AiBoBoMaker/MicroDuck-BoBoRedesign/02-PCB/01-IMU/README.md

# MicroDuck BoBo IMU Module

> 六轴 IMU 模块 — 模拟为 Dynamixel 2.0 设备

## 概述

本目录包含 MicroDuck BoBoRedesign 项目的 **IMU（惯性测量单元）模块** PCB 设计文件。该模块将六轴 IMU 传感器模拟为一个 **Dynamixel 2.0 协议设备**，可直接接入 MicroDuck 的舵机总线，无需额外的通信接口。

> **版本说明：** 当前最新版本（imu_to_dxl）参考自 [kissqy/Microduck-kissqy](https://github.com/kissqy/Microduck-kissqy) 项目，感谢 kissqy 的硬件及固件设计支持。

## 设计文件

| 文件/目录 | 说明 |
|---|---|
| `MicroDuck-BoBo-IMU-2026-09-22.epro2` | IMU 模块初始版本，嘉立创 EDA 专业版工程文件 |
| `MicroDuck-BoBo-imu_to_dxl-2026-10-15.epro2` | IMU 转 Dynamixel 接口版本（最新），嘉立创 EDA 专业版工程文件 |
| `firmware/` | IMU 模块固件目录，含可直接烧录的 `.bin` 文件及完整固件包 |

### 固件文件

| 文件 | 说明 |
|---|---|
| `imu_to_feetech_ReVA_FT6_SYNC15_UART_IRQ_v1.bin` | IMU 转飞特协议固件（Rev.A，FT6 舵机，UART IRQ 模式，v1） |
| `Microduck-Robotd-FT6-R17.tar.gz` | 完整固件包（含飞特 FT6 舵机适配，R17 版本） |

## 打开方式

本项目使用 **嘉立创 EDA 专业版（LCEDA Pro）** 进行设计。

1. 下载安装 [嘉立创 EDA 专业版](https://lceda.cn/page/download)
2. 打开软件，选择 **文件 → 打开工程**
3. 选择 `MicroDuck-BoBo-IMU-2026-09-22.epro2` 文件即可打开

> **注意：** 该文件为 `.epro2` 格式，需要使用嘉立创 EDA **专业版**（Pro）打开，标准版（Std）无法兼容。

## 功能说明

- **六轴 IMU 传感器** — 集成加速度计 + 陀螺仪，提供姿态感知能力
- **Dynamixel 2.0 协议兼容** — 模块在总线上表现为一个标准的 Dynamixel 2.0 设备，可直接使用现有的 Dynamixel 通信库进行读写
- **即插即用** — 无需修改主控固件的通信层，IMU 数据通过 Dynamixel 协议帧传输

## 版本记录

| 版本 | 日期 | 说明 |
|---|---|---|
| v20261015 | 2026-10-15 | 新增 IMU 转 Dynamixel 接口版本（imu_to_dxl），优化通信协议 |
| v20260922 | 2026-09-22 | 初始版本，实现六轴 IMU 模拟为 Dynamixel 2.0 设备 |
