AiBoBoMaker/MicroDuck-BoBoRedesign/03-DuckCode/microduck-hd1910/firmware/policies/README.md

**简体中文** | [English](README.en.md)

R17 v1.0.146 / 官方 0.15.1：唯一 Walk 为 9600 轮行走＋倒地联合模型，全程基础缩放 0.9、头部滤波 0.5、腿部滤波 0.7。旧 14000 轮行走模型从固件删除，仅在 test-data/walk-teacher14000 留作源码数值回归样本。LB 手动起身保留 11000 轮老师（基础 1.0、头腿直通），自动 Stand 槽保持未绑定；起坐、捡取、前滚翻保留。原始训练记录与独立运行配置的执行机制见 ../docs/design/robotd-design.md；导入、唯一槽绑定、旧模型清理和升级保存规则见 ../docs/design/r17-settings-design.md。
