AiBoBoMaker/MicroDuck-BoBoRedesign/03-Code/microduck-hd1910/firmware/BOBO-LICENSE.en.md

# BoBoMaker MicroDuck HD1910 Firmware License

[简体中文](BOBO-LICENSE.md) | **English**

## Project Origin

The firmware code in this directory is developed based on the following projects:

- **[Pollen Robotics Microduck](https://github.com/pollen-robotics/microduck)** — Official Microduck 0.15.1, licensed under [Apache-2.0 License](LICENSE)
- **[kissqy/Microduck-kissqy](https://github.com/kissqy/Microduck-kissqy)** — kissqy's Feetech servo adaptation

Thanks to the official team and kissqy for their open-source contributions. This project has been adapted and modified to support the Feetech HD-1910 servo.

## Purpose

This firmware is used for debugging, calibration, and operation of the MicroDuck robot, accessible via:

- **Android phone / tablet** — Connect to the robot via Web console for debugging and control
- **Desktop browser** — Access the robot's Web interface for calibration, parameter adjustment, and runtime monitoring
- **Gamepad control** — Real-time control via Bluetooth gamepad

## License

- Official Microduck code follows **Apache-2.0 License**
- Third-party components follow their respective original licenses (MIT, Apache-2.0, etc.)
- New adaptation code in this project follows the main project license and is for personal learning, research, and non-commercial use only

## Disclaimer

This project is a personal learning and development project, not an official release. The code may contain unverified parts, and users assume all risks when using it.

---

**Acknowledgments:** Thanks to Pollen Robotics and kissqy for their open-source work that made this project possible.
