AiBoBoMaker/MicroDuck-BoBoRedesign/03-Code/microduck-hd1910/firmware/SELF-TRAINED.zh-CN.md

**简体中文** | [English](SELF-TRAINED.en.md)

R17 v1.0.137 / 官方0.15.1

运行与安装见 console/README.zh-CN.md 和 packaging/README.zh-CN.md。随包模型：粗糙行走老师14000轮、起坐10000轮、低头捡物5000轮、前滚翻10000轮，以及 LB 倒地起身老师11000轮。自动 Stand 为空；LB 使用官方命名技能 stand_test，原地保持使用 Walk。

本次只更换 LB 模型并适配其无滤波合同；原始合同与权重逐字保留。参数来源与逐模型直通机制见 docs/design/r17-settings-design.md。训练标定作为来源记录保留，安装继续使用本机装配标定。
