AiBoBoMaker/MicroDuck-BoBoRedesign/05-BOM/README.md

# MicroDuck BoBoRedesign — 物料清单 (BOM)

> 本项目所需的全部硬件采购清单

## 文件说明

| 文件/目录 | 说明 |
|---|---|
| `MicroDuck购买清单.docx` | 完整购买清单（Word 文档），包含所有物料及可选方案 |
| `01-主板资料整理/` | Radxa ZERO 3W 主板相关资料，含 40pin 引脚说明、原理图及 SMB 设计文件 |

## 购买说明

清单中每个**序号**对应一类物料，部分序号下存在**多个可选项**（如不同型号的舵机、不同规格的轴承、不同方案的驱动板等）。**每个序号只需购买其中一个选项即可**，无需全部购买。

### 示例

以 **序号 2（舵机）** 为例：

| 可选项 | 单价 | 数量 | 总价 |
|---|---|---|---|
| XL330-M288-T（原装） | 258 元 | 15 | 3870 元 |
| HD1910-C001（国产替代） | 99 元 | 15 | 1485 元 |

两种舵机**任选其一**即可。选择国产 HD1910-C001 可大幅降低成本，但需配合本项目的 3D 打印外壳使用。

## 物料总览

| 序号 | 类别 | 说明 |
|---|---|---|
| 1 | 主板 | Radxa ZERO 3W（RK3566） |
| 2 | 舵机 | 原装 XL330 或国产 HD1910-C001（15 个） |
| 3 | TF 卡 | 32G，用于存储系统镜像 |
| 4 | 电源与驱动 | OpenRB-150 / 总线舵机驱动板 / BoBoHat 驱动板（三选一） |
| 5 | IMU | I2C 模块或 BoBo IMU 板 |
| 6 | 3D 打印外壳 | 使用本项目 `01-3DPrint` 中的模型自行打印 |
| 7 | 轴承 | 10×15×3mm 或 16×22×4mm（按需选购） |
| 8 | 螺丝 | 详见文档内明细 |
| 9 | 杜邦线 | 连接各模块用 |

## 工具清单

| 序号 | 工具 | 用途 |
|---|---|---|
| 1 | 螺丝刀 | 组装 |
| 2 | 电烙铁 | PCB 焊接 |

## 主板资料说明

`01-主板资料整理/` 目录包含 Radxa ZERO 3W 主板的相关技术文档：

| 文件 | 说明 |
|---|---|
| `40pin引脚说明.png` | 40pin GPIO 引脚定义图 |
| `radxa_zero_3w_v1.12_schematic.pdf` | Radxa ZERO 3W v1.12 原理图 |
| `radxa_zero_3w_v1110_smb.zip` | Radxa ZERO 3W SMB 设计文件 |

## 更新记录

| 日期 | 内容 |
|---|---|
| 2026-10-12 | 更新购买清单文件名，新增主板资料整理目录 |
| 2026-09-23 | 更新 Radxa 3W 2G+0EMMC 版本，价格降至 299 元 |
