AiBoBoMaker/MicroDuck-BoBoRedesign/05-BOM/MicroDuck购买清单.md

# MicroDuck 购买清单

## 购买清单

**更新记录：**
20260923:更新 Redax 3W 2G+0EMMC 299元版本，比之前下降了50元。

| 序号 | 产品 | 可选项 | 价格 | 链接 | 备注 |
| --- | --- | --- | --- | --- | --- |
| 1 | 主板 | Redax 3W 2G+0EMMC | 299元 | https://item.taobao.com/item.htm?id=763812025816 | 配置：2GB RAM / 无eMMC / 带排针（【Microduck 原版主板】）；同款历史参考价 ¥309.00 |
| 2 | 舵机 | XL330-M288-T | 258*15=3870 | 暂无货 | 与下行 HD1910-C001 二选一 |
|  |  | HD1910-C001 | 119*15=1785 | https://item.taobao.com/item.htm?id=1078248851201 | 款式 HD-1910-C001；深圳飞特舵机工厂店；[团购99元/个]，需要的话可以加下方作者微信 |
| 3 | tf卡 | 32G | 30元 | 狗东到处都是 |  |
| 4 | 双电源供电和舵机驱动 | OpenRB150 | 265元 | https://item.taobao.com/item.htm?id=683303639951 |  |
|  |  | 总线舵机驱动板 | 26.73元 | https://item.taobao.com/item.htm?id=738817173460 |  |
|  |  | Hat驱动板 | 119元 | 已测试 | 据最新版本在官方版本上精简了线路 |
|  |  | 舵机Hub电源优化板 | 69元 | 已测试 | 可以将4路舵机总线合并为一条与HAT连接，并且加入大电容避免鸭子重启断电 |
| 5 | IMU | I2C | 26 | https://item.taobao.com/item.htm?id=1080835106904 | 程序自动切换 |
|  |  | BoBo IMU板 | 89元 | 走飞特的总线协议 | 程序自动切换 |
| 6 | 轴承 | 10*15*3mm | 0.97元*5 | https://item.taobao.com/item.htm?id=745755245799 | 对应 6700 开式【轴承钢·精品级】10\*15\*3MM；参考数量 5 只（¥1.94/只，小计 ¥9.70）；尺寸顺序为内径×外径×宽度 |
|  |  | 16*22*4mm | 2.91元*12 | https://item.taobao.com/item.htm?id=745843714288 | 对应 ET2216【精品级】16\*22\*4MM[轴承钢]；参考数量 12 只（¥2.91/只，小计 ¥34.92）；尺寸顺序为内径×外径×宽度 |
|  |  | 623ZZ（623 内3外10厚4） | 1.50元*8  | https://item.taobao.com/item.htm?id=618009195719 | 滑轮选配 |
| 7 | 螺丝 | M2*7 沉头 |  | 100 |  |
|  |  | M2.5*8 内六角 |  | 12 |  |
| 9 | 摄像头 | IMX219 160度摄像头（SKU：IMX219 160度摄像头） | 64.35元/个 ×1＝64.35元 | https://item.taobao.com/item.htm?id=1083291197130&skuId=6300750750661 | 树莓派零售商；实际价格以下单时为准 |
| 10 | 测距 | 8×8 ToF 模块（VL53L5X V2 配盖片，商品标题 VL53L5CX） | 49.50元/个 ×1＝49.50元 | https://item.taobao.com/item.htm?id=737603917521 | 外接模块，不是 PCB 上的裸芯片；都会明武电子；接线和供电按已验证方案 |
| 11 | 扬声器 | 3525 腔体 / 4Ω 3W | 3.08元/个 ×1＝3.08元 | https://item.taobao.com/item.htm?id=683920556900 | 深圳市优信电子科技有限公司；确认插头与所购 HAT 接口匹配，使用对应成品线或成品转接线 |
| 12 | 手柄 | 盖世小鸡启明星2无线游戏手柄（蓝牙 / Xbox 模式） | 89.91元/个 ×1＝89.91元 | https://item.taobao.com/item.htm?id=825069839018 | 颜色及套装内容以商品页为准 |
| 13 | 电池 | NP-F550 电池与双充套装（沣标 2200mAh，2 电＋标准双充） | 84.59元/套 ×1＝84.59元 | https://item.taobao.com/item.htm?id=585415365001 | 原文款式：【NP-F550补光灯专用▲2200mAh】2电+标准双充套裝；可用 XH2.54 电源线接电池仓 M2.6 螺丝触点，或直接插接电压极性匹配的 XH2.54 电池，或将 XH2.54 电源线焊到香蕉板取电；电池接入配件与运费另计 |
| 14 | 舵机线 | AMP2.0 3P 舵机线 20cm（双头反向） | 1.50元/条 ×30＝45.00元 | https://item.taobao.com/item.htm?id=825340808235 | 200mm / 1007 / 24AWG / 3P / AMP2.0；永茂电子；数量含备料，10cm 与 20cm 按实际走线位置选择 |
| 15 | 舵机线 | AMP2.0 3P 舵机线 10cm（双头反向） | 1.50元/条 ×30＝45.00元 | https://item.taobao.com/item.htm?id=825340808235 | 100mm / 1007 / 24AWG / 3P / AMP2.0；数量按实际线束方案准备，与 20cm 是不同长度选项 |

## 交流入口

选型、渠道和采购数量上有拿不准的地方，欢迎加微信直接问；点击图片可查看原图。

BoBoMaker 微信二维码
