AiBoBoMaker/MicroDuck-BoBoRedesign/05-BOM/MicroDuck购买清单.docx

购买清单：

更新记录：
20260923:更新 Redax 3W 2G+0EMMC 299元版本，比之前下降了50元。

序号 | 产品 | 可选项 | 价格 | 链接
1 | 主板 | Redax 3W 2G+0EMMC | 299元 | 【淘宝】升级版运费险 https://e.tb.cn/h.8FfZDadQV5C0b2X?tk=LW8CTlPJnJu CZ009 「瑞莎 Radxa 迷你主板 ZERO 3W RK3566 四核CPU WiFi6 Microduck」 点击链接直接打开 或者 淘宝搜索直接打开
2 | 舵机 | XL330-M288-T | 258*15=3870 | 暂无货
| | HD1910-C001 | 99*15=1485 | 【淘宝】7天无理由退货 https://e.tb.cn/h.8vlnLBm3vsoUvdQ?tk=07A0TllYnvq CZ001 「【预售15天】飞特金属齿机器鸭具身智能开源AI专用串口总线舵机」 点击链接直接打开 或者 淘宝搜索直接打开
3 | tf卡 | 32G | 30元
4 | 双电源供电和舵机驱动 | OpenRB150 | 265元 | 【淘宝】7天无理由退货 https://e.tb.cn/h.8FfW52mcYxoCk1K?tk=wsicTlPE6Pt HU926 「OPENRB-150 开源Arduino嵌入式控制器open RB-150 XL330用 RB 150」 点击链接直接打开 或者 淘宝搜索直接打开
| | 总线舵机驱动板 | 26.73元 | 【淘宝】假一赔四 https://e.tb.cn/h.8wbdGcaYUUTWSvW?tk=4T19TlPs9R9 HU287 「微雪 总线舵机驱动板适用ST/SC系列Servo UART通信支持树莓派4」 点击链接直接打开 或者 淘宝搜索直接打开
| | BoBoHat驱动板 | 40元 | 待测试
5 | IMU | I2C | 26 | 【淘宝】7天无理由退货 https://e.tb.cn/h.jb5fw9IyarVb7lf?tk=2L9MTr3N0dO CZ028 「LSM6DSV16XTR加速度6DOF六轴IMU陀螺仪传感器模块兼容ROS WDS601M」 点击链接直接打开 或者 淘宝搜索直接打开
| | BoBo IMU板 | 25元 | 程序通，经测试存在一定问题，需要修正数据
6 | 3D打印外壳 | 见项目文件 | 约50元
7 | 轴承 | 10*15*3mm | 0.97元* | 【淘宝】7天无理由退货 https://e.tb.cn/h.8vl9a2x4N8zy9sn?tk=q1uGTlPxIwN tG-#22>lD 「高速不锈钢薄壁轴承61700ZZ S6700-2RS 尺寸10*15*4*3mm 6700开式」 点击链接直接打开 或者 淘宝搜索直接打开
| | 16*22*4mm | 2.91元* | 【淘宝】7天无理由退货 https://e.tb.cn/h.8u4OdDKUHmoniC8?tk=qjSqTlPygf9 HU071 「不锈钢英制超薄壁轴承SET2216 DDA2216 MR1622 16224尺寸16*22*4」 点击链接直接打开 或者 淘宝搜索直接打开
8 | 螺丝 | M2*
9 | 杜邦线 | 3米
10 | 电池 | 2s 7.4v电池 | 56元 | 【淘宝】假一赔四 https://e.tb.cn/h.jZrMAQfANkdKbLP?tk=s0bFTr3pWLN HU006 「7.4V锂电池组2S 18650智能车机器人舵机多足8.4V带保护板电源塔克」 点击链接直接打开 或者 淘宝搜索直接打开

工具类

1 | 螺丝刀
2 | 电烙铁
3 | 热缩管
