AiBoBoMaker/MicroDuck-BoBoRedesign/05-BOM/01-主板资料整理/40pin引脚说明.png

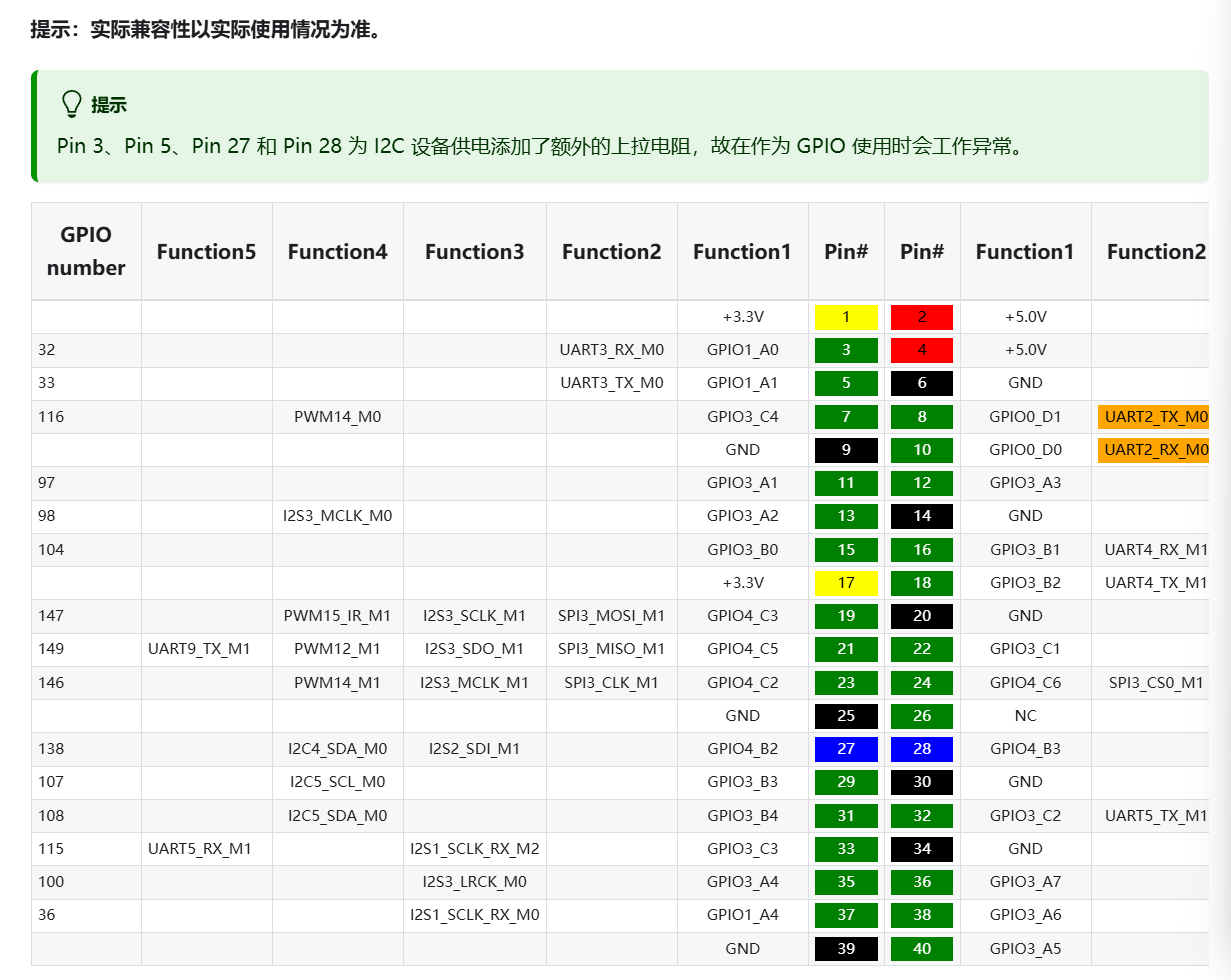
05-BOM/01-主板资料整理/40pin引脚说明.png
