AiBoBoMaker/MicroDuck-BoBoRedesign/01-3DPrint/01-XL330-M288-T/左大腿_白色x2.stl

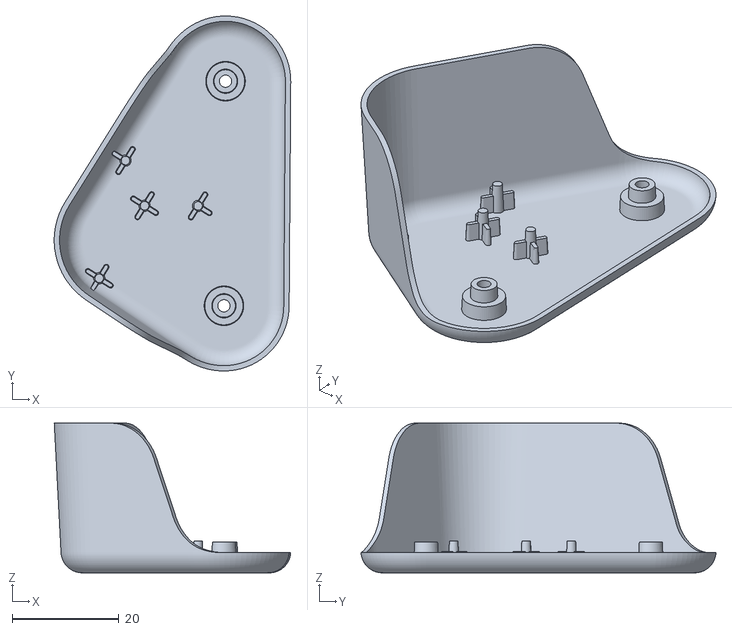
[picture p4: CAD file, 2026-09-24]
01-3DPrint/01-XL330-M288-T/左大腿_白色x2.stl
44.2 x 66.4 x 28.0
