AiBoBoMaker/MicroDuck-BoBoRedesign/01-3DPrint/02-HD-1910-C001/stl模型/TPU部分/滑轮.stl

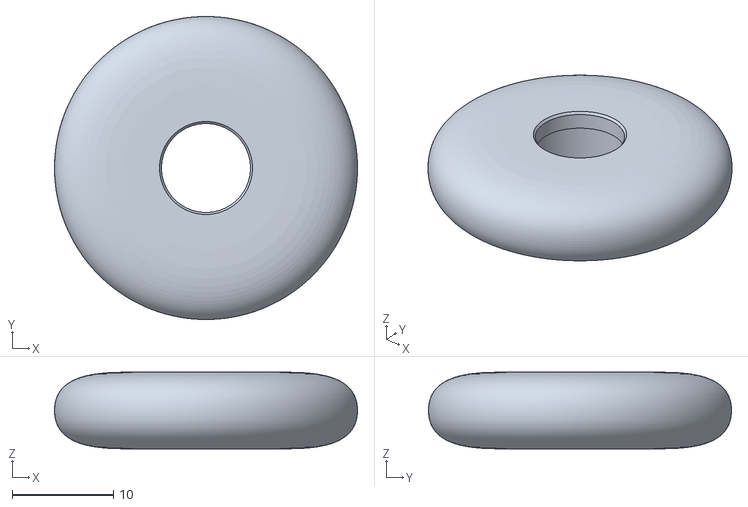
[picture p5: CAD file, 2026-10-23]
01-3DPrint/02-HD-1910-C001/stl模型/TPU部分/滑轮.stl
30.0 x 30.0 x 7.60
