AiBoBoMaker/MicroDuck-BoBoRedesign/01-3DPrint/02-HD-1910-C001/stl模型/支撑部分/右膝支撑.stl

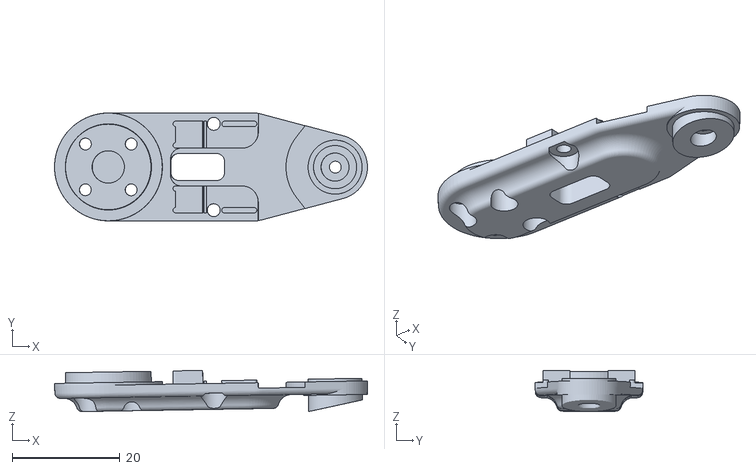
[picture p6: CAD file, 2026-10-23]
01-3DPrint/02-HD-1910-C001/stl模型/支撑部分/右膝支撑.stl
58.0 x 20.0 x 7.63
