AiBoBoMaker/MicroDuck-BoBoRedesign/01-3DPrint/02-HD-1910-C001/stl模型/橙色部分/头部集成板.stl

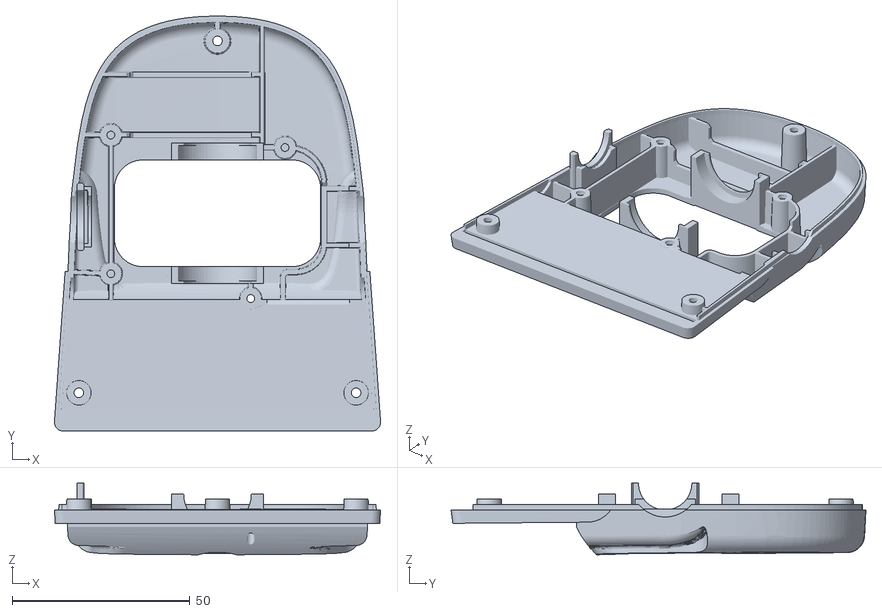
[picture p7: CAD file, 2026-10-23]
01-3DPrint/02-HD-1910-C001/stl模型/橙色部分/头部集成板.stl
91.8 x 116.7 x 20.1
