AiBoBoMaker/MicroDuck-BoBoRedesign/01-3DPrint/02-HD-1910-C001/stl模型/躯体部分/左胯外盖.stl

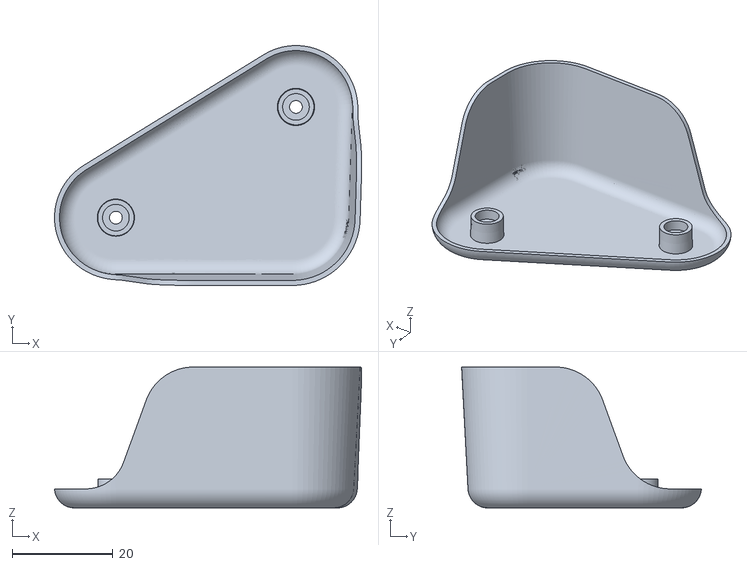
[picture p8: CAD file, 2026-10-23]
01-3DPrint/02-HD-1910-C001/stl模型/躯体部分/左胯外盖.stl
61.0 x 47.7 x 28.0
