AiBoBoMaker/MicroDuck-BoBoRedesign/01-3DPrint/02-HD-1910-C001/老版/小腿固定件x2.stl

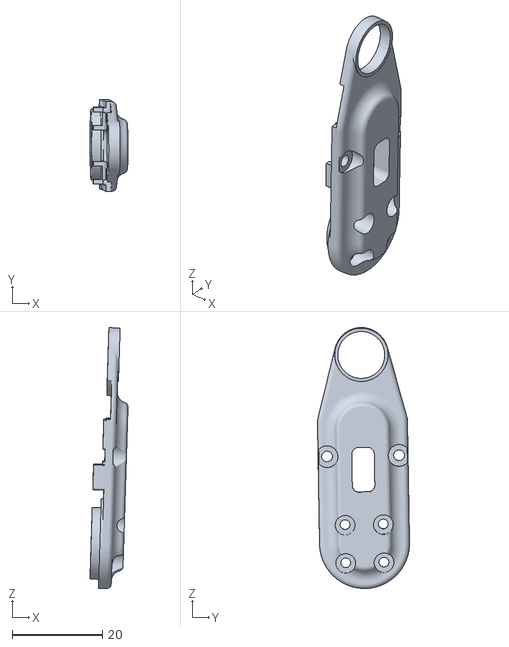
[picture p9: CAD file, 2026-09-19]
01-3DPrint/02-HD-1910-C001/老版/小腿固定件x2.stl
8.45 x 20.5 x 58.0
