AiBoBoMaker/MicroDuck-BoBoRedesign/01-3DPrint/0位支架.stp

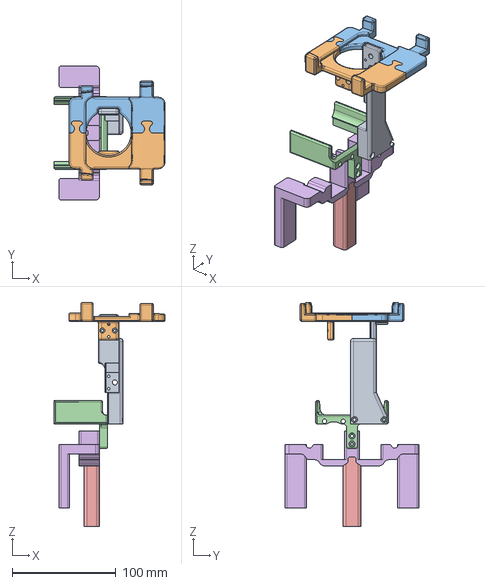
[picture p10: CAD file, 2026-11-11]
01-3DPrint/0位支架.stp
106.7 x 129.0 x 215.8 mm
