AiBoBoMaker/MicroDuck-BoBoRedesign/01-3DPrint/02-HD-1910-C001/stl模型/支撑部分/颈部固定左.stl

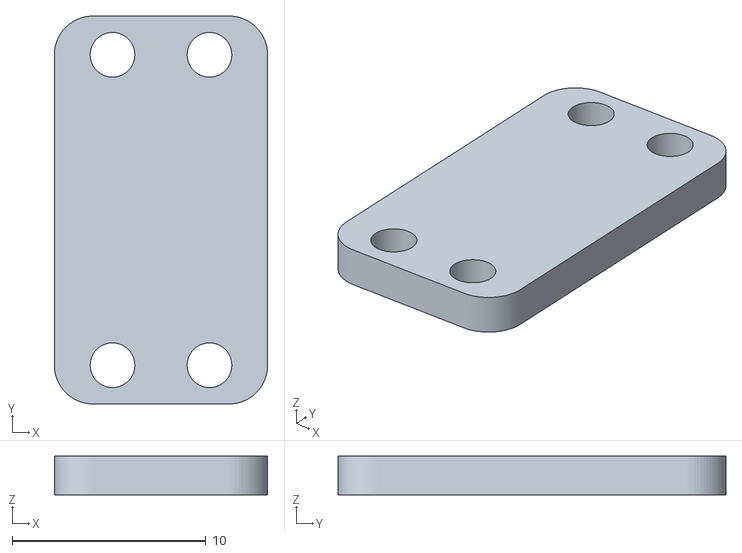
[picture p11: CAD file, 2026-10-23]
01-3DPrint/02-HD-1910-C001/stl模型/支撑部分/颈部固定左.stl
11.0 x 20.0 x 2.00
