AiBoBoMaker/MicroDuck-BoBoRedesign/01-3DPrint/02-HD-1910-C001/stl模型/橙色部分/右脚.stl

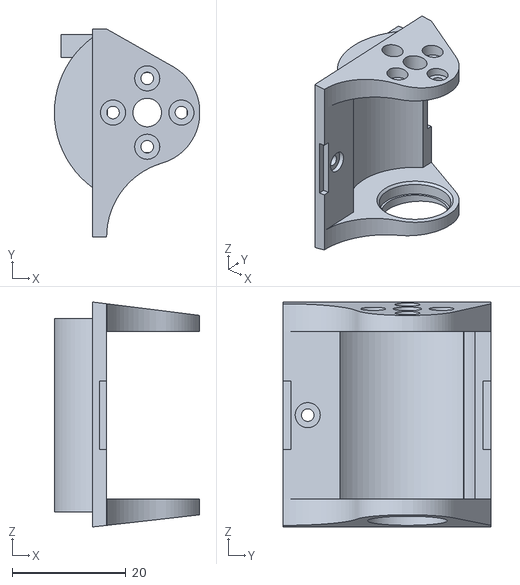
[picture p12: CAD file, 2026-10-23]
01-3DPrint/02-HD-1910-C001/stl模型/橙色部分/右脚.stl
25.5 x 36.5 x 39.5
