AiBoBoMaker/MicroDuck-BoBoRedesign/01-3DPrint/02-HD-1910-C001/stl模型/黑色部分/屁托.dxf

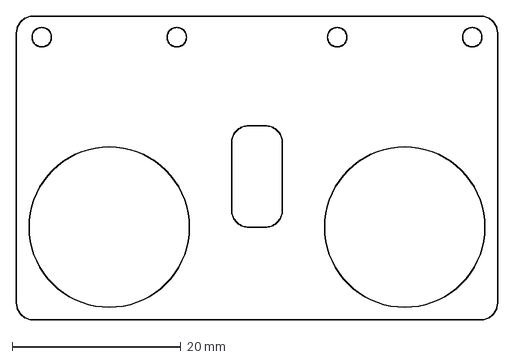
[picture p13: CAD file, 2026-11-11]
01-3DPrint/02-HD-1910-C001/stl模型/黑色部分/屁托.dxf
57.0 x 36.0 mm
