AiBoBoMaker/MicroDuck-BoBoRedesign/01-3DPrint/02-HD-1910-C001/老版/右脚x1.stl

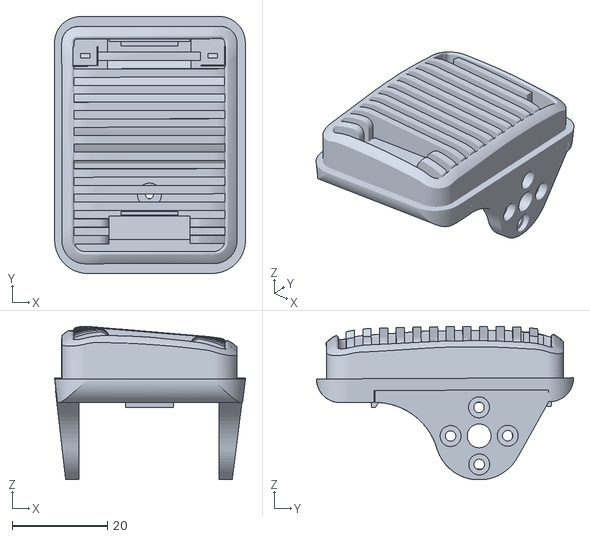
[picture p14: CAD file, 2026-09-19]
01-3DPrint/02-HD-1910-C001/老版/右脚x1.stl
40.1 x 54.0 x 32.2
