AiBoBoMaker/MicroDuck-BoBoRedesign/01-3DPrint/01-XL330-M288-T/右脚x1.stl

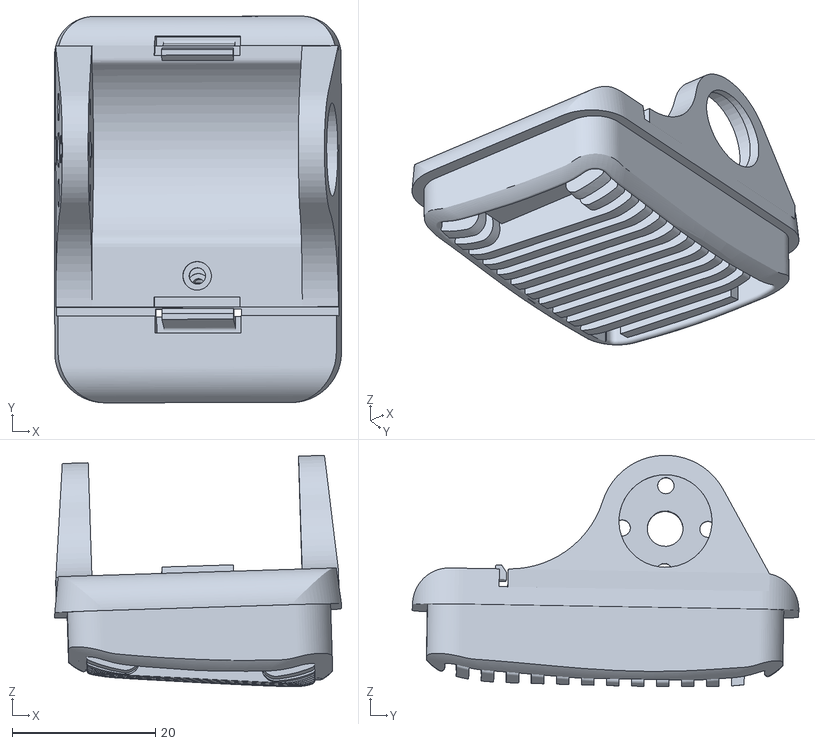
[picture p15: CAD file, 2026-09-24]
01-3DPrint/01-XL330-M288-T/右脚x1.stl
40.1 x 54.0 x 32.3
