AiBoBoMaker/MicroDuck-BoBoRedesign/01-3DPrint/02-HD-1910-C001/stl模型/支撑部分/头部旋转.stl

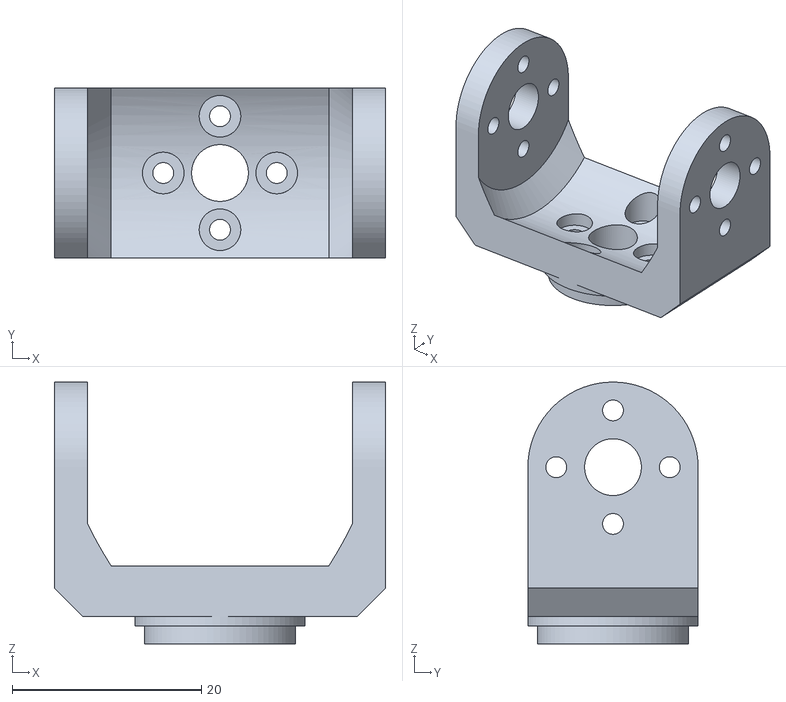
[picture p16: CAD file, 2026-10-23]
01-3DPrint/02-HD-1910-C001/stl模型/支撑部分/头部旋转.stl
35.0 x 18.0 x 27.7
