AiBoBoMaker/MicroDuck-BoBoRedesign/01-3DPrint/02-HD-1910-C001/stl模型/躯体部分/电池仓_M2.5螺丝_HUB组合.stl

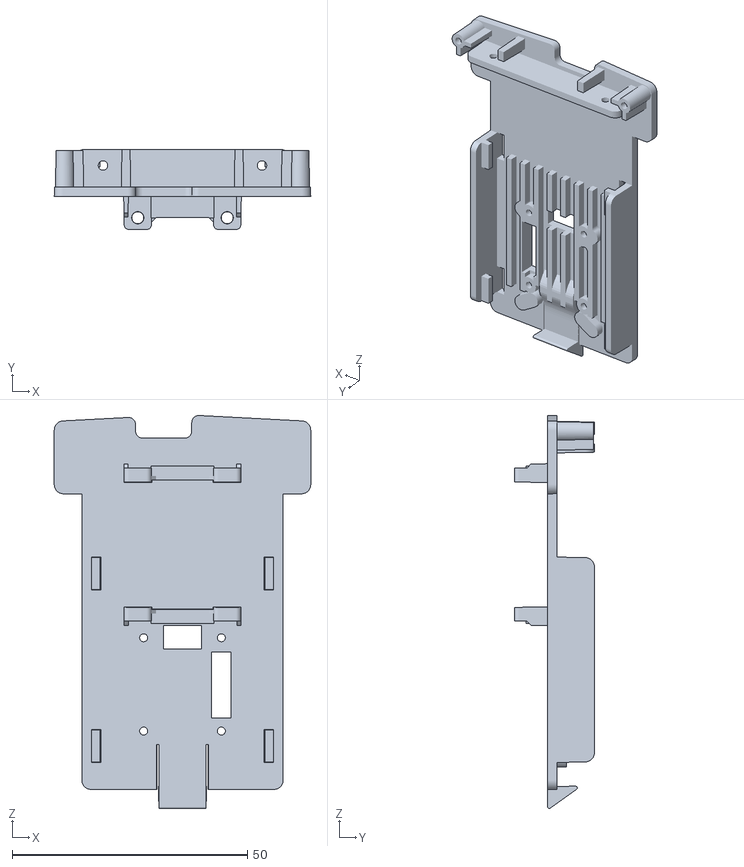
[picture p17: CAD file, 2026-10-23]
01-3DPrint/02-HD-1910-C001/stl模型/躯体部分/电池仓_M2.5螺丝_HUB组合.stl
54.5 x 17.0 x 83.5
