AiBoBoMaker/MicroDuck-BoBoRedesign/01-3DPrint/02-HD-1910-C001/stl模型/黑色部分/腿 .dxf

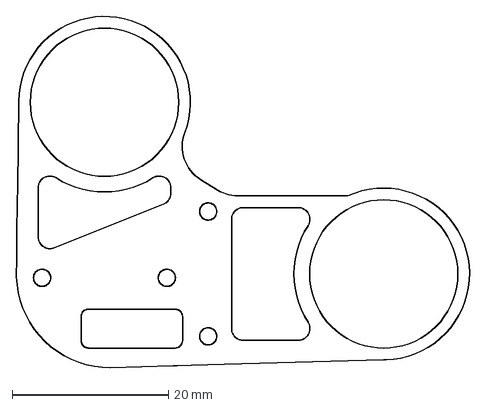
[picture p18: CAD file, 2026-11-11]
01-3DPrint/02-HD-1910-C001/stl模型/黑色部分/腿 .dxf
58.1 x 45.0 mm
