AiBoBoMaker/MicroDuck-BoBoRedesign/01-3DPrint/02-HD-1910-C001/老版/躯干舵机底座x1.stl

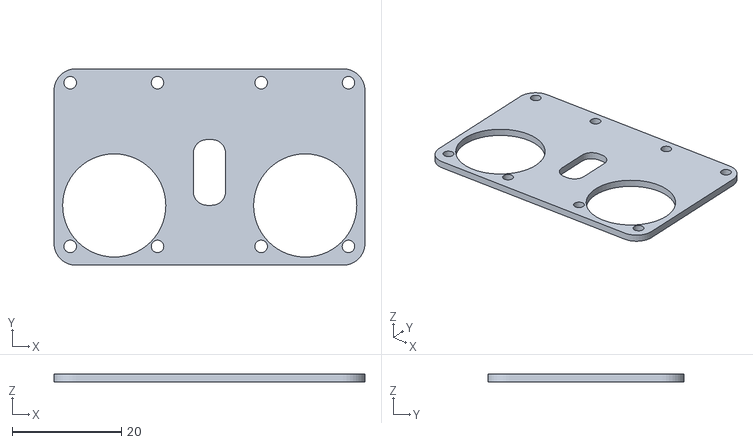
[picture p19: CAD file, 2026-09-19]
01-3DPrint/02-HD-1910-C001/老版/躯干舵机底座x1.stl
57.0 x 36.0 x 1.50
