AiBoBoMaker/MicroDuck-BoBoRedesign/01-3DPrint/01-XL330-M288-T/舵盘x4.stl

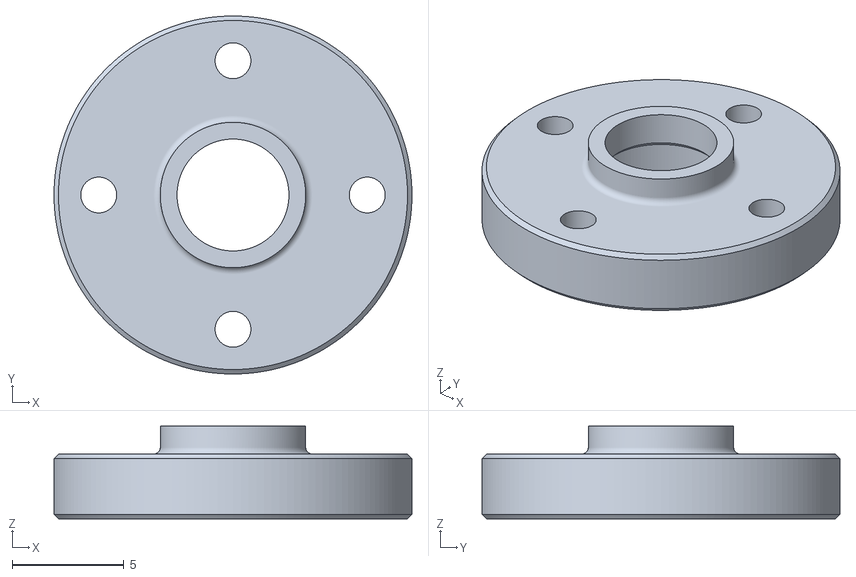
[picture p20: CAD file, 2026-09-24]
01-3DPrint/01-XL330-M288-T/舵盘x4.stl
16.0 x 16.0 x 4.15
