AiBoBoMaker/MicroDuck-BoBoRedesign/01-3DPrint/02-HD-1910-C001/stl模型/橙色部分/滑轮支架左.stl

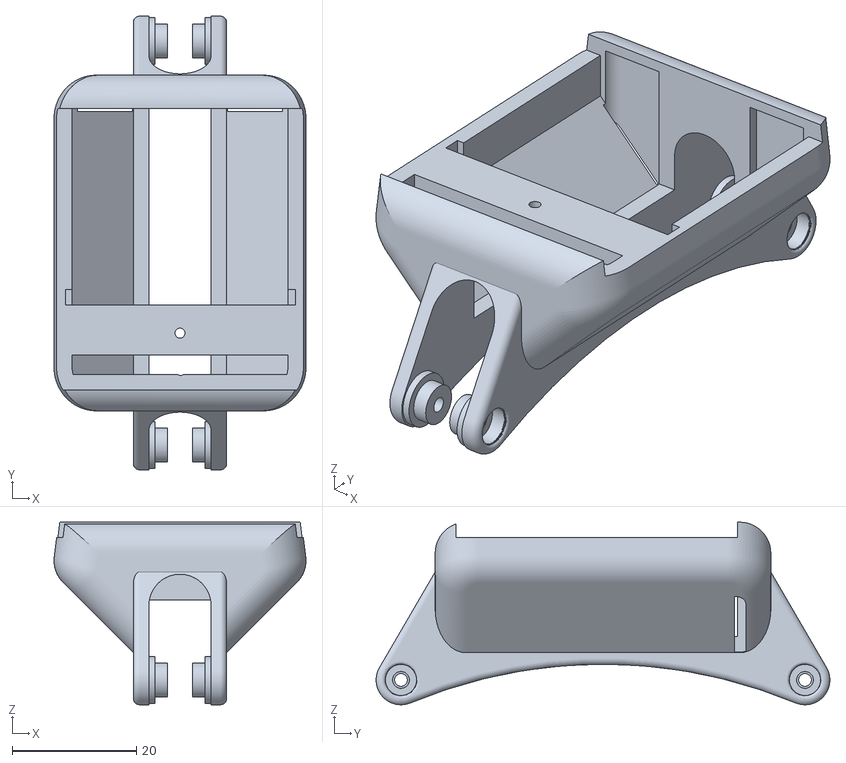
[picture p21: CAD file, 2026-10-23]
01-3DPrint/02-HD-1910-C001/stl模型/橙色部分/滑轮支架左.stl
40.5 x 73.0 x 29.4
