AiBoBoMaker/MicroDuck-BoBoRedesign/01-3DPrint/02-HD-1910-C001/stl模型/躯体部分/右壳.stl

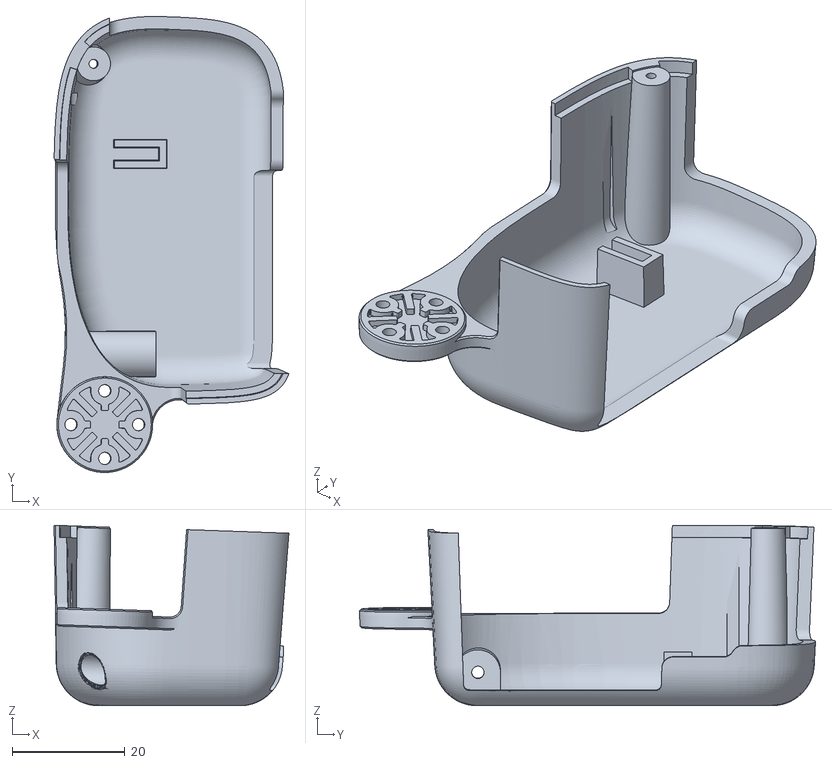
[picture p22: CAD file, 2026-10-23]
01-3DPrint/02-HD-1910-C001/stl模型/躯体部分/右壳.stl
41.7 x 80.9 x 32.0
