AiBoBoMaker/MicroDuck-BoBoRedesign/01-3DPrint/02-HD-1910-C001/stl模型/黑色部分/左腿固定片2.stl

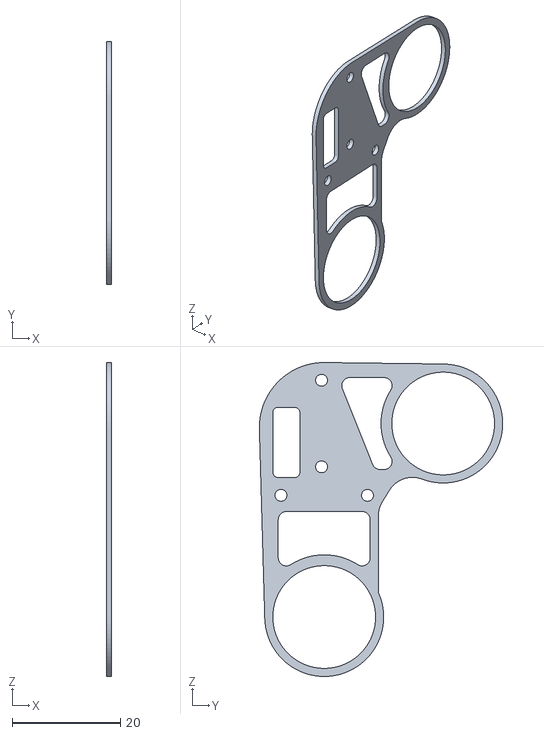
[picture p23: CAD file, 2026-11-11]
01-3DPrint/02-HD-1910-C001/stl模型/黑色部分/左腿固定片2.stl
1.00 x 45.0 x 58.1
