AiBoBoMaker/MicroDuck-BoBoRedesign/01-3DPrint/02-HD-1910-C001/老版/电池支撑架x1.stl

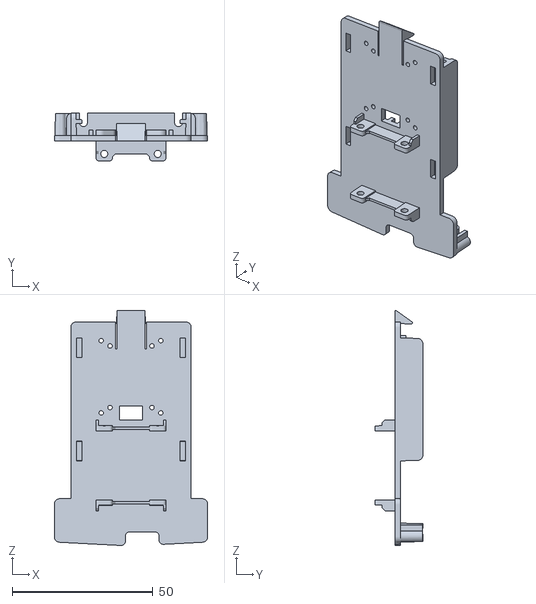
[picture p24: CAD file, 2026-09-19]
01-3DPrint/02-HD-1910-C001/老版/电池支撑架x1.stl
54.5 x 17.0 x 83.5
