AiBoBoMaker/MicroDuck-BoBoRedesign/01-3DPrint/01-XL330-M288-T/大腿根x2.stl

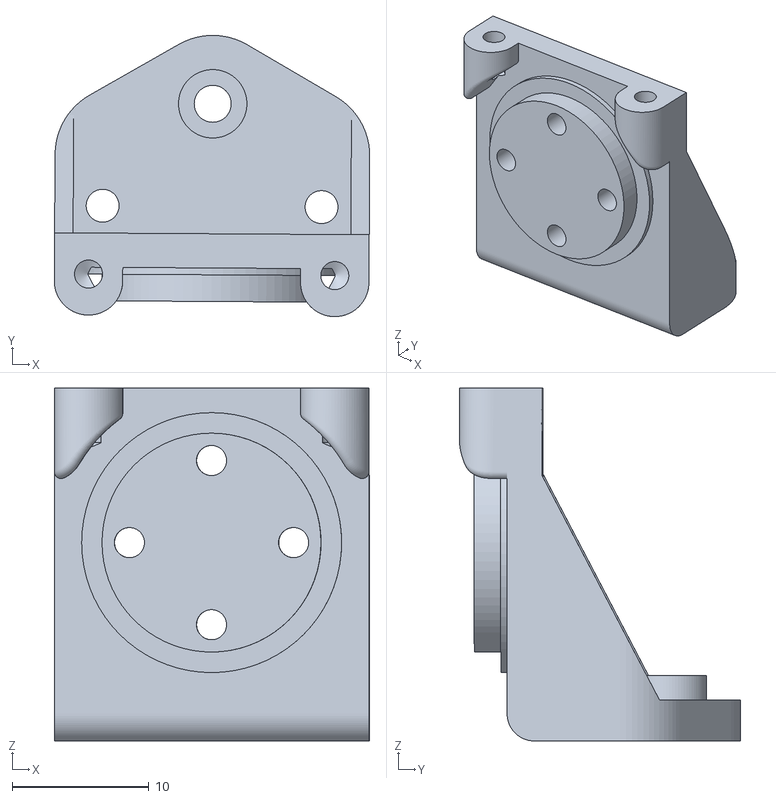
[picture p25: CAD file, 2026-09-24]
01-3DPrint/01-XL330-M288-T/大腿根x2.stl
23.1 x 20.6 x 25.8
