AiBoBoMaker/MicroDuck-BoBoRedesign/01-3DPrint/02-HD-1910-C001/stl模型/支撑部分/脸.stl

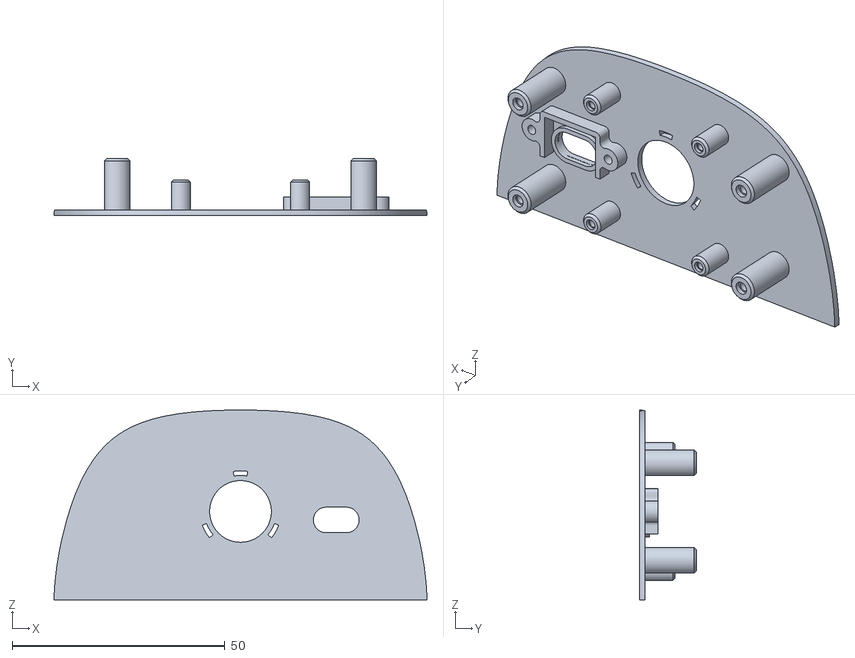
[picture p26: CAD file, 2026-10-23]
01-3DPrint/02-HD-1910-C001/stl模型/支撑部分/脸.stl
87.7 x 13.3 x 44.6
