AiBoBoMaker/MicroDuck-BoBoRedesign/01-3DPrint/02-HD-1910-C001/stl模型/橙色部分/左脚掌.stl

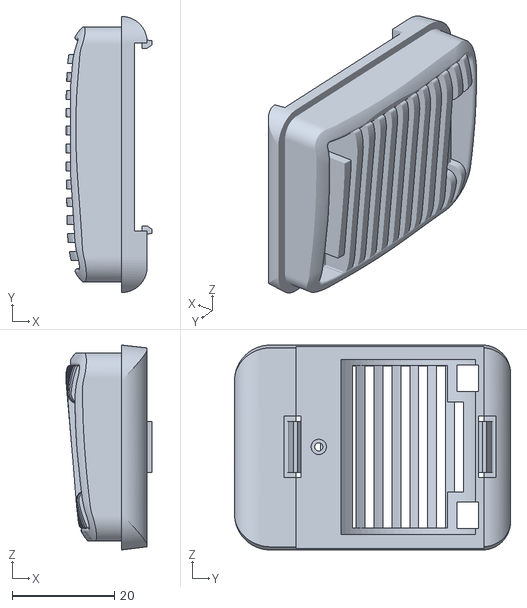
[picture p27: CAD file, 2026-10-23]
01-3DPrint/02-HD-1910-C001/stl模型/橙色部分/左脚掌.stl
16.9 x 54.0 x 40.1
