AiBoBoMaker/MicroDuck-BoBoRedesign/01-3DPrint/02-HD-1910-C001/stl模型/躯体部分/左壳.stl

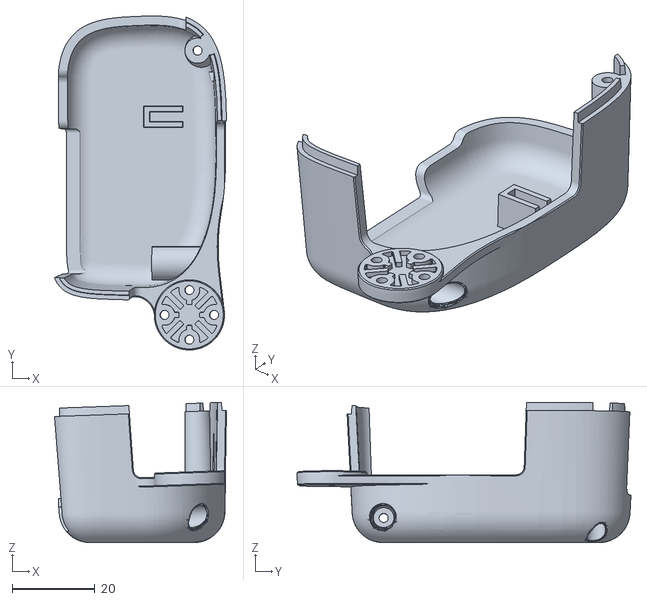
[picture p28: CAD file, 2026-10-23]
01-3DPrint/02-HD-1910-C001/stl模型/躯体部分/左壳.stl
41.7 x 80.9 x 34.0
