AiBoBoMaker/MicroDuck-BoBoRedesign/01-3DPrint/02-HD-1910-C001/stl模型/黑色部分/右胯旋转.stl

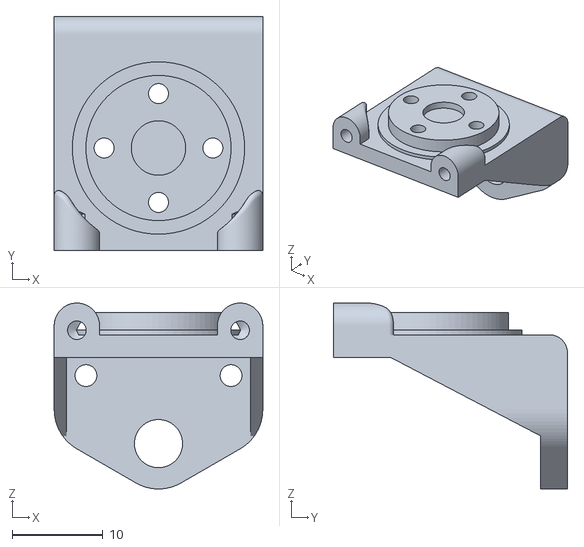
[picture p29: CAD file, 2026-10-23]
01-3DPrint/02-HD-1910-C001/stl模型/黑色部分/右胯旋转.stl
23.0 x 25.8 x 20.5
