AiBoBoMaker/MicroDuck-BoBoRedesign/01-3DPrint/02-HD-1910-C001/老版/大腿根x2.stl

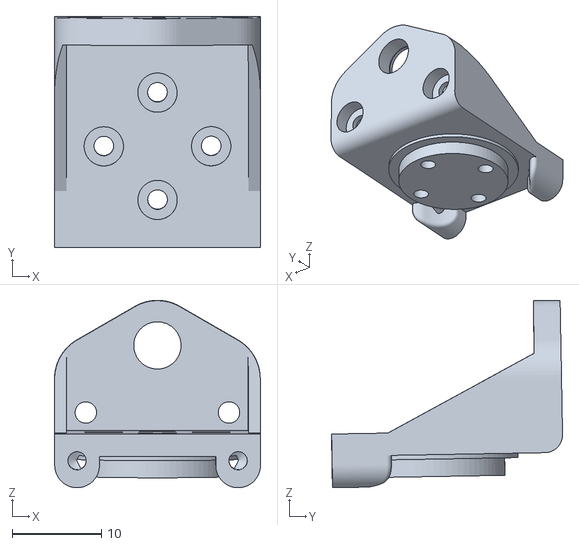
[picture p30: CAD file, 2026-09-19]
01-3DPrint/02-HD-1910-C001/老版/大腿根x2.stl
23.0 x 25.8 x 20.9
