AiBoBoMaker/MicroDuck-BoBoRedesign/01-3DPrint/01-XL330-M288-T/左脚底板x1.stl

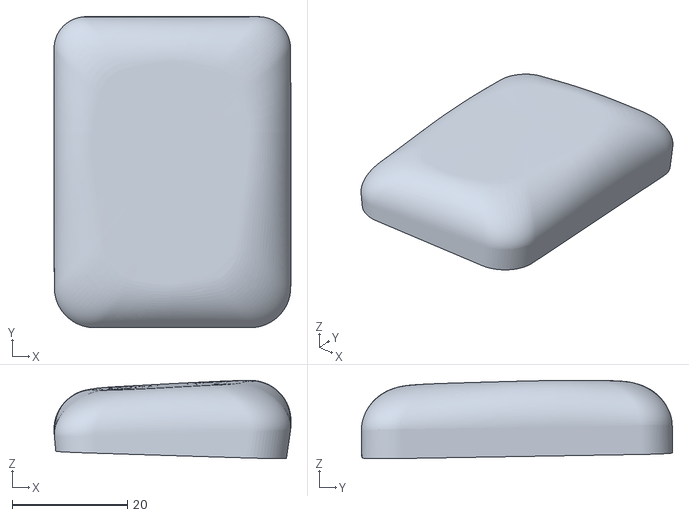
[picture p31: CAD file, 2026-09-19]
01-3DPrint/01-XL330-M288-T/左脚底板x1.stl
41.2 x 54.1 x 13.6
