AiBoBoMaker/MicroDuck-BoBoRedesign/01-3DPrint/02-HD-1910-C001/stl模型/橙色部分/眼睛.stl

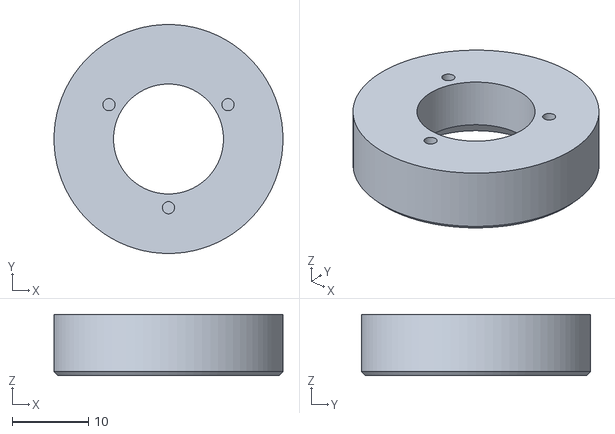
[picture p32: CAD file, 2026-10-23]
01-3DPrint/02-HD-1910-C001/stl模型/橙色部分/眼睛.stl
30.0 x 30.0 x 8.00
