AiBoBoMaker/MicroDuck-BoBoRedesign/01-3DPrint/02-HD-1910-C001/stl模型/躯体部分/头盖.stl

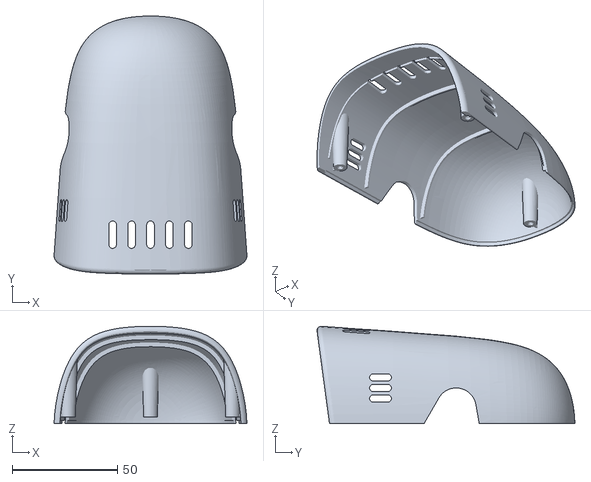
[picture p33: CAD file, 2026-10-23]
01-3DPrint/02-HD-1910-C001/stl模型/躯体部分/头盖.stl
91.8 x 122.7 x 46.3
