AiBoBoMaker/MicroDuck-BoBoRedesign/01-3DPrint/02-HD-1910-C001/stl模型/黑色部分/头部侧倾.stl

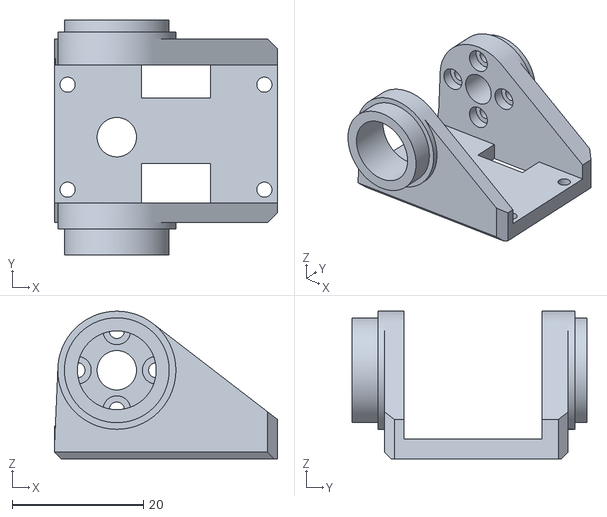
[picture p34: CAD file, 2026-10-23]
01-3DPrint/02-HD-1910-C001/stl模型/黑色部分/头部侧倾.stl
34.0 x 35.9 x 22.5
