AiBoBoMaker/MicroDuck-BoBoRedesign/01-3DPrint/02-HD-1910-C001/老版/右腿内测x1.stl

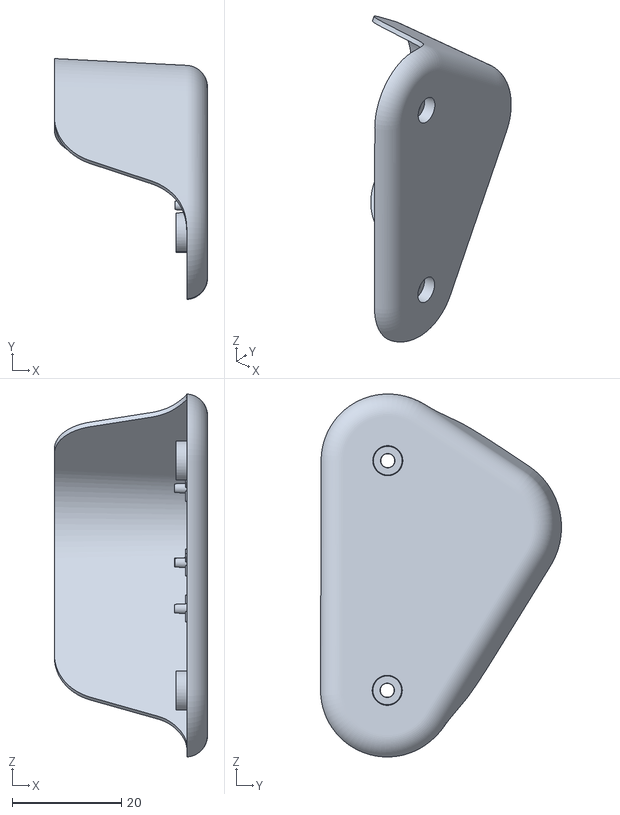
[picture p35: CAD file, 2026-09-19]
01-3DPrint/02-HD-1910-C001/老版/右腿内测x1.stl
28.0 x 44.1 x 66.4
