AiBoBoMaker/MicroDuck-BoBoRedesign/01-3DPrint/01-XL330-M288-T/前脸x1.stl

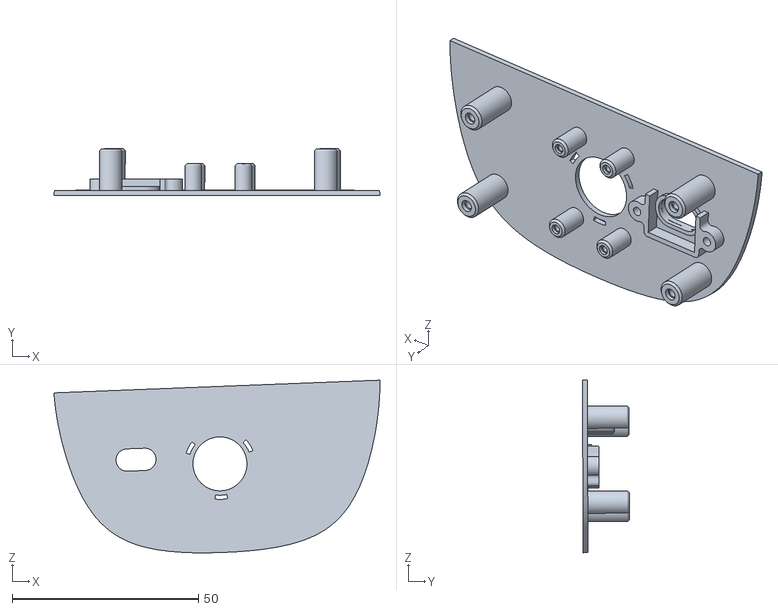
[picture p36: CAD file, 2026-09-19]
01-3DPrint/01-XL330-M288-T/前脸x1.stl
87.6 x 12.7 x 46.4
