AiBoBoMaker/MicroDuck-BoBoRedesign/01-3DPrint/02-HD-1910-C001/老版/大腿固定件x2.stl

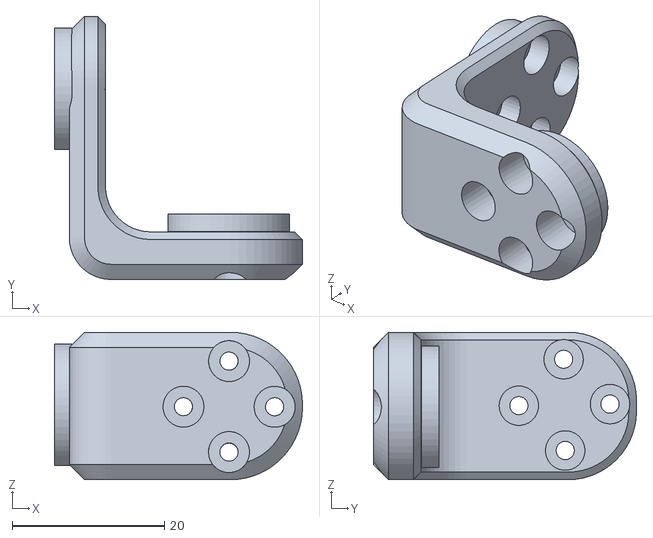
[picture p37: CAD file, 2026-09-19]
01-3DPrint/02-HD-1910-C001/老版/大腿固定件x2.stl
32.6 x 34.6 x 19.4
