AiBoBoMaker/MicroDuck-BoBoRedesign/01-3DPrint/01-XL330-M288-T/头盖骨x1.stl

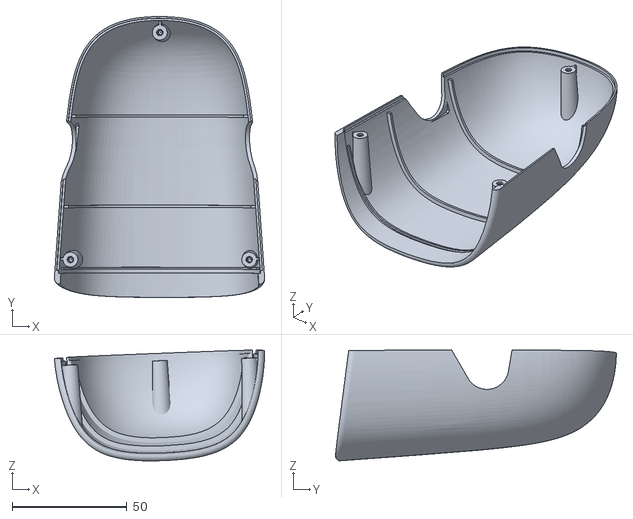
[picture p38: CAD file, 2026-09-19]
01-3DPrint/01-XL330-M288-T/头盖骨x1.stl
91.7 x 122.5 x 48.3
