AiBoBoMaker/MicroDuck-BoBoRedesign/01-3DPrint/02-HD-1910-C001/老版/左右腿内测x2.stl

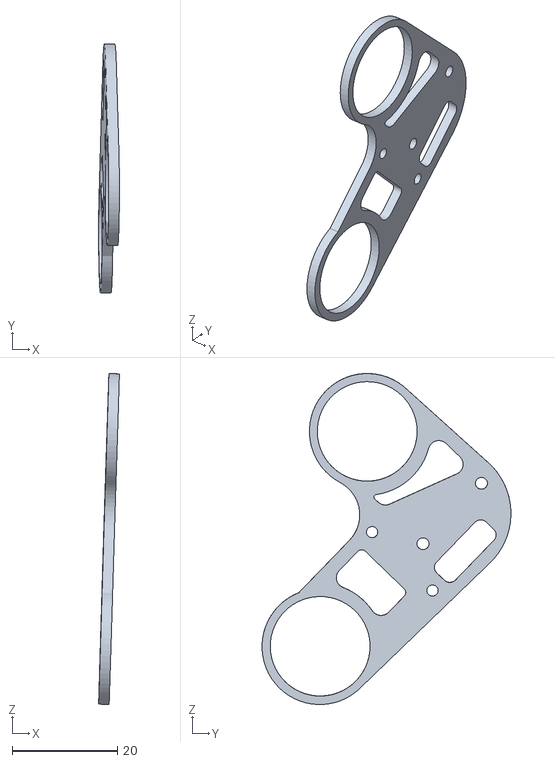
[picture p39: CAD file, 2026-09-19]
01-3DPrint/02-HD-1910-C001/老版/左右腿内测x2.stl
3.96 x 47.4 x 63.0
