AiBoBoMaker/MicroDuck-BoBoRedesign/01-3DPrint/01-XL330-M288-T/踝关节固定件x2.stl

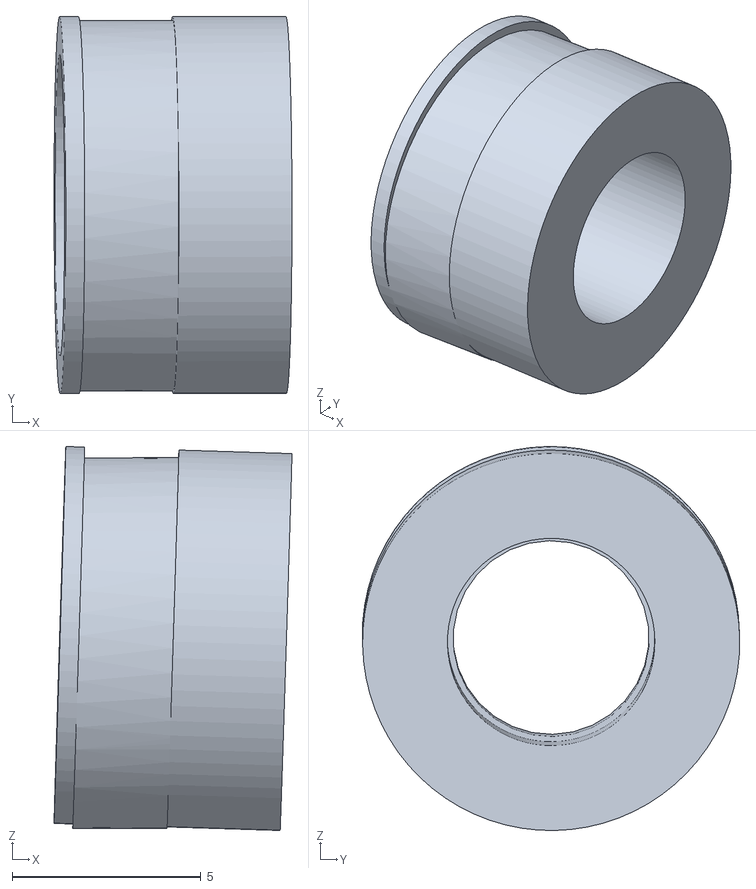
[picture p40: CAD file, 2026-09-19]
01-3DPrint/01-XL330-M288-T/踝关节固定件x2.stl
6.31 x 10.0 x 10.2
