AiBoBoMaker/MicroDuck-BoBoRedesign/01-3DPrint/01-XL330-M288-T/头内部固定件x1.stl

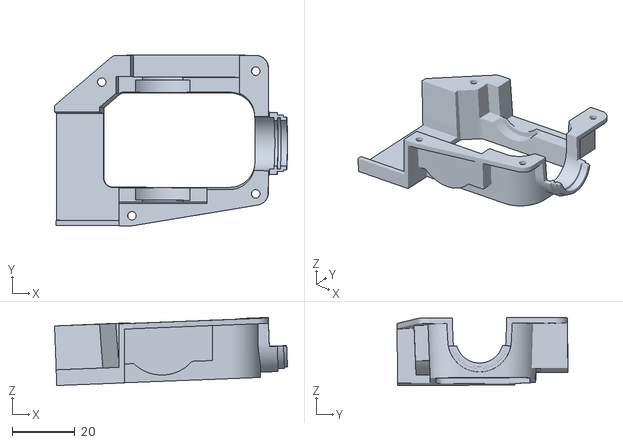
[picture p41: CAD file, 2026-09-19]
01-3DPrint/01-XL330-M288-T/头内部固定件x1.stl
74.1 x 54.3 x 21.6
