AiBoBoMaker/MicroDuck-BoBoRedesign/01-3DPrint/01-XL330-M288-T/大腿轴承固定件x2.stl

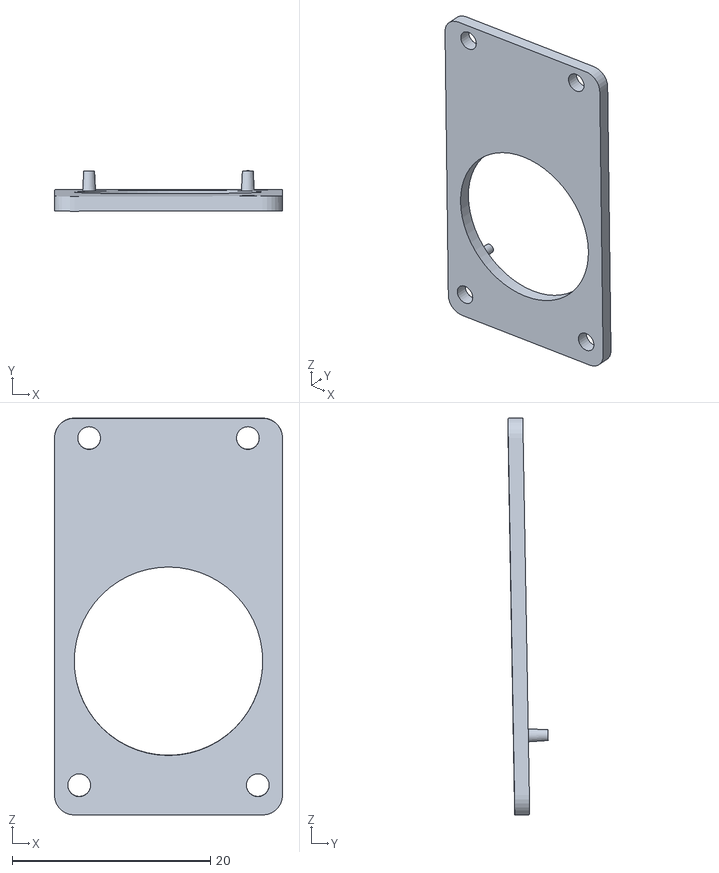
[picture p42: CAD file, 2026-09-19]
01-3DPrint/01-XL330-M288-T/大腿轴承固定件x2.stl
23.0 x 4.08 x 40.0
