AiBoBoMaker/MicroDuck-BoBoRedesign/01-3DPrint/01-XL330-M288-T/舌头x1.stl

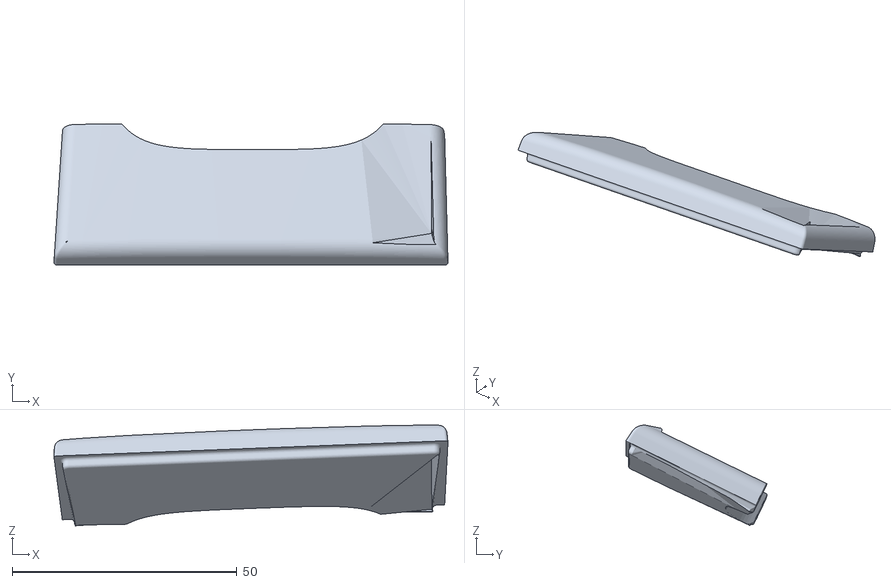
[picture p43: CAD file, 2026-09-19]
01-3DPrint/01-XL330-M288-T/舌头x1.stl
87.6 x 31.4 x 22.4
