AiBoBoMaker/MicroDuck-BoBoRedesign/01-3DPrint/01-XL330-M288-T/颈部连接件x2.stl

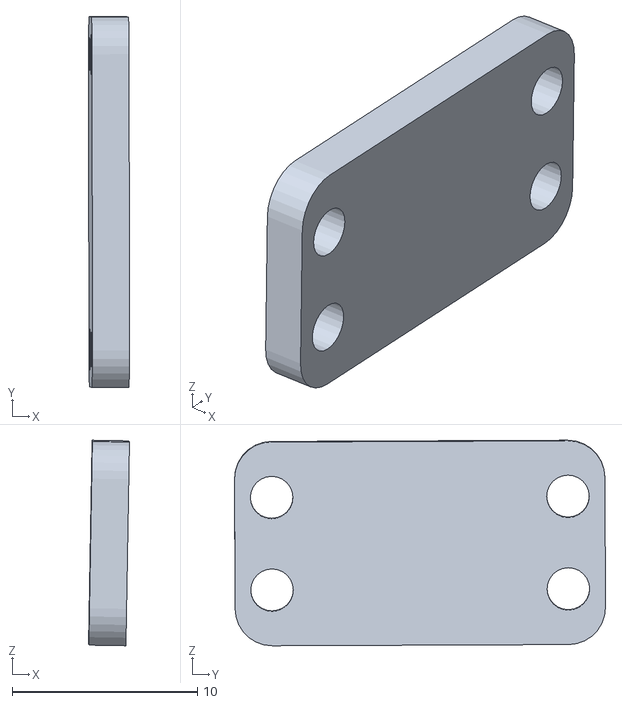
[picture p44: CAD file, 2026-09-19]
01-3DPrint/01-XL330-M288-T/颈部连接件x2.stl
2.21 x 20.0 x 11.1
