AiBoBoMaker/MicroDuck-BoBoRedesign/01-3DPrint/01-XL330-M288-T/下巴x1.stl

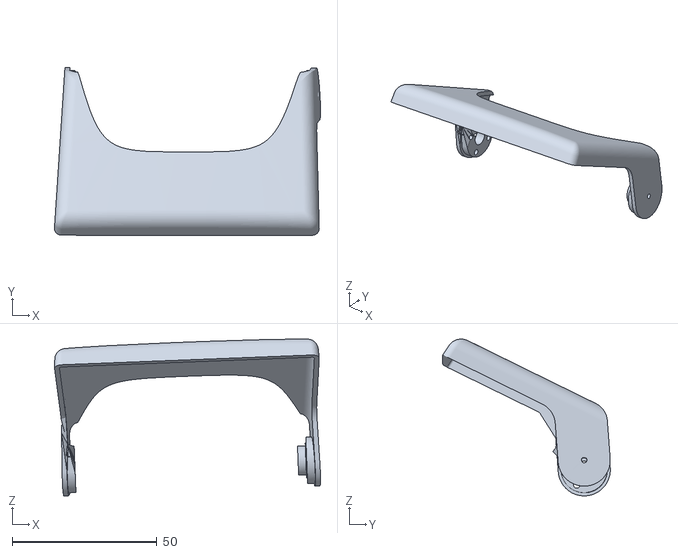
[picture p45: CAD file, 2026-09-19]
01-3DPrint/01-XL330-M288-T/下巴x1.stl
91.8 x 57.9 x 54.1
