AiBoBoMaker/MicroDuck-BoBoRedesign/01-3DPrint/01-XL330-M288-T/眼圈x1.stl

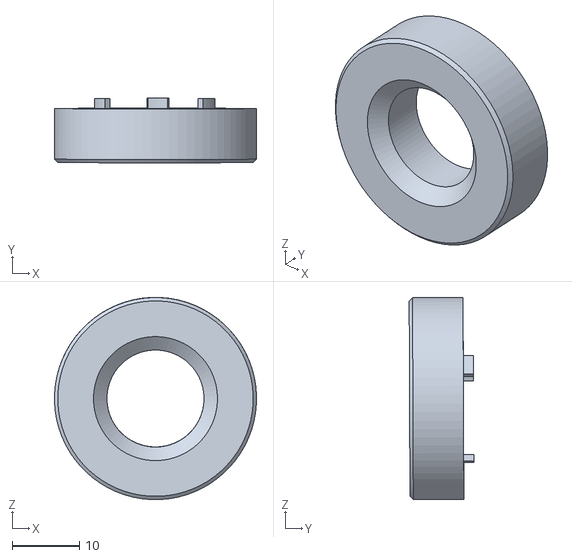
[picture p46: CAD file, 2026-09-19]
01-3DPrint/01-XL330-M288-T/眼圈x1.stl
30.0 x 9.60 x 30.0
