AiBoBoMaker/MicroDuck-BoBoRedesign/01-3DPrint/01-XL330-M288-T/右脚底板x1.stl

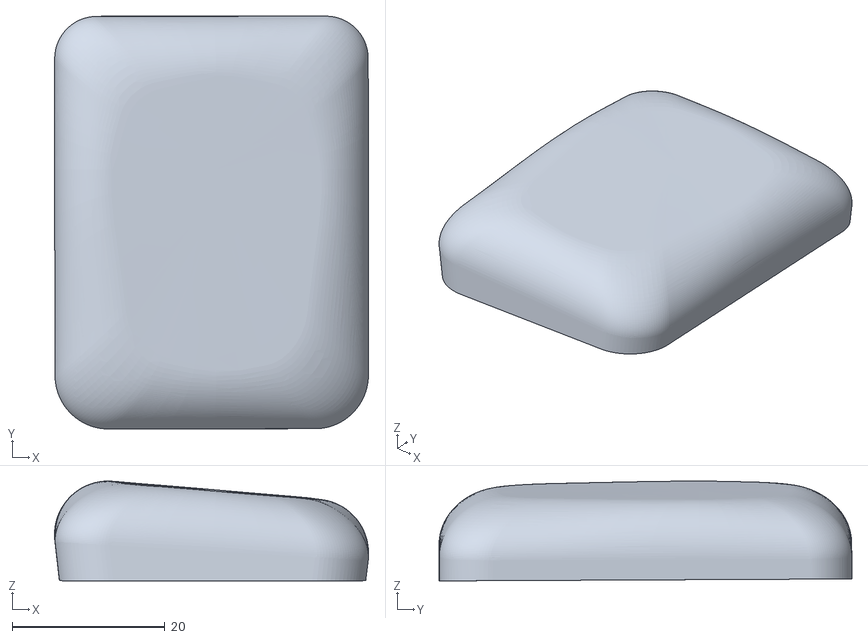
[picture p47: CAD file, 2026-09-19]
01-3DPrint/01-XL330-M288-T/右脚底板x1.stl
41.1 x 54.0 x 13.1
