AiBoBoMaker/MicroDuck-BoBoRedesign/01-3DPrint/01-XL330-M288-T/左腿外侧x1.stl

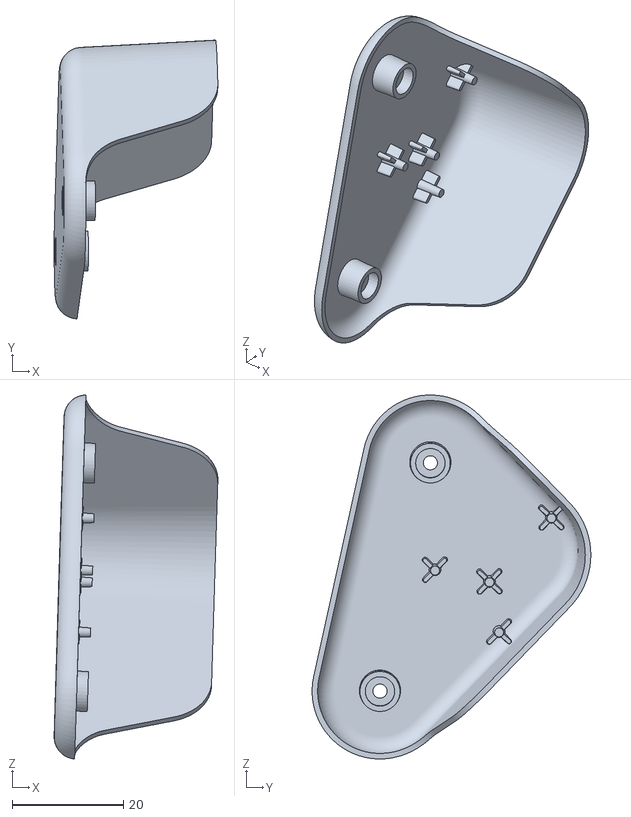
[picture p48: CAD file, 2026-09-19]
01-3DPrint/01-XL330-M288-T/左腿外侧x1.stl
29.4 x 50.1 x 65.4
