AiBoBoMaker/MicroDuck-BoBoRedesign/(list of files, cad)

Other CAD files:
01-3DPrint/02-HD-1910-C001/stl模型/黑色部分/腿-五金件.dxf
01-3DPrint/01-XL330-M288-T/右大腿_白色.stl
01-3DPrint/02-HD-1910-C001/stl模型/躯体部分/右胯外壳.stl
01-3DPrint/02-HD-1910-C001/stl模型/橙色部分/左脚.stl
01-3DPrint/02-HD-1910-C001/stl模型/支撑部分/颈部固定右.stl
01-3DPrint/02-HD-1910-C001/stl模型/橙色部分/右脚掌.stl
01-3DPrint/02-HD-1910-C001/stl模型/躯体部分/电池仓_卡扣加厚.stl
01-3DPrint/01-XL330-M288-T/头骨架.stl
01-3DPrint/02-HD-1910-C001/老版/右躯干.stl
01-3DPrint/02-HD-1910-C001/老版/头颈连接件x1.stl
01-3DPrint/01-XL330-M288-T/左脚x1.stl
01-3DPrint/01-XL330-M288-T/左躯干x1.stl
01-3DPrint/02-HD-1910-C001/stl模型/黑色部分/腿-五金件.dwg
01-3DPrint/02-HD-1910-C001/stl模型/黑色部分/腿.dxf
