AiBoBoMaker/MicroDuck-BoBoRedesign/03-DuckCode/microduck-hd1910/firmware/robotd/src/main.rs

//! `robotd` — the robot control daemon.
//!
//! The 50 Hz control loop, the `robot.*` socket, and the health the updater gates on
//! (`docs/design/robotd-design.md` §1.4, §3.4).
//!
//! **Health is why the daemon has the shape it does.** The updater's auto-rollback is only
//! meaningful if `robot.health` means something, and it used to mean "the loop ticked once" —
//! so every rollback was tested against a placeholder. It now means **the loop is meeting its
//! deadline**: a loop running at 60% of target is alive, answers every request, and is badly
//! broken.
//!
//! Holding the pose with no policy (`policy.enabled = false`) stays the right thing to be doing
//! while someone deliberately breaks releases at a bench: the bus sees the real load at the
//! real rate, and nothing falls over when a bad build lands.
//!
//! Every method must be answerable *while the robot is in a bad state*,
//! since that is exactly when it is asked. So the IPC side reads atomics the control loop
//! publishes and never calls into the loop — a wedged loop reports itself unhealthy rather
//! than hanging the caller.

mod body_imu;
mod chorale;
mod communication_stats;
mod control;
mod feetech_commissioning;
mod feetech_read_only;
mod home_start;
mod intents;
mod params;
mod process_safety;
mod raw_codec;
mod raw_stream;
mod roller;
mod selftrained_profile;
mod service_client;
mod soc;
mod sound;
mod telemetry_geometry;
mod telemetry_system;
mod theremin;

use std::path::{Path, PathBuf};
use std::process::ExitCode;
use std::sync::Arc;
use std::sync::atomic::{AtomicBool, AtomicU8, AtomicU32, AtomicU64, Ordering};
use std::time::{Duration, Instant};

use arc_swap::{ArcSwap, ArcSwapOption};
use clap::{Parser, Subcommand};
#[cfg(test)]
use duck_control::DEFAULT_POSITION;
use duck_control::fall::{FallPredictor, FallPredictorConfig};
use duck_control::io::RobotIo;
use duck_control::obs::{BodyPose, Command as PolicyCommand};
use duck_control::policy::{DEFAULT_STANDING_THRESHOLD, Policy, PolicyError, PolicyPaths};
use duck_control::safety::{Safety, SafetyConfig};
use duck_control::{FakeIo, NUM_JOINTS};
use duck_ipc_proto as proto;
use tokio::io::{AsyncBufReadExt, AsyncWriteExt, BufReader};
use tokio::net::{UnixListener, UnixStream};

use control::{Controller, Driving, SkillTuning, Tuning};
use intents::Intents;
use params::{Mode, Params, Slot};

/// What to do when the shutdown sequence completes. Injected so the tests can observe the
/// call instead of powering off the machine running them.
type PowerOff = Arc<dyn Fn() + Send + Sync>;

/// Model API version this build implements (`updater-design.md` §5.5). Bump when the
/// sensor-input / actuator-output contract a model sees changes.
// API 2 adds explicit recurrent state; API 1 feed-forward models remain supported.
const MODEL_API: u32 = 2;

/// Socket mode. Same reasoning as `updaterd`'s: the group decides who may ask.
const SOCKET_MODE: u32 = 0o660;

const MAX_LINE: usize = 64 * 1024;

/// How often the loop logs a summary at `info`.
///
/// Per-tick logging would be ~4.3M lines a day at 50 Hz. That is not merely noise: under a
/// journal size cap it is what *evicts* the logs support needs.
const LOOP_SUMMARY_INTERVAL: Duration = Duration::from_secs(300);

/// How often an *isolated* dropped bus transaction is worth a line.
///
/// One drop is ordinary on a serial bus and a run of them is a fault, so the loop logs the first
/// of a run and every tenth after it. That rule reads `consecutive_errors`, which resets on the
/// next good read — so it never fired on the case a board actually produces: one drop, one good
/// read, one drop, at about a hertz, forever `consecutive=1`. Every one of them was logged.
///
/// Which is the failure [`LOOP_SUMMARY_INTERVAL`] exists to prevent, arriving by another door: a
/// journal under a size cap, filled with the most ordinary event the robot has, evicting the
/// history somebody will need — and, since `duckctl logs` reads that journal over a radio, forty
/// lines of it saying nothing else.
///
/// So an isolated drop gets one line a minute, carrying how many it stands for. A *run* is not
/// rate-limited: that is the spasm, and it stays as loud as it was.
const BUS_DROP_QUIET: Duration = Duration::from_secs(60);

/// Bus ID of the beak. Servo 14 is the right ankle, so the voice call does not drive it.
const VOICE_MOUTH_SERVO: u8 = 34;

/// One open-and-shut while the server is speaking. Starts shut, fully open halfway
/// through, and shut again at the end of the period.
const TALK_MOUTH_PERIOD: Duration = Duration::from_millis(360);

fn voice_mouth_index() -> usize {
    duck_control::model::JOINT_IDS
        .iter()
        .position(|&id| id == VOICE_MOUTH_SERVO)
        .expect("the beak servo is one of the fifteen joints")
}

/// Opening from 0 (shut) to 1 (open) and back, for [`TALK_MOUTH_PERIOD`].
fn talk_mouth_open(now: Instant, since: Instant) -> f64 {
    let period = TALK_MOUTH_PERIOD.as_secs_f64();
    let phase = (now.saturating_duration_since(since).as_secs_f64() / period).fract();
    if phase < 0.5 { phase * 2.0 } else { (1.0 - phase) * 2.0 }
}

/// How fast the beak follows the vowel being sung, as a time constant.
///
/// A vowel is a step — `ah` opens the mouth to 0.90 and `mm` to 0.02 — and a servo asked to jump
/// between them on a 20 ms tick twitches rather than sings. This is roughly how fast a jaw moves.
const CHORALE_MOUTH_TAU_S: f64 = 0.09;

/// How far a subscriber may fall behind before it starts losing frames.
///
/// Five seconds at 50 Hz. State is advisory: a client that cannot keep up gets a gap, never
/// backpressure onto the control loop. Same rule the updater applies to progress.
const STATE_BUFFER: usize = 256;

/// Window over which the achieved rate is measured, and therefore how quickly a degraded
/// loop becomes visible to the health gate. Doubles as the slow-sensor sampling interval
/// ([`publish_slow_sensors`]).
const RATE_WINDOW: Duration = Duration::from_secs(1);

/// How long the ramp to the home pose takes when the policy is first enabled.
///
/// The same two seconds `robotd init` uses, and for the same reason: fast enough that nobody wonders
/// whether the button did anything, slow enough that a robot going from limp to standing does not
/// snap. Not a parameter yet — one number with no evidence that anyone wants a different one.
const HOME_RAMP: Duration = Duration::from_secs(2);
/// Smoothing on the reported battery voltage. At one sample per [`RATE_WINDOW`] this is a
/// ~10 s time constant, which is what makes the number readable: the raw voltage sags
/// several tenths of a volt on every step and recovers between them, so an unsmoothed
/// reading swings while the pack is doing nothing unusual. Borrowed, with the figure, from
/// `microduck_runtime`.
const BATTERY_EMA_ALPHA: f64 = 0.1;

/// How long the shutdown sit gets before torque is cut and the machine powers off, when no
/// controller is there to say. The sitstand descent is a deliberate ~2 s glide; the prototype
/// gives it four seconds, and a running controller derives the same from the set's `ramp_s`
/// (`Controller::shutdown_sit_secs`).
const SHUTDOWN_SIT: Duration = Duration::from_secs(4);

/// How many consecutive failed bus reads the policy may drive through on the last good
/// sample before it stops.
///
/// **One dropped Dynamixel transaction is ordinary** — `robotd` says so itself when it logs
/// one — and it must therefore be *invisible*. It was not: a failed read used to stop the
/// policy for that tick, which commanded the hold pose and reset the controller, so every
/// ordinary dropped read produced a visible twitch. Measured on a bench robot at ~8 drops a
/// minute with a monitor attached, which is exactly the reported "random tiny spasms".
///
/// Coasting is safe because the observation is *already* a tick old by construction: at
/// 50 Hz the policy is trained on data of exactly this age, and a second tick of it is
/// inside that. Three ticks (60 ms) covers a drop, a retry and a slow tick; past that the
/// robot genuinely cannot see, and holding still is the honest answer.
const COAST_TICKS: u32 = 3;

/// How long driving must have been interrupted before the controller is reset.
///
/// The reset zeroes the action history the policy observes and drops the low-pass anchor,
/// which is right after a real pause and is itself a discontinuity after a 20 ms hiccup —
/// the very jolt it exists to prevent.
const RESET_AFTER_PAUSE: Duration = Duration::from_millis(200);

/// Mean leg-joint deviation from the home pose above which a boot counts as seated —
/// hips and knees folded far from standing. The prototype's threshold.
const SEATED_BOOT_RAD: f64 = 0.30;

/// Where the limp-fall sequence is (`[safety] limp_fall`).
///
/// The daemon's only answer to a fall, and it runs *during* one rather than after it: the
/// trigger is [`duck_control::fall::FallPredictor`], not the `fallen` verdict, because a
/// verdict that waits for the robot to be down cannot make it soft before it lands.
///
/// The verdict is still tracked and published throughout — it just does not gate anything.
#[derive(Debug, Clone, Copy, PartialEq)]
enum LimpFall {
    Idle,
    /// Gains at `gain_limp`, joints commanded to wherever they already are — the softest
    /// thing the servos can do short of cutting torque, which would drop the head on the
    /// floor and lose the pose the next phase ramps from.
    Limp {
        since: Instant,
        landing: Landing,
    },
    /// Ramping from where the robot landed back to the standing pose, so the standing
    /// policy starts from the still, known posture it stands up from cleanly.
    Posing {
        from: [f64; NUM_JOINTS],
        since: Instant,
    },
}

/// Watching a limping robot for the moment it stops moving.
///
/// The end of the limp is read from the gyro rather than timed, because the falls are not
/// all the same length: a stumble is over in a few hundred milliseconds and a topple off a
/// table takes most of a second, and ending the limp early is landing stiff after all.
/// Debounced, because a tumbling robot passes through instants of near-zero rate on its
/// way over — one quiet sample is not a landing.
#[derive(Debug, Clone, Copy, PartialEq, Default)]
struct Landing {
    still_for: Duration,
}

impl Landing {
    /// One tick. `rate` is the gyro magnitude in rad/s, or `None` for a tick with no fresh
    /// sample — which resets rather than accumulates: a robot nobody can read is not a
    /// robot anybody has seen go still.
    fn observe(&mut self, rate: Option<f64>, period: Duration, below: f64, held: Duration) -> bool {
        self.still_for = match rate {
            Some(rate) if rate < below => self.still_for.saturating_add(period),
            _ => Duration::ZERO,
        };
        self.still_for >= held
    }
}

impl LimpFall {
    /// The interpolated pose target for this tick, or `None` once the ramp is done.
    ///
    /// The same linear shape as [`Bringup::homing_target`], and separate from it on
    /// purpose: that ramp is bring-up from limp at the policy gain over a fixed two
    /// seconds, this one is a landed robot being put back into shape, and both its
    /// duration and its gain are tunable because both depend on how the robot lands.
    fn pose_target(&self, now: Instant, over: Duration) -> Option<[f64; NUM_JOINTS]> {
        let LimpFall::Posing { from, since } = self else {
            return None;
        };
        let t = now.duration_since(*since).as_secs_f64() / over.as_secs_f64();
        if t >= 1.0 {
            return None;
        }
        let mut target = [0.0; NUM_JOINTS];
        for (i, slot) in target.iter_mut().enumerate() {
            *slot = from[i] + (duck_control::deployment::home()[i] - from[i]) * t;
        }
        Some(target)
    }
}

#[derive(Parser, Debug)]
#[command(name = "robotd", about = "Robot control daemon", version)]
struct Args {
    /// Socket to serve the `robot.*` API on. `updaterd --robot-socket` must match.
    #[arg(long, default_value = "/run/robotd.sock")]
    socket: PathBuf,

    /// Params file. Defaults to `/etc/robot/robotd.toml`, which may be absent — an
    /// unprovisioned board comes up on defaults. A path given here must exist.
    #[arg(long)]
    params: Option<PathBuf>,

    /// Serial port override, for a board wired differently from the shipped default.
    #[arg(long)]
    port: Option<String>,

    /// Run against a robot made of nothing. For laptop development and tests, and for the cases
    /// `--sim` does not cover: no physics, no falling over, positions that echo back perfectly.
    #[arg(long)]
    fake: bool,

    /// Run against a robot in MuJoCo, at `host:port`.
    ///
    /// **The same daemon, a simulated body.** Everything above `duck_control::io::RobotIo` — the
    /// loop, the policy, safety, fall detection, odometry, kinematics, every IPC call — is the code
    /// that runs on a robot, unchanged and unable to tell. `duck_control::sim` has the protocol and
    /// the reasons for its shape; `docs/design/simulation.md` has what it is and is not a twin of.
    ///
    /// Nothing is connected until the first tick, and a simulator that goes away is retried on
    /// every tick after — restarting MuJoCo must not mean restarting the duck.
    #[arg(long, conflicts_with = "fake")]
    sim: Option<String>,

    /// Do not load a policy: run the loop and hold the startup pose.
    ///
    /// Distinct from a policy that failed to load, which is unhealthy. This is the
    /// configuration to use when the thing under test is the updater rather than the gait —
    /// nothing falls over when a deliberately broken release lands.
    #[arg(long)]
    no_policy: bool,

    /// Read raw Feetech/FT5 telemetry inside robotd. Blocks ALL motor writes and intents.
    #[arg(long, conflicts_with = "fake")]
    read_only: bool,

    /// Commission HD1910 joints through this service's socket and single bus owner.
    #[arg(long, conflicts_with_all = ["fake", "read_only"])]
    commissioning: bool,

    /// Report unhealthy. For exercising the updater's rollback path on a bench robot
    /// without having to break a real build.
    #[arg(long)]
    unhealthy: bool,

    /// Report that it is not safe to restart, as if the robot were moving.
    #[arg(long)]
    busy: bool,

    #[command(subcommand)]
    command: Option<Command>,
}

#[derive(Subcommand, Debug)]
enum Command {
    /// Report the installed R17 adapter identity without opening a bus or socket.
    DeploymentInfo,
    /// Validate a deployment ONNX with the same loader, without opening a bus or socket.
    ValidatePolicy { path: PathBuf },
    /// Print the running daemon's native bus report over its socket. Does not open a UART.
    BusStatus,
    /// Position, centre and calibrate joints through the running commissioning service.
    Bus {
        #[command(subcommand)]
        command: feetech_commissioning::BusCommand,
    },
    /// Enable the configured policy through the running service; no UART is opened here.
    EnablePolicy,
    /// Disable policy motion through the running service (return to home).
    DisablePolicy,
    /// Release all joints through the running motion service.
    Relax,
    /// Enable torque and move to the home pose, then exit.
    ///
    /// Explicit, and separate from running the daemon, because the control loop must never
    /// move the robot on its own: `robotd` restarting during an update would otherwise make
    /// a standing robot lurch, which is both a fall risk and a confounder when the thing
    /// under test is the updater.
    Init {
        #[arg(long, default_value = "2s", value_parser = parse_duration)]
        duration: Duration,
    },
}

fn parse_duration(raw: &str) -> Result<Duration, String> {
    let (value, scale) = match raw.strip_suffix("ms") {
        Some(v) => (v, 1u64),
        None => match raw.strip_suffix('s') {
            Some(v) => (v, 1000),
            None => (raw, 1000),
        },
    };
    value
        .parse::<u64>()
        .map(|n| Duration::from_millis(n * scale))
        .map_err(|_| format!("expected e.g. 500ms or 2s, got {raw:?}"))
}

/// What the control loop publishes about itself.
///
/// Atomics rather than a mutex on purpose: the IPC side must never be able to block on the
/// control loop. A robot whose loop is wedged still has to be able to say "I am not
/// healthy" — if answering required the loop's lock, the one situation where `updaterd`
/// needs an answer is the situation it would hang in.
/// [`Mode`] as the byte [`RobotState::mode`] holds, and back.
///
/// Two tiny functions rather than a numeric cast, so the mapping is written down once: a mode
/// added later gets a code here and nowhere else, and an unknown byte reads as walking rather
/// than panicking on the IPC thread.
fn mode_code(mode: Mode) -> u8 {
    match mode {
        Mode::Walk => 0,
        Mode::Roller => 1,
    }
}

fn mode_of(code: u8) -> Mode {
    match code {
        roller::CROUCH_CODE | roller::SPIN_CODE => Mode::Roller,
        _ => Mode::Walk,
    }
}

/// The policy file names for one mode, as a set.
///
/// `None` in a skill slot doubles as "this robot cannot do that", which is what lets `dispatch`
/// refuse a `robot.do` for a skill this mode has no network for instead of queueing a request the
/// loop will drop — and roller mode is exactly that case: no standing network, a crouch where the
/// ground pick was.
#[derive(Debug, Clone, Default)]
struct PolicyNames {
    walk: Option<String>,
    stand: Option<String>,
    sitstand: Option<String>,
    ground_pick: Option<String>,
    /// The configurable one-shots this robot has, in priority order — the names a client may
    /// ask for, and the answer to "what can this robot do".
    skills: Vec<String>,
}

impl PolicyNames {
    /// The names for `policy`, or all-`None` when no policy is wanted.
    fn of(policy: &params::ResolvedPolicy) -> Self {
        if !policy.enabled {
            return Self::default();
        }
        let name = |path: &Option<std::path::PathBuf>| path.as_deref().and_then(file_name);
        Self {
            walk: file_name(&policy.walk),
            stand: name(&policy.stand),
            sitstand: name(&policy.sitstand),
            ground_pick: name(&policy.ground_pick),
            skills: policy.skills.iter().map(|s| s.name.clone()).collect(),
        }
    }
}

/// Why a slot is not running what was asked of it, for as long as that stays true.
///
/// A `Vec` rather than seven fields or a map: it is empty on nearly every robot, at most seven
/// long, and the linear scan is over a list shorter than the branch predictor's memory.
#[derive(Debug, Default, Clone)]
struct SlotErrors(Vec<(Slot, String)>);

impl SlotErrors {
    fn get(&self, slot: Slot) -> Option<&str> {
        self.0
            .iter()
            .find(|(s, _)| *s == slot)
            .map(|(_, reason)| reason.as_str())
    }

    fn set(&mut self, slot: Slot, reason: String) {
        self.clear(slot);
        self.0.push((slot, reason));
    }

    fn clear(&mut self, slot: Slot) {
        self.0.retain(|(s, _)| *s != slot);
    }
}

/// Where a policy file came from, for `robot.policies`.
///
/// Three origins, and the path is enough to tell them apart because the path is *made* of the
/// answer: the official set lives in its own directory, and a fetched policy lands under
/// `<library>/<org>/<name>/<revision>/`, so the org that published it is a path component. A
/// file anywhere else is one somebody put there by hand.
///
/// **Not a security boundary**, and nothing here pretends otherwise. Someone who can edit
/// `robotd.toml` can point a slot at a directory named to look official, and someone who can do
/// that can run whatever they like anyway. What stands between a bad policy and a broken robot
/// is the safety layer and the shape gate, not this label
/// (`docs/design/policy-channel-design.md` §2). This is here so a person can see what they are
/// running.
fn origin_of(path: &std::path::Path) -> &'static str {
    if path.starts_with(params::POLICY_DIR) {
        return "official";
    }
    if let Ok(rest) = path.strip_prefix(params::POLICY_LIBRARY)
        && let Some(org) = rest.components().next()
    {
        return if org.as_os_str() == OFFICIAL_ORG {
            "official"
        } else {
            "community"
        };
    }
    "local"
}

/// The org whose policies are official. One constant, matching `updater::policy::OFFICIAL_ORG`:
/// a robot that can be *told* which org to trust has a badge that means nothing.
const OFFICIAL_ORG: &str = "pollen-robotics";

/// The per-slot answer to `robot.policies`: what is loaded, from where, and why not.
///
/// Derived rather than stored, from the three things that between them decide it — what config
/// says, what that resolved to, and what failed. Storing it instead would be a fourth place for
/// the same fact, updated from three.
fn slot_report(
    policy_params: &params::PolicyParams,
    cfg: &params::ResolvedPolicy,
    errors: &SlotErrors,
) -> Vec<proto::PolicySlot> {
    Slot::ALL
        .into_iter()
        .map(|slot| {
            let path = cfg.slot(slot);
            proto::PolicySlot {
                slot: slot.as_str().to_owned(),
                path: path.map(|p| p.display().to_string()),
                origin: path.map(|p| origin_of(p).to_owned()),
                overridden: policy_params.slot(slot).is_some(),
                error: errors.get(slot).map(str::to_owned),
            }
        })
        .collect()
}

/// Drop any *overridden* slot whose file will not load, before the controller is built.
///
/// The sharp edge of `robotctl policy load` writing config: a file that loaded when it was tried
/// can be gone by the next boot — deleted, on a wiped library, on a reflashed board whose config
/// was restored. Without this the daemon reports unhealthy on every start, and `updaterd`'s
/// health gate then rolls back daemon releases for a reason no release caused: an update loop
/// over a missing file no update could have supplied.
///
/// So an override that will not load costs its slot and nothing else. The slot falls back to the
/// mode's default, the reason is recorded, and health reports **degraded** — the state for a
/// fault that belongs to the board rather than to the release being gated, where reverting the
/// daemon cannot help and only churns the boot counter.
///
/// **Only overrides.** An official path that will not load is a broken bundle and must reach the
/// health gate as unhealthy, which is exactly what rolls it back.
///
/// **And only faults that name a file.** A missing ONNX Runtime fails every path equally; taking
/// it as evidence against each override in turn would silently strip a board's whole
/// configuration because a dylib was not installed. `docs/design/policy-channel-design.md` §5.
fn drop_unloadable_overrides(policy_params: &mut params::PolicyParams, errors: &mut SlotErrors) {
    drop_unloadable_overrides_with(policy_params, errors, duck_control::policy::validate)
}

/// [`drop_unloadable_overrides`] with the check injected, so its two rules can be tested on a
/// machine that has no ONNX Runtime — which is every machine this repository's tests run on, and
/// is itself one of the cases the rules are about.
fn drop_unloadable_overrides_with(
    policy_params: &mut params::PolicyParams,
    errors: &mut SlotErrors,
    validate: impl Fn(&std::path::Path) -> Result<(), PolicyError>,
) {
    if !policy_params.enabled {
        return;
    }
    if policy_params.custom_only {
        for slot in Slot::ALL {
            let cfg = policy_params.resolved();
            let Some(path) = cfg.slot(slot) else {
                continue;
            };
            let result = if !path.with_file_name("deployment-contract.json").is_file() {
                Err(PolicyError::Inference(
                    "self-trained-only mode requires an exported deployment contract".into(),
                ))
            } else {
                validate(path)
            };
            if let Err(error) = result {
                errors.set(slot, error.to_string());
                if slot == Slot::Walk {
                    policy_params.enabled = false;
                } else {
                    policy_params.set_slot(slot, Some("none".into()));
                }
            }
        }
        return;
    }
    // A `walk = "none"` already in the file, from a `policy load walk none` this daemon used to
    // accept. `resolved` now falls back rather than panicking, so the robot walks — but it walks
    // with something the config does not name, which is exactly what this reports.
    if policy_params
        .slot(Slot::Walk)
        .as_deref()
        .is_some_and(params::is_none_sentinel)
    {
        tracing::error!("[policy] walk = \"none\" cannot be honoured; using this robot's own");
        errors.set(
            Slot::Walk,
            "the walking policy cannot be switched off; using this robot's own".to_owned(),
        );
        policy_params.set_slot(Slot::Walk, None);
    }

    for slot in Slot::ALL {
        if policy_params.slot(slot).is_none() {
            continue;
        }
        let cfg = policy_params.resolved();
        // A slot set to the literal "none" resolves to nothing, and disabling a capability on
        // purpose is not a fault to fall back from.
        let Some(path) = cfg.slot(slot) else {
            continue;
        };
        let Err(e) = validate(path) else {
            continue;
        };
        if e.path().is_none() {
            tracing::error!(error = %e, "cannot validate policies at all; leaving config alone");
            return;
        }
        tracing::error!(
            slot = slot.as_str(),
            path = %path.display(),
            error = %e,
            "override will not load; falling back to this slot's default"
        );
        errors.set(slot, e.to_string());
        policy_params.set_slot(slot, None);
    }
}

struct RobotState {
    read_only: AtomicBool,
    commissioning: AtomicBool,
    feetech: bool,
    bus_commands: feetech_commissioning::Commands,
    bus_status: ArcSwapOption<serde_json::Value>,
    bus_snapshot: ArcSwapOption<feetech_commissioning::Status>,
    bus_calibration: ArcSwapOption<serde_json::Value>,
    raw: raw_stream::Hub,
    startup: tokio::sync::watch::Sender<serde_json::Value>,
    deployment_error: ArcSwapOption<String>,
    control_exited: Arc<tokio::sync::Notify>,
    /// Session-only multiplier shared by every policy; Home/calibration remain unchanged.
    /// Epoch for every timestamp below. `Instant` so the clock cannot go backwards.
    started: Instant,
    ticks: AtomicU64,
    /// Ticks whose work overran the period. Cumulative, for diagnosis; the rate check is
    /// what catches a sustained problem.
    missed: AtomicU64,
    /// Microseconds since `started` at the last completed tick.
    last_tick_us: AtomicU64,
    /// Achieved rate over the last window, as `f64::to_bits`. Zero until the first window
    /// closes, which is why the stall check carries the first second.
    achieved_hz: AtomicU64,
    /// Consecutive failed bus reads. Reset by any success.
    consecutive_errors: AtomicU32,
    /// Failed attempts to bring the bus up — opening it, verifying its registers, or
    /// reading the startup pose. Non-zero means the loop is still waiting for a robot to
    /// answer and has never commanded anything.
    startup_bus_failures: AtomicU32,
    /// Motor-bus voltage, EMA-smoothed, as `f64::to_bits`. Zero means *not read yet* — a
    /// distinction that has to survive to the wire, since zero volts and unknown volts look
    /// nothing alike to whoever is deciding whether to charge the robot.
    battery_v: AtomicU64,
    /// Hottest servo of the last thermal sample: temperature as `f64::to_bits`, and which
    /// joint it was. Zero means *not read yet*, same as the battery.
    motor_max_c: AtomicU64,
    motor_mean_c: AtomicU64,
    /// Index into [`duck_control::JOINT_NAMES`] of the hottest joint.
    motor_hottest: AtomicU32,
    /// Hottest board thermal zone, as `f64::to_bits`. Zero means no reading — off Linux, or a
    /// kernel with no thermal sysfs ([`soc`]).
    cpu_temp_c: AtomicU64,
    /// What the board's clock is capped at, and how far the thermal governor wound it down.
    ///
    /// A swap rather than four atomics, because the four numbers are one reading: a level
    /// paired with the ceiling from a different sample would describe a board that never
    /// existed. `None` until the first sample, and forever on a board with no `cpufreq` sysfs.
    cpu_throttle: ArcSwapOption<proto::CpuThrottle>,
    /// Mirrors of the bus's own IMU diagnostics, refreshed with the thermal sample. Held here
    /// so the IPC side can report them without touching the loop's IO.
    imu_stale_blocks: AtomicU64,
    /// Stale reads in a row as of the last sample. Sampled rather than watched, which is fine
    /// for the fault it describes: a board that has stopped refreshing keeps repeating, so its
    /// run is still growing whenever the next sample lands.
    imu_stale_run: AtomicU64,
    imu_ready: AtomicBool,
    shutdown: AtomicBool,
    /// Fan-out for `robot.state`. Bounded and lossy by design — see [`STATE_BUFFER`].
    /// Each receiver shares the immutable frame before its own rate check.
    state_tx: tokio::sync::broadcast::Sender<Arc<proto::RobotState>>,
    /// What `btd` should be advertising, published when it changes.
    ///
    /// A broadcast channel like the state stream, and for the same reason: `btd` subscribes, and a
    /// `robotd` with nobody subscribed must not be blocked by that. Small buffer — a subscriber
    /// that has fallen behind on beacons wants the newest one, not a backlog of beats that have
    /// already passed.
    chorale_tx: tokio::sync::broadcast::Sender<proto::ChoraleAdvertise>,
    /// Why the policy is not loaded, if it is not. Set once at startup; the loop keeps
    /// running and holds the pose, so a broken bundle is a rollback rather than a crash.
    policy_error: ArcSwapOption<String>,
    /// Why the last policy change failed, when it named no slot to blame it on.
    ///
    /// **Not [`RobotState::policy_error`]**, and the difference is the health verdict.
    /// That one is the release's own policy failing to load, which is unhealthy and rolls the
    /// release back. This is somebody's *change* failing — a reload after a skill was added, a
    /// whole-robot reset — where the robot is still running the policy it had, so it is degraded
    /// and a rollback would fix nothing.
    ///
    /// A change to one slot is reported on that slot instead, which says more.
    policy_change_error: ArcSwapOption<String>,
    /// Which policy files this process is running, as file names. `None` when the policy is
    /// disabled.
    ///
    /// From the params rather than from the loaded network, and therefore known before the
    /// control thread has finished loading anything — a client that subscribes during startup
    /// gets the answer rather than a race. What *failed* to load is `policy_error`; this is
    /// what was asked for, and the pair is what distinguishes "no policy wanted" from "the
    /// policy this release ships would not load".
    ///
    /// **One swap for the whole set rather than seven fields**, because a mode switch replaces
    /// all of them at once: a reader that caught `walk` from roller beside `stand` from walking
    /// would be told about a robot that does not exist. Swapped by the control loop, which is
    /// the only thing that loads a policy.
    policies: ArcSwap<PolicyNames>,
    /// The per-slot report `robot.policies` serves — paths, origins, and any slot whose override
    /// could not be loaded.
    ///
    /// Beside [`Self::policies`] rather than replacing it: that one is read every time a client
    /// asks which skills exist, on a hot path, and answers with file names alone. This is the
    /// whole picture and is read when somebody asks a question about policies, which is rare.
    /// Swapped together and by the same thread, so the two cannot disagree.
    policy_slots: ArcSwap<Vec<proto::PolicySlot>>,
    /// `[policy] enabled`. A startup constant — nothing switches it at runtime — and it is here
    /// because `robot.policies` has to distinguish a robot that is deliberately holding its pose
    /// from one whose slots merely look empty.
    policy_enabled: bool,
    /// The config file this robot was started with, for the two calls that write it.
    ///
    /// Everything else here reads config once at startup and keeps what it parsed. `pad.bind` has
    /// to write, because `padd` re-reads `[pad]` from the file every second — a binding held only
    /// in memory would be reverted before anybody let go of the phone.
    config_path: PathBuf,
    /// Whether this robot can make a sound at all: audio enabled, and a bank with wavs in
    /// it. Same job as the `policy_*` fields above — false is "this robot cannot do that",
    /// which is what lets `dispatch` refuse a `robot.sound` with a reason instead of
    /// accepting it into silence. Read once at startup, like the policies: the postinstall
    /// renders the bank and restarts robotd, so a bank cannot appear under a running one.
    has_voice: bool,
    /// Whether a theremin can be picked up: the params allow one, and the depth stream is
    /// actually delivering frames. Published by the loop rather than read once at startup,
    /// because unlike a voice bank the sensor comes and goes — `tofd` restarts, the ToF
    /// drops off the I²C bus — and an accepted theremin on a duck with no depth is a
    /// feature that silently does nothing.
    theremin_ready: AtomicBool,
    /// Whether `[theremin] enabled` allows an instrument at all, and there is a voice to play
    /// it in. Read once at startup, like the policies — and kept separate from
    /// [`State::theremin_ready`] so that the refusal can name the switch. Off is the default,
    /// so "the feature is not turned on" is the answer most of these refusals want, and
    /// sending that person to look at `tofd` wastes their evening.
    theremin_allowed: bool,
    /// Whether this robot's config allows it to sing with others. Read once at startup, like the
    /// policies: `[chorale] accept`, false by default.
    chorale_accepted: bool,
    /// `walk` or `roller`, as `robot.mode` reports it.
    ///
    /// Not constant any more: `robot.setMode` switches it while the robot runs, so this is stored
    /// rather than read from the params it started as. An `AtomicU8` over [`Mode`] because it is
    /// read on the IPC side and written by the control loop, and there is nothing to allocate.
    mode: AtomicU8,
    /// Published by the loop so the IPC side can answer without consulting it.
    fallen: AtomicBool,
    /// The policy is driving and has been asked for a non-zero velocity.
    moving: AtomicBool,
    /// The HOME ramp completed and torque is on. Actual upright HOME readiness
    /// is tracked separately by `home_start`.
    ///
    /// False covers two different states on purpose — never brought up, and ramping — because a
    /// client can act on neither: the answer to both is "wait, or press Start". The journal
    /// distinguishes them.
    homed: AtomicBool,
    /// Manual LB started outside the running policy returns HOME. The existing
    /// wire name also covers recovery from limp or an interrupted HOME ramp.
    home_recovery: AtomicBool,
    home_start: ArcSwapOption<home_start::Report>,
    enable_refusal: ArcSwapOption<String>,

    /// The duck is parked in its seat, latched there by `sit_toggle`.
    ///
    /// **Published because "stand up" means two different calls.** A duck on its feet stands with
    /// `robot.init`; a duck in the seat is *held* there by a latch this daemon drives, and `init`
    /// argues with it rather than winning. What ends a sit is `robot.do sit_toggle`, and a client
    /// cannot know which of the two to send without this — the playground sent `init` at a seated
    /// duck and watched the two fight.
    ///
    /// Not `busy`: a seated duck is parked, not travelling, which is the distinction
    /// [`control::Controller::busy`] already draws.
    sitting: AtomicBool,

    period_us: u64,
    min_achieved_hz: f64,
    stall_periods: u32,
    max_consecutive_errors: u32,
    force_unhealthy: bool,
    force_busy: bool,
    /// Why `robot.voice` cannot start. Read once from `[bobo]` and `[audio]`.
    bobo_refusal: Option<String>,
    voice_toggle: tokio::sync::mpsc::Sender<()>,
    voice_toggle_rx: std::sync::Mutex<Option<tokio::sync::mpsc::Receiver<()>>>,
    /// True while a voice call holds the codec. The control loop drops its own sounds.
    voice_speaker: Arc<AtomicBool>,
    /// True while the server is playing a sentence. The beak chatters, then shuts.
    voice_talking: Arc<AtomicBool>,
}

impl RobotState {
    fn new(
        params: &Params,
        config_path: &std::path::Path,
        force_unhealthy: bool,
        force_busy: bool,
    ) -> Self {
        let (voice_toggle, voice_rx) = tokio::sync::mpsc::channel(4);
        Self {
            read_only: AtomicBool::new(false),
            commissioning: AtomicBool::new(false),
            feetech: params.bus.protocol == params::BusProtocol::Feetech,
            bus_commands: feetech_commissioning::Commands::default(),
            bus_status: ArcSwapOption::empty(),
            bus_snapshot: ArcSwapOption::empty(),
            bus_calibration: ArcSwapOption::empty(),
            raw: raw_stream::Hub::default(),
            startup: tokio::sync::watch::channel(serde_json::json!({"steps":{}})).0,
            deployment_error: ArcSwapOption::empty(),
            control_exited: Arc::new(tokio::sync::Notify::new()),
            started: Instant::now(),
            ticks: AtomicU64::new(0),
            missed: AtomicU64::new(0),
            last_tick_us: AtomicU64::new(0),
            achieved_hz: AtomicU64::new(0),
            consecutive_errors: AtomicU32::new(0),
            startup_bus_failures: AtomicU32::new(0),
            battery_v: AtomicU64::new(0),
            motor_max_c: AtomicU64::new(0),
            motor_mean_c: AtomicU64::new(0),
            motor_hottest: AtomicU32::new(0),
            cpu_temp_c: AtomicU64::new(0),
            cpu_throttle: ArcSwapOption::empty(),
            imu_stale_blocks: AtomicU64::new(0),
            imu_stale_run: AtomicU64::new(0),
            imu_ready: AtomicBool::new(false),
            shutdown: AtomicBool::new(false),
            state_tx: tokio::sync::broadcast::Sender::new(STATE_BUFFER),
            chorale_tx: tokio::sync::broadcast::Sender::new(8),
            policy_error: ArcSwapOption::empty(),
            policy_change_error: ArcSwapOption::empty(),
            policies: ArcSwap::from_pointee(PolicyNames::of(&params.policy.resolved())),
            policy_slots: ArcSwap::from_pointee(slot_report(
                &params.policy,
                &params.policy.resolved(),
                &SlotErrors::default(),
            )),
            policy_enabled: params.policy.enabled,
            config_path: config_path.to_owned(),
            has_voice: params.audio.enabled && has_any_wav(&params.audio.bank),
            theremin_ready: AtomicBool::new(false),
            theremin_allowed: params.theremin.enabled && params.audio.enabled,
            chorale_accepted: params.chorale.accept,
            mode: AtomicU8::new(mode_code(params.policy.mode)),
            fallen: AtomicBool::new(false),
            moving: AtomicBool::new(false),
            homed: AtomicBool::new(false),
            home_recovery: AtomicBool::new(false),
            home_start: ArcSwapOption::empty(),
            enable_refusal: ArcSwapOption::empty(),
            sitting: AtomicBool::new(false),
            period_us: params.period().as_micros() as u64,
            min_achieved_hz: params.update_gate.min_achieved_hz,
            stall_periods: params.update_gate.stall_periods,
            max_consecutive_errors: params.update_gate.max_consecutive_errors,
            force_unhealthy,
            force_busy,
            bobo_refusal: params.bobo.refusal(params.audio.enabled),
            voice_toggle,
            voice_toggle_rx: std::sync::Mutex::new(Some(voice_rx)),
            voice_speaker: Arc::new(AtomicBool::new(false)),
            voice_talking: Arc::new(AtomicBool::new(false)),
        }
    }

    fn health(&self) -> proto::HealthResult {
        // Everything the robot can say about itself, attached to every answer whatever the
        // verdict — and consulted by none of the checks below.
        //
        // Two separate jobs in one method, deliberately. `healthy`/`degraded` are the update
        // system's inputs and may only reflect what a *release* can be blamed for. The rest
        // is a description of the robot for whoever is looking at it, and it travels on the
        // same answer because a robot behaving oddly is asked exactly one question, once.
        let describe =
            |healthy: bool, degraded: bool, reason: Option<String>| proto::HealthResult {
                healthy,
                degraded,
                reason,
                battery: self.battery(),
                motors: self.motor_thermal(),
                cpu_temp_c: {
                    // Zero is "never read", the same sentinel the battery uses: a board at
                    // 0 °C is a sensor that is not there, not a cold robot.
                    let c = f64::from_bits(self.cpu_temp_c.load(Ordering::Relaxed));
                    (c > 0.0).then_some(c)
                },
                cpu_throttle: self.cpu_throttle.load_full().map(|t| *t),
                control_loop: Some(self.loop_health()),
                bus: proto::BusHealth {
                    consecutive_errors: self.consecutive_errors.load(Ordering::Relaxed),
                    startup_failures: self.startup_bus_failures.load(Ordering::Relaxed),
                },
                imu: Some(proto::ImuHealth {
                    ready: self.imu_ready.load(Ordering::Relaxed),
                    stale_blocks: self.imu_stale_blocks.load(Ordering::Relaxed),
                    consecutive_stale_blocks: self.imu_stale_run.load(Ordering::Relaxed),
                }),
            };

        let unhealthy = |reason: String| describe(false, false, Some(reason));
        // Not healthy, but not the release's fault either — see `HealthResult::degraded`.
        let degraded = |reason: String| describe(false, true, Some(reason));

        if self.force_unhealthy {
            return unhealthy("forced unhealthy by --unhealthy".into());
        }

        // "Starting" is not "started". The gate polls, so it will see the transition.
        if self.ticks.load(Ordering::Relaxed) == 0 {
            // Distinguish "starting" from "cannot see a robot". Both mean no ticks, but only
            // one of them is going to resolve on its own, and the update system quotes this
            // string as the reason it rolled a release back — so it has to name the cause.
            let waiting = self.startup_bus_failures.load(Ordering::Relaxed);
            if waiting > 0 {
                if let Some(status) = self.bus_status.load_full()
                    && let Some(error) = status.get("error").and_then(serde_json::Value::as_str)
                {
                    return degraded(format!("motor bus startup: {error}"));
                }
                // Degraded, not unhealthy: an unpowered bench board must not roll back every
                // release shipped to it. The bus not answering is the same before and after.
                return degraded(format!(
                    "no robot on the motor bus after {waiting} attempts; \
                     is servo power on and the bus wired?"
                ));
            }
            return unhealthy("control loop has not completed a cycle yet".into());
        }

        // A daemon that came up but cannot run its policy is not healthy, however well the
        // loop is ticking. This is what makes the updater roll back a release whose bundle
        // is wrong, instead of leaving a robot that holds a pose and never walks again.
        if let Some(reason) = self.policy_error.load_full() {
            return unhealthy(format!("policy unavailable: {reason}"));
        }

        // A slot running its default because an override would not load. Degraded rather than
        // unhealthy, and the distinction is load-bearing: this is a property of the *board* —
        // somebody's file is missing — so reverting the daemon cannot fix it, and gating on it
        // would make every subsequent release fail its health check over a stale config line.
        // The robot walks; it walks with the policy it shipped with, and says so.
        let fell_back = self.policy_slots.load();
        let mut fell_back = fell_back
            .iter()
            .filter_map(|slot| slot.error.as_ref().map(|e| format!("{}: {e}", slot.slot)))
            .peekable();
        if fell_back.peek().is_some() {
            return degraded(format!(
                "using the default policy where an override would not load — {}",
                fell_back.collect::<Vec<_>>().join("; ")
            ));
        }

        // A reload or a reset that would not build. Same verdict and the same reasoning as the
        // slots above: the robot kept the policy it had, so it walks, and no release the update
        // gate could revert to would change the outcome.
        if let Some(reason) = self.policy_change_error.load_full() {
            return degraded(format!("the last policy change did not take — {reason}"));
        }

        let errors = self.consecutive_errors.load(Ordering::Relaxed);
        if errors >= self.max_consecutive_errors {
            return unhealthy(format!("{errors} consecutive bus read failures"));
        }

        // A wedged loop stops stamping. This is what turns a hung control thread into an
        // honest answer instead of a socket that keeps saying "healthy" forever.
        let now_us = self.started.elapsed().as_micros() as u64;
        let stale_us = now_us.saturating_sub(self.last_tick_us.load(Ordering::Relaxed));
        let stall_limit_us = self.period_us.saturating_mul(self.stall_periods as u64);
        if stale_us > stall_limit_us {
            return unhealthy(format!("control loop stalled for {} ms", stale_us / 1000));
        }

        let hz = f64::from_bits(self.achieved_hz.load(Ordering::Relaxed));
        if hz > 0.0 && hz < self.min_achieved_hz {
            return unhealthy(format!(
                "control loop at {hz:.1} Hz, below the {:.1} Hz floor",
                self.min_achieved_hz
            ));
        }

        describe(true, false, None)
    }

    /// The loop's own numbers, as the readout reports them.
    fn loop_health(&self) -> proto::LoopHealth {
        let hz = f64::from_bits(self.achieved_hz.load(Ordering::Relaxed));
        let now_us = self.started.elapsed().as_micros() as u64;
        proto::LoopHealth {
            target_hz: 1_000_000.0 / self.period_us as f64,
            // Zero is the "no window has closed yet" sentinel, not a measured rate.
            achieved_hz: (hz > 0.0).then_some(hz),
            ticks: self.ticks.load(Ordering::Relaxed),
            missed: self.missed.load(Ordering::Relaxed),
            last_tick_age_ms: now_us.saturating_sub(self.last_tick_us.load(Ordering::Relaxed))
                / 1000,
        }
    }

    /// The hottest servo of the last thermal sample, or `None` before the first one.
    fn motor_thermal(&self) -> Option<proto::MotorThermal> {
        let max_c = f64::from_bits(self.motor_max_c.load(Ordering::Relaxed));
        if max_c <= 0.0 {
            return None;
        }
        let hottest = self.motor_hottest.load(Ordering::Relaxed) as usize;
        Some(proto::MotorThermal {
            hottest: duck_control::JOINT_NAMES
                .get(hottest)
                .unwrap_or(&"unknown")
                .to_string(),
            max_c,
            mean_c: f64::from_bits(self.motor_mean_c.load(Ordering::Relaxed)),
        })
    }

    /// The last battery reading, mapped to a percentage — or `None` if there has not been
    /// one.
    ///
    /// Zero is the "never read" sentinel rather than a measurement: the atomic starts there,
    /// and a robot whose bus cannot answer never leaves it. Reporting that as `0.00 V, 0%`
    /// would put a flat-battery warning in front of anyone whose robot has been up for less
    /// than a second.
    fn battery(&self) -> Option<proto::Battery> {
        let volts = f64::from_bits(self.battery_v.load(Ordering::Relaxed));
        (volts > 0.0).then(|| proto::Battery {
            volts,
            percent: duck_control::battery_percent(volts),
        })
    }

    fn safe_to_restart(&self) -> proto::SafeToRestartResult {
        if self.force_busy {
            return proto::SafeToRestartResult {
                safe: false,
                reason: Some("forced busy by --busy".into()),
            };
        }
        // Restarting motor control mid-stride is how a robot falls over
        // (`updater-design.md` §7.2). A robot that is merely standing, or already down, is
        // safe to interrupt — it is going nowhere either way.
        if self.moving.load(Ordering::Relaxed) {
            return proto::SafeToRestartResult {
                safe: false,
                reason: Some("the robot is walking".into()),
            };
        }
        proto::SafeToRestartResult {
            safe: true,
            reason: None,
        }
    }
}

#[tokio::main]
async fn main() -> ExitCode {
    // A disconnected optional client/player must never terminate motor control.
    if let Err(error) = process_safety::ignore_sigpipe() {
        eprintln!("cannot isolate broken pipes: {error}");
        return ExitCode::FAILURE;
    }

    let args = Args::parse();
    if matches!(args.command, Some(Command::DeploymentInfo)) {
        println!(
            "{}",
            serde_json::json!({"build":feetech_commissioning::BUILD,
            "official_version":env!("CARGO_PKG_VERSION"),"model_api":2})
        );
        return ExitCode::SUCCESS;
    }
    if let Some(Command::ValidatePolicy { path }) = &args.command {
        return match duck_control::policy::validate_and_warm(path) {
            Ok(()) => {
                println!(
                    "{}",
                    serde_json::json!({"valid":true,"input":"obs","observations":61,"actions":14})
                );
                ExitCode::SUCCESS
            }
            Err(error) => {
                eprintln!("{error}");
                ExitCode::FAILURE
            }
        };
    }

    tracing_subscriber::fmt()
        .with_env_filter(
            tracing_subscriber::EnvFilter::try_from_default_env()
                .unwrap_or_else(|_| tracing_subscriber::EnvFilter::new("info")),
        )
        .with_writer(std::io::stderr)
        .init();

    // Client commands must not replace the running daemon's public identity.
    // The owning daemon/init publishes it only after acquiring its lock below.
    if matches!(args.command, Some(Command::BusStatus)) {
        return feetech_read_only::show(&args.socket).await;
    }
    match args.command.as_ref() {
        Some(Command::Bus { command }) => {
            return feetech_commissioning::cli(&args.socket, command).await;
        }
        Some(Command::EnablePolicy) => {
            return service_client::call(
                &args.socket,
                "robot.enable",
                serde_json::json!({"on":true}),
            )
            .await;
        }
        Some(Command::DisablePolicy) => {
            return service_client::call(
                &args.socket,
                "robot.enable",
                serde_json::json!({"on":false}),
            )
            .await;
        }
        Some(Command::Relax) => {
            return service_client::call(&args.socket, "robot.relax", serde_json::json!({})).await;
        }
        _ => {}
    }

    let explicit = args.params.is_some();
    let params_path = args
        .params
        .clone()
        .unwrap_or_else(|| PathBuf::from(params::DEFAULT_PATH));

    tracing::info!(step=1, status="starting", path=%params_path.display(), "startup: read main configuration");
    let mut params = match Params::load(&params_path, explicit) {
        Ok(params) => params,
        Err(e) => {
            tracing::error!(step=1, status="failed", error = %e, "startup: bad main configuration");
            return ExitCode::FAILURE;
        }
    };
    if let Some(port) = args.port.clone() {
        params.bus.port = port;
    }
    if args.no_policy || args.read_only || args.commissioning {
        params.policy.enabled = false;
    }
    if args.read_only || args.commissioning {
        if args.command.is_some() || params.bus.protocol != params::BusProtocol::Feetech {
            tracing::error!(
                "--read-only/--commissioning requires bus.protocol=feetech and no subcommand"
            );
            return ExitCode::FAILURE;
        }
        params.policy.enabled = false;
        params.audio.enabled = false;
    }

    if let Some(Command::Init { duration }) = args.command {
        // init opens the motor bus itself. Keep ownership until the whole ramp returns,
        // so neither a daemon nor another init can join it partway through.
        let _instance_lock = match claim_lock(&args.socket) {
            Ok(lock) => lock,
            Err(e) => {
                tracing::error!(path = %args.socket.display(), error = %e, "cannot claim robot IPC socket");
                return ExitCode::FAILURE;
            }
        };
        duck_ipc_proto::log_startup_identity!("robotd");
        if params.bus.protocol == params::BusProtocol::Feetech {
            return service_client::call(&args.socket, "robot.init", serde_json::json!({})).await;
        }
        return run_init(&params, duration);
    }

    // Own the endpoint before publishing an identity or starting a thread that can touch
    // the motors. Keep the lock through control-thread shutdown and socket cleanup.
    let (_instance_lock, listener) = match claim_socket(&args.socket).await {
        Ok(owned) => owned,
        Err(e) => {
            tracing::error!(path = %args.socket.display(), error = %e, "cannot claim robot IPC socket");
            return ExitCode::FAILURE;
        }
    };
    duck_ipc_proto::log_startup_identity!("robotd");

    let state = Arc::new(RobotState::new(
        &params,
        &params_path,
        args.unhealthy,
        args.busy,
    ));
    state
        .read_only
        .store(args.read_only || args.commissioning, Ordering::Relaxed);
    state
        .commissioning
        .store(args.commissioning, Ordering::Relaxed);

    if args.unhealthy {
        tracing::warn!("--unhealthy: will report unhealthy, so updates will roll back");
    }
    if args.busy {
        tracing::warn!("--busy: will refuse restarts, so updates will be held off");
    }

    let intents = Arc::new(Intents::new());
    if state.bobo_refusal.is_none() {
        let rx = state
            .voice_toggle_rx
            .lock()
            .ok()
            .and_then(|mut slot| slot.take());
        if let Some(rx) = rx {
            let speaker = Arc::clone(&state.voice_speaker);
            let talking = Arc::clone(&state.voice_talking);
            let cfg = bobo::SessionConfig {
                enabled: params.bobo.enabled,
                url: params.bobo.url.clone(),
                token: params.bobo.token.clone(),
                client_id_path: params.bobo.client_id_path.display().to_string(),
                capture_device: params.audio.capture_device(),
                playback_device: params.audio.device.clone(),
            };
            tokio::spawn(async move {
                bobo::run(rx, speaker, talking, cfg).await;
            });
            tracing::warn!(url = %params.bobo.url, "语音对话待命：右摇杆按下或菜单键接通");
        }
    }

    // The real thing. `setsid` detaches the command from this process's cgroup, so the
    // poweroff proceeds while systemd is busy killing robotd itself.
    let poweroff: PowerOff = Arc::new(|| {
        let result = std::process::Command::new("setsid")
            .args(["sh", "-c", "systemctl poweroff"])
            .spawn();
        if let Err(e) = result {
            tracing::error!(error = %e, "cannot power off");
        }
    });

    let control = match spawn_control_thread(
        &args,
        &params,
        Arc::clone(&state),
        Arc::clone(&intents),
        poweroff,
    ) {
        Ok(handle) => handle,
        Err(e) => {
            tracing::error!(error = %e, "cannot start the control loop");
            return ExitCode::FAILURE;
        }
    };

    state.startup_step(1, "success", "配置读取、实例锁、IPC socket、控制线程已启动");
    let serving = serve(
        Arc::clone(&state),
        Arc::clone(&intents),
        listener,
        args.socket.clone(),
    );
    let mut code = ExitCode::SUCCESS;
    tokio::select! {
        result = serving => {
            if let Err(e) = result {
                tracing::error!(error = %e, "IPC server stopped");
                code = ExitCode::FAILURE;
            }
        }
        signal = shutdown() => tracing::warn!(signal, "service shutdown requested"),
        _ = state.control_exited.notified() => {
            state.startup_step(1, "failed", "控制线程意外结束；主服务退出并交由 systemd 恢复，具体原因见前一条日志");
            code = ExitCode::FAILURE;
        }
    }

    // Ask the loop to stop and let it finish the tick it is in, rather than aborting
    // mid-transaction and leaving a half-written packet on the bus.
    state.shutdown.store(true, Ordering::Relaxed);
    let _ = control.join();
    let _ = std::fs::remove_file(&args.socket);
    code
}

/// Enable torque and ramp to the home pose.
#[cfg(target_os = "linux")]
fn run_init(params: &Params, duration: Duration) -> ExitCode {
    // The same open as the daemon's, replacement adoption included: `init` is what someone
    // reaches for right after a motor swap, and it must not be the one path that refuses the
    // new servo.
    if params.bus.protocol == params::BusProtocol::Feetech {
        return ExitCode::FAILURE;
    }
    let Some(BusIo::Dynamixel(mut io)) = open_bus(&params.bus, 0, None) else {
        return ExitCode::FAILURE;
    };
    if let Err(e) = io.set_torque(true) {
        tracing::error!(error = %e, "cannot enable torque");
        return ExitCode::FAILURE;
    }
    // Before the ramp, not after: position_p_gain is a RAM register that survives this
    // process, so whatever was written last is what the robot stands up with. A previous fall
    // leaves `gain_limp` (50) there, and `init` would then take the robot to its home pose at
    // a third of the intended stiffness — soft enough to be a fall risk in the one command
    // whose whole job is establishing a known state.
    //
    // `robotd`'s control loop sets its own gain on the first tick, so this only governs the
    // ramp and the window before the daemon starts — which is exactly the window where the
    // robot is standing up unsupported.
    if let Err(e) = io.set_gain(params.policy.gain) {
        tracing::error!(error = %e, gain = params.policy.gain, "cannot set the position gain");
        return ExitCode::FAILURE;
    }
    if let Err(e) = io.interpolate_to(
        &duck_control::deployment::home(),
        duration,
        Duration::from_millis(20),
    ) {
        tracing::error!(error = %e, "interpolation to the home pose failed");
        return ExitCode::FAILURE;
    }
    tracing::warn!(?duration, "at home pose, torque enabled");
    ExitCode::SUCCESS
}

#[cfg(not(target_os = "linux"))]
fn run_init(_params: &Params, _duration: Duration) -> ExitCode {
    tracing::error!("init needs a real bus; this build is not on the robot");
    ExitCode::FAILURE
}

/// Start the control loop on its own OS thread, with its own current-thread runtime.
///
/// Its own thread because the bus read is *blocking* serial I/O — on a shared runtime it
/// would occupy a worker for the duration of every transaction. Its own runtime so IPC work
/// can never be scheduled in front of a tick. This mirrors the prototype, where the loop
/// likewise had a runtime to itself and everything else lived on threads.
fn spawn_control_thread(
    args: &Args,
    params: &Params,
    state: Arc<RobotState>,
    intents: Arc<Intents>,
    poweroff: PowerOff,
) -> std::io::Result<std::thread::JoinHandle<()>> {
    let period = params.period();
    let fake = args.fake;
    let sim = args.sim.clone();
    let bus = params.bus.clone();
    let read_only = args.read_only;
    let commissioning = args.commissioning;
    let params = params.clone();
    // So a reload can re-read `[policy]` without a restart. The path rather than the loaded
    // params, because the point is to pick up what has been written since.
    let params_path = args
        .params
        .clone()
        .unwrap_or_else(|| PathBuf::from(params::DEFAULT_PATH));

    if !fake && sim.is_none() && !read_only && bus.protocol == params::BusProtocol::Feetech {
        state.bus_status.store(Some(Arc::new(serde_json::json!({
            "build":feetech_commissioning::BUILD,
            "mode":if commissioning { "commissioning" } else { "motion" },
            "phase":"configuring_bus","port":bus.port
        }))));
    }

    std::thread::Builder::new()
        .name("control".into())
        .spawn(move || {
            let _exit = ControlThreadExit(Arc::clone(&state.control_exited));
            let runtime = match tokio::runtime::Builder::new_current_thread()
                .enable_time()
                .build()
            {
                Ok(runtime) => runtime,
                Err(e) => {
                    tracing::error!(error = %e, "cannot build the control runtime");
                    return;
                }
            };

            if commissioning {
                let calibration_path =
                    params
                        .bus
                        .feetech_calibration
                        .as_deref()
                        .unwrap_or_else(|| {
                            std::path::Path::new("/etc/robot/feetech-ft5/hd1910-calibration.toml")
                        });
                runtime.block_on(feetech_commissioning::run(
                    &params.bus.port,
                    &state,
                    period,
                    calibration_path,
                    body_imu::Request::from_bus(&params.bus),
                ));
                return;
            }
            if read_only {
                runtime.block_on(feetech_read_only::run(
                    &params.bus.port,
                    &state,
                    period,
                    body_imu::Request::from_bus(&params.bus),
                ));
                return;
            }
            if fake {
                tracing::warn!("--fake: no bus, no robot");
                runtime.block_on(control_loop(
                    FakeIo::at(duck_control::deployment::home()),
                    state,
                    intents,
                    params,
                    params_path,
                    period,
                    poweroff,
                ));
                return;
            }

            // No `open_bus_waiting` equivalent, deliberately: `RemoteIo` connects lazily and
            // reconnects on every tick, so a duck started before its simulator simply reports
            // unhealthy until the simulator answers — which is what a robot with no power on the
            // bus does too, by a different route.
            if let Some(addr) = sim {
                tracing::warn!(%addr, "--sim: the body is in MuJoCo");
                runtime.block_on(control_loop(
                    duck_control::sim::RemoteIo::at(addr),
                    state,
                    intents,
                    params,
                    params_path,
                    period,
                    poweroff,
                ));
                return;
            }

            // Waiting, not one shot. `open_bus` verifies motor registers, which means it
            // talks to the servos — so on an unpowered board it fails and this used to fall
            // straight off the end of the thread. No control loop was ever created, and
            // because nothing had been *attempted* the health reason was the bland "control
            // loop has not completed a cycle yet", forever, whatever happened to the robot
            // afterwards. Retrying the read alone was not enough: execution never got there.
            runtime.block_on(async move {
                if let Some(io) = open_bus_waiting(&bus, &state).await {
                    control_loop(io, state, intents, params, params_path, period, poweroff).await;
                }
            });
        })
}

struct ControlThreadExit(Arc<tokio::sync::Notify>);
impl Drop for ControlThreadExit {
    fn drop(&mut self) { self.0.notify_one(); }
}

impl RobotState {
    fn startup_step(&self, step: u8, status: &str, detail: &str) {
        let row = serde_json::json!({"status":status,"detail":detail});
        let key = step.to_string();
        let changed = self.startup.send_if_modified(|report| {
            if report["steps"][&key] == row { return false; }
            report["steps"][&key] = row;
            report["build"] = serde_json::json!(feetech_commissioning::BUILD);
            true
        });
        if changed { tracing::info!(step, status, detail, "startup status"); }
    }
}

/// The real bus on the board; a fake elsewhere, so `open_bus_waiting` has one signature.
#[cfg(target_os = "linux")]
type BusIo = duck_control::hardware::HardwareIo;
#[cfg(not(target_os = "linux"))]
type BusIo = FakeIo;

/// Open and verify the bus, waiting for a robot to answer.
///
/// Same reasoning as [`adopt_startup_pose`], one step earlier: an unpowered board cannot
/// pass `check_registers`, and that is a condition someone fixes by flipping a switch, not
/// one to abandon the control loop over.
///
/// Returns `None` only if shutdown is requested while waiting.
async fn open_bus_waiting(bus: &params::Bus, state: &RobotState) -> Option<BusIo> {
    let mut attempt = 0u32;
    state.startup_step(2, "starting", "读取保存标定、打开串口、关闭并确认扭矩、初始化 IMU");
    while !state.shutdown.load(Ordering::Relaxed) {
        if let Some(io) = open_bus(bus, attempt, Some(state)) {
            state.startup_bus_failures.store(0, Ordering::Relaxed);
            return Some(io);
        }
        attempt += 1;
        state.startup_bus_failures.store(attempt, Ordering::Relaxed);
        if !cfg!(target_os = "linux") { return None; }
        // The existing official startup wait owns this retry, with no helper,
        // acknowledgement, configuration copy, cold-reopen pass or extra timer.
        tokio::time::sleep(STARTUP_RETRY_INTERVAL).await;
    }
    None
}

/// Open and verify the bus, or explain why not.
#[cfg(target_os = "linux")]
fn open_bus(bus: &params::Bus, attempt: u32, state: Option<&RobotState>) -> Option<BusIo> {
    // First attempt and every thirtieth — about one line per 30 s while waiting.
    let loud = attempt == 0 || attempt.is_multiple_of(STARTUP_READ_LOG_EVERY);
    let port = bus.port.as_str();

    if bus.protocol == params::BusProtocol::Feetech {
        let open = || -> Result<_, Box<dyn std::error::Error>> {
            let path = bus.feetech_calibration.as_ref().ok_or(
                "Feetech motion requires a calibration file; start --commissioning to capture it through robotd"
            )?;
            let calibration: duck_control::feetech::Calibration =
                toml::from_str(&std::fs::read_to_string(path)?)?;
            calibration.validate_motion()?;
            let report = feetech_commissioning::calibration_status(&calibration, path);
            let request = body_imu::Request::from_bus(bus);
            let mount = calibration.imu_mount_quat;
            let mut opened = body_imu::open(&request)?;
            let raw = duck_control::feetech::Bus::open(port)?;
            let mut io = duck_control::feetech::FeetechIo::for_startup(raw, calibration)?;
            if let Some(chip) = opened.chip.take() {
                io.attach_lsm6(chip);
            }
            io.set_imu_transport(opened.wire.as_str());
            io.set_imu_mount(body_imu::mount_quat(opened.wire, request.native_mount, mount));
            if let Err(error) = io.confirm_startup_limp() {
                return Err(body_imu::annotate(&opened, error.to_string()).into());
            }
            body_imu::log_locked(request.mode, &opened);
            if let Some(state) = state {
                state.bus_calibration.store(Some(Arc::new(report)));
            }
            Ok(io)
        };
        return match open() {
            Ok(io) => {
                tracing::warn!(
                    "native Feetech selected; startup torque OFF confirmed; init/enable remains explicit"
                );
                Some(BusIo::Feetech(io))
            }
            Err(e) => {
                if let Some(state) = state {
                    state.startup_step(2, "waiting", &format!("{port} @ {baud} baud: {e}", baud = duck_control::feetech::BAUD));
                    state.bus_status.store(Some(Arc::new(serde_json::json!({
                        "build":feetech_commissioning::BUILD,"mode":"motion",
                        "phase":"waiting_for_bus","port":port,"error":e.to_string()
                    }))));
                }
                if loud { tracing::warn!(error = %e, port, attempt, "hardware initialization waiting"); }
                None
            }
        };
    }

    let mut io = match duck_control::bus::DynamixelIo::open(port, bus.fast_sync_read) {
        Ok(io) => io,
        Err(e) => {
            if loud {
                tracing::error!(error = %e, port, attempt, "cannot open the bus; waiting");
            }
            return None;
        }
    };
    // Under the same `loud` rule as everything else here — a board waiting on servo power
    // retries this forever. Worth saying at all because the whole tick budget hangs off it,
    // and "turned off in robotd.toml" is otherwise indistinguishable from "this board is slow".
    if !bus.fast_sync_read && loud {
        tracing::warn!("bus.fast_sync_read is off; every sync read is a plain one");
    }
    if !adopt_missing_servo(&mut io, loud) {
        return None;
    }
    match io.check_registers() {
        Ok(0) => tracing::info!("motor registers already correct"),
        Ok(n) => tracing::warn!(corrected = n, "motor registers corrected"),
        Err(e) => {
            if loud {
                tracing::error!(
                    error = %e,
                    attempt,
                    "motor register check failed; waiting, is servo power on?"
                );
            }
            return None;
        }
    }
    Some(BusIo::Dynamixel(io))
}

/// The motor-swap path: if exactly one expected servo is silent and a factory-fresh one
/// answers instead, flash the new one as the missing joint.
///
/// A ping census of the fifteen expected IDs is all a complete bus pays for this. The
/// factory-defaults probe — which reopens the port at 57 600 baud — only runs once a single
/// servo is known to be missing, so an ordinary boot never scans for anything.
///
/// Returns whether the bus is worth checking further. `false` is "keep waiting": every servo
/// unpowered, a servo missing with nothing fresh to replace it, or two missing at once, which
/// cannot be told apart and is left to a human.
#[cfg(target_os = "linux")]
fn adopt_missing_servo(io: &mut duck_control::bus::DynamixelIo, loud: bool) -> bool {
    use duck_control::bus::replacement_target;

    let missing = match io.missing_servos() {
        Ok(missing) => missing,
        Err(e) => {
            if loud {
                tracing::error!(error = %e, "cannot ping the servos; waiting, is servo power on?");
            }
            return false;
        }
    };
    if missing.is_empty() {
        return true;
    }
    if missing.len() == duck_control::NUM_JOINTS {
        // Not a swap, just no power yet; `check_registers` below says so in the words people
        // already know.
        return true;
    }
    let Some(id) = replacement_target(&missing) else {
        if loud {
            tracing::error!(
                ?missing,
                "several servos are missing; a replacement can only be adopted one at a time, waiting"
            );
        }
        return false;
    };
    match io.adopt_replacement(id) {
        Ok(true) => true,
        Ok(false) => {
            if loud {
                tracing::error!(
                    id,
                    "servo missing and nothing answers at factory defaults (id 1, 57600 baud); \
                     is it plugged in? waiting"
                );
            }
            false
        }
        Err(e) => {
            if loud {
                tracing::error!(error = %e, id, "adopting the replacement servo failed; waiting");
            }
            false
        }
    }
}

#[cfg(not(target_os = "linux"))]
fn open_bus(_bus: &params::Bus, _attempt: u32, _state: Option<&RobotState>) -> Option<BusIo> {
    tracing::error!("no bus on this platform; use --fake");
    None
}

/// Backoff after a failed startup read or incomplete joint feedback.
///
/// A second, not a control period: the read itself already carries a 30 ms bus timeout, and
/// a board waiting for someone to switch servo power on is not in a hurry. Fast enough that
/// powering the robot brings it up while your hand is still on the switch.
const STARTUP_RETRY_INTERVAL: Duration = Duration::from_secs(1);

/// Log one waiting line, then one every this many attempts — about one per 30 s.
const STARTUP_READ_LOG_EVERY: u32 = 30;

/// Adopt the pose the robot is already in, waiting for the bus to answer.
///
/// Never move on start: the servos hold their last commanded goal while this process is
/// dead, so a restart mid-update leaves a standing robot standing, with no gap. That
/// requires a successful read, so there is nothing to command until one lands.
///
/// This used to be a single read that logged and returned on failure — which killed the
/// control thread for the life of the process. `robotd` stayed up and kept answering the
/// socket, so a board booted before its servos were powered was permanently inert: powering
/// them changed nothing and only `systemctl restart robotd` helped, with no hint anywhere
/// that a restart was what was needed. Retrying makes the ordinary order of operations —
/// power the board, then power the servos — just work.
///
/// Read through `Safety` rather than the bus directly: safety owns the only `RobotIo`, so
/// this is the only way to reach it, and going through it keeps that invariant intact even
/// for the one read that happens before the loop starts.
///
/// Returns `None` only if shutdown is requested while waiting.
/// How far the robot has got towards being drivable.
///
/// This is what made pressing Start on a fresh robot do nothing visible: the policy ran, the loop
/// wrote positions, and the servos ignored them because they had no torque. Torque came from
/// `robotd init` — a separate subcommand that opens the motor bus itself, so it needs the daemon
/// stopped, and which appeared in no documentation.
///
/// The invariant the old design protected is narrower than "never touch torque", and it survives
/// intact: **nothing here runs because a process started.** A `robotd` restarted by an update finds
/// `Limp`, writes nothing new, and leaves a standing robot standing. Only an explicit
/// `robot.enable` moves it on, which is a human pressing Start.
#[derive(Debug, Clone, Copy, PartialEq)]
enum Bringup {
    /// No torque asked for yet. The loop still reads, publishes and holds — it just cannot make the
    /// robot do anything, which is the correct state for a robot nobody has asked to move.
    Limp,
    /// Torque is on and the joints are ramping to the home pose. The policy does not drive yet: it
    /// would be stepping from wherever the robot was slumped, which is exactly the lurch the ramp
    /// exists to avoid.
    Homing {
        from: [f64; NUM_JOINTS],
        since: Instant,
    },
    /// At the home pose with torque on. The policy drives when enabled.
    Ready,
}

impl Bringup {
    /// The interpolated target for this tick, or `None` once the ramp is done.
    ///
    /// Linear, like `DynamixelIo::interpolate_to` which `robotd init` uses — same shape, except this
    /// one is computed per tick instead of blocking the thread, because here the loop is running.
    fn homing_target(&self, now: Instant) -> Option<[f64; NUM_JOINTS]> {
        let Bringup::Homing { from, since } = self else {
            return None;
        };
        let t = now.duration_since(*since).as_secs_f64() / HOME_RAMP.as_secs_f64();
        if t >= 1.0 {
            return None;
        }
        let mut target = [0.0; NUM_JOINTS];
        for (i, slot) in target.iter_mut().enumerate() {
            *slot = from[i] + (duck_control::deployment::home()[i] - from[i]) * t;
        }
        Some(target)
    }
}

/// One low-pass step toward `target`.
///
/// A non-finite target is dropped, not folded in: `ema += α·(inf − ema)` is `inf` on this
/// tick and on every tick after, because nothing finite can climb back out of it. The wire
/// can produce one — JSON parses `1e400` as infinity — and the safety layer below refuses
/// non-finite joint targets rather than clamping them, so a single bad `robot.move` would
/// otherwise freeze the robot on its hold pose until reboot.
fn slew(ema: &mut f64, target: f64, alpha: f64) {
    if target.is_finite() {
        *ema += alpha * (target - *ema);
    }
}

async fn adopt_startup_pose<T: RobotIo>(
    safety: &mut Safety<T>,
    state: &RobotState,
    period: Duration,
) -> Option<[f64; NUM_JOINTS]> {
    let mut attempt = 0u32;
    // The decoder needs 25 accepted samples. One-second fault backoff between
    // good reads would turn that confirmation into 24 seconds of startup delay.
    // Only this initial, bounded burst uses the existing control period; invalid
    // quaternion data cannot keep an unready robot polling at 50 Hz forever.
    let mut imu_confirmation_reads = duck_control::imu::SFLP_READY_SAMPLES.saturating_sub(1);

    while !state.shutdown.load(Ordering::Relaxed) {
        match safety.read() {
            Ok(sensors) => {
                if let Some(status) = safety.feetech_control_status() {
                    if !status.all_joints_fresh || status.joints_held {
                        state.startup_step(2, "waiting", "等待全部关节的新鲜反馈；未发送目标");
                        tokio::time::sleep(STARTUP_RETRY_INTERVAL).await;
                        continue;
                    }
                    if !status.imu_ready {
                        let delay = if imu_confirmation_reads > 0 {
                            imu_confirmation_reads -= 1;
                            state.startup_step(2, "waiting", "关节反馈已有效；确认 IMU 融合就绪；未发送目标");
                            period
                        } else {
                            state.startup_step(2, "waiting", "关节反馈已有效；IMU 仍未就绪，按原间隔等待；未发送目标");
                            STARTUP_RETRY_INTERVAL
                        };
                        tokio::time::sleep(delay).await;
                        continue;
                    }
                }
                state.startup_bus_failures.store(0, Ordering::Relaxed);
                state.startup_step(2, "success", "第一份有效关节与 IMU 反馈已读取");
                if attempt > 0 {
                    // Only worth a line if it had to wait — otherwise "control loop running"
                    // below already says everything, and this would just double it.
                    tracing::warn!(
                        attempt,
                        hz = 1.0 / period.as_secs_f64(),
                        "the motor bus answered; holding the pose found at startup"
                    );
                }
                return Some(sensors.positions);
            }
            Err(e) => {
                attempt += 1;
                // Published before sleeping, so `robot.health` can name the cause on the
                // very first failure rather than after the first log line.
                state.startup_bus_failures.store(attempt, Ordering::Relaxed);
                state.startup_step(2, "waiting", &e.to_string());
                state.bus_status.store(Some(Arc::new(serde_json::json!({
                    "build":feetech_commissioning::BUILD,"mode":"motion",
                    "phase":"waiting_for_bus","error":e.to_string()
                }))));
                if attempt == 1 || attempt.is_multiple_of(STARTUP_READ_LOG_EVERY) {
                    tracing::warn!(
                        error = %e,
                        attempt,
                        "no answer from the motor bus; waiting, not commanding anything"
                    );
                }
                tokio::time::sleep(STARTUP_RETRY_INTERVAL).await;
            }
        }
    }

    None
}

fn wants_walking_scale(twist: [f64; 3], body_active: bool) -> bool {
    !body_active && twist.iter().any(|v| v.abs() > 1e-6)
}

/// The tick.
///
/// ```text
/// read → observe (fall) → gate (deadman) → policy → safety.apply
/// ```
///
/// Safety holds the only `RobotIo`, so everything above it can propose targets and nothing
/// above it can command a motor.
///
/// A policy that failed to load is survivable, and deliberately so: the loop keeps running
/// at rate, holds its pose, and `robot.health` says why. The updater then rolls the release
/// back. The alternative — refusing to start — becomes a crashloop under
/// `Restart=always` and reaches the health gate as `Unreachable`, which blames the wrong
/// thing in the journal.
/// Load one mode's policy bundle, reporting why not.
///
/// `Ok(None)` is "no policy was wanted", which is healthy; `Err` is "one was wanted and could not
/// be loaded", which is not. Collapsing those two would either make a bench robot look broken or
/// let a release with an unusable bundle pass the health gate.
///
/// Separate from [`build_controller`] because two callers want opposite things from a failure.
/// Startup and a mode switch want it recorded as *the* policy error, which is unhealthy and gets
/// the release rolled back. A `robot.loadPolicy` wants the reason handed back so it can keep the
/// controller it already had — a robot must not lose its gait because somebody tried a file.
/// A policy change between being asked for and being applied.
///
/// The networks load on a thread of their own. `Policy::load` validates and warms up every
/// session, which is most of a second on the board, and this loop cannot stop for that: the
/// swap used to happen only at the home pose, where a stalled command stream cost nothing, but
/// a change to a network that is not driving now happens wherever the robot is — mid-sit,
/// mid-stride — and a walking robot whose targets stop arriving for a second falls over.
struct PendingSwap {
    change: intents::PolicyChange,
    /// The config the change asks for, from the one that is running.
    candidate: params::PolicyParams,
    cfg: params::ResolvedPolicy,
    /// The network that was driving when the request landed is one this change replaces. The
    /// robot goes home first and the new controller starts fresh there, as every change used to.
    /// Otherwise the new controller is swapped in wherever the robot is and continues from the
    /// old one's state — see [`Controller::carry_over`].
    disturbs: bool,
    loading: std::sync::mpsc::Receiver<Result<Option<Controller>, String>>,
    /// What the thread came back with, once it has.
    built: Option<Result<Option<Controller>, String>>,
}

impl PendingSwap {
    /// Collect the thread's answer if it has one. Called once a tick; never blocks.
    fn poll(&mut self) {
        if self.built.is_some() {
            return;
        }
        match self.loading.try_recv() {
            Ok(result) => self.built = Some(result),
            Err(std::sync::mpsc::TryRecvError::Empty) => {}
            Err(std::sync::mpsc::TryRecvError::Disconnected) => {
                self.built = Some(Err(
                    "the policy loading thread ended without a result".to_owned()
                ))
            }
        }
    }

    fn ready(&self) -> bool {
        self.built.is_some()
    }
}

/// Does a change replace the network that is driving the robot right now?
///
/// The report that made this a question: `policy load walk <file>`, a walk, a sit, then `policy
/// reset walk` — and the robot ramped to home and stood up. The reset was right about the config
/// and wrong about the robot: nothing it changed was running. The `sitstand` network had the
/// robot, and it was the same file before and after.
///
/// So a change is compared against what is driving, by the resolved path of that one network — or
/// the whole skill list when a skill is driving, because a skill is addressed by its index in it.
/// `None` driving, or a network that resolves to the same file, is a change the robot need not
/// move for.
///
/// A reload is the exception, and disturbs whatever is in motion: it exists for the case where
/// every path is unchanged and the bytes behind them are not, so the paths cannot say whether the
/// running network is affected. It is also the one change that is never issued while somebody is
/// trying a gait.
///
/// **A seated robot is disturbed by nothing.** The second report: `robotctl policy update` on a
/// robot sitting on the bench, and it ramped to home and stood up — the update ends in a reload,
/// and the reload took the mode switch's path because the sitstand network was driving. But the
/// home-first ramp exists to stop a network being swapped under a *moving* gait, and a seated
/// robot is parked: the network holds a static pose on a constant flag, and `busy()` already says
/// sitting is not travelling. Swapping bytes under that is exactly what `carry_over` was built
/// for — the seat, the flag and the filter anchor go across, and the next tick holds the same
/// pose from the same place. Standing it up to change a file it was not using was the surprise.
fn change_disturbs(
    driving: Option<&Driving>,
    change: &intents::PolicyChange,
    before: &params::ResolvedPolicy,
    after: &params::ResolvedPolicy,
) -> bool {
    let Some(driving) = driving else {
        return false;
    };
    if matches!(driving, Driving::Seated) {
        return false;
    }
    if matches!(change, intents::PolicyChange::Reload) {
        return true;
    }
    match driving {
        Driving::Walk => before.walk != after.walk,
        Driving::Stand => before.stand != after.stand,
        Driving::SitStand => before.sitstand != after.sitstand,
        Driving::Seated => false,
        Driving::GroundPick => before.ground_pick != after.ground_pick,
        Driving::Skill(_) => before.skills != after.skills,
    }
}

/// The config a change asks for, from the one that is running.
///
/// `None` when it cannot be read — a reload of a file that will not parse — which leaves the robot
/// exactly as it is. It is the caller's file and their mistake to fix, and dropping a working
/// policy set over a syntax error would be the worse of the two outcomes.
fn candidate_params(
    change: &intents::PolicyChange,
    current: &params::PolicyParams,
    params_path: &std::path::Path,
    slot_errors: &mut SlotErrors,
) -> Option<params::PolicyParams> {
    let mut candidate = current.clone();
    match change {
        intents::PolicyChange::Slot { slot, path } => candidate.set_slot(*slot, path.clone()),
        intents::PolicyChange::ResetAll => {
            for slot in Slot::ALL {
                candidate.set_slot(slot, None);
            }
        }
        // Re-read `[policy]` from disk, so a skill added since startup is one this robot has
        // without a restart.
        //
        // **Only `[policy]`, and the mode is kept.** The daemons read their config once at
        // startup and that stays true of everything else here — re-reading `[safety]` or
        // `[control]` under a running loop is a different and much larger promise. The mode is
        // carried over because `robot.setMode` deliberately does not write config: adopting the
        // file's mode here would undo a live switch as a side effect of adding a skill.
        intents::PolicyChange::Reload => match params::Params::load(params_path, false) {
            Ok(fresh) => {
                let mode = candidate.mode;
                candidate = fresh.policy;
                candidate.mode = mode;
                // A file may name a skill this board cannot load; the same check startup runs
                // drops it and reports degraded rather than failing.
                drop_unloadable_overrides(&mut candidate, slot_errors);
            }
            Err(e) => {
                tracing::error!(
                    error = %e,
                    path = %params_path.display(),
                    "reload: config will not parse; keeping what is running"
                );
                return None;
            }
        },
    }
    Some(candidate)
}

fn try_controller(
    policy_cfg: &params::ResolvedPolicy,
    limp_fall: bool,
) -> Result<Option<Controller>, PolicyError> {
    if !policy_cfg.enabled {
        tracing::warn!("policy disabled; holding the startup pose");
        return Ok(None);
    }
    {
        let tuning = Tuning {
            action_scale: policy_cfg.action_scale,
            standing_action_scale: policy_cfg.standing_action_scale,
            standing_gain_ratio: policy_cfg.standing_gain_ratio,
            gain: policy_cfg.gain,
            head_lowpass: policy_cfg.head_lowpass,
            legs_lowpass: policy_cfg.legs_lowpass,
        };
        let skills = SkillTuning {
            ground_pick_period: policy_cfg.ground_pick_period,
            ground_pick_end_phase: policy_cfg.ground_pick_end_phase,
            ground_pick_action_scale: policy_cfg.ground_pick_action_scale,
            ground_pick_gain_ratio: policy_cfg.ground_pick_gain_ratio,
            sitstand_rise_s: policy_cfg.sitstand_rise_s,
            sitstand_ramp_s: policy_cfg.sitstand_ramp_s,
            skills: policy_cfg.skills.clone(),
        };
        let paths = PolicyPaths {
            walk: policy_cfg.walk.clone(),
            stand: policy_cfg.stand.clone(),
            sitstand: policy_cfg.sitstand.clone(),
            ground_pick: policy_cfg.ground_pick.clone(),
            // Only the skills whose file resolves — a slot switched off with `"none"` is
            // already filtered out by `resolved_skills`.
            skills: policy_cfg
                .skills
                .iter()
                .filter_map(|skill| skill.resolved_path())
                .collect(),
        };
        match Policy::load(&paths, DEFAULT_STANDING_THRESHOLD) {
            Ok(mut policy) => {
                // Roller mode has no standing network — command magnitude stops selecting
                // it. Nothing else reserves it: limp-fall hands back by *letting* the
                // standing network be selected, which is what stands the robot up.
                // Zero twist continues walking; the stand slot is reserved for fallen recovery.
                policy.set_standing_disabled(policy_cfg.mode == params::Mode::Roller || limp_fall);
                tracing::warn!(
                    mode = policy_cfg.mode.as_str(),
                    walk = %policy_cfg.walk.display(),
                    stand = ?policy_cfg.stand.as_ref().map(|p| p.display().to_string()),
                    sitstand = ?policy_cfg.sitstand.as_ref().map(|p| p.display().to_string()),
                    ground_pick = ?policy_cfg.ground_pick.as_ref().map(|p| p.display().to_string()),
                    kicks = policy_cfg.kick_left.is_some() || policy_cfg.kick_right.is_some(),
                    roulade = ?policy_cfg.roulade.as_ref().map(|p| p.display().to_string()),
                    limp_fall,
                    "policy loaded"
                );
                let controller = Controller::new(policy, tuning, skills);
                Ok(Some(controller))
            }
            Err(e) => Err(e),
        }
    }
}

/// How many times the torque cut on the way to a power-off is tried before giving up.
const POWEROFF_TORQUE_ATTEMPTS: u32 = 3;

/// Cut torque before a power-off, and keep asking until every servo has heard.
///
/// This is the one bus write that has to land. The poweroff it precedes kills this process, so a
/// servo the cut did not reach stays stiff with nothing left running to tell it otherwise — and
/// a robot that sat down and switched off with its legs locked is exactly how a single dropped
/// ack presented, reported in the journal by the last tick that could have retried and acted on by
/// nobody. Torque writes are idempotent, so asking three times costs a few milliseconds on a tick
/// where the robot is sitting still, and it is the last thing this loop does that matters.
fn cut_torque_before_poweroff<T: RobotIo>(safety: &mut Safety<T>) {
    for attempt in 1..=POWEROFF_TORQUE_ATTEMPTS {
        match safety.set_torque(false) {
            Ok(()) => return,
            Err(e) => {
                tracing::warn!(error = %e, attempt, "cannot cut torque before power off")
            }
        }
    }
    tracing::error!(
        attempts = POWEROFF_TORQUE_ATTEMPTS,
        "torque may still be on; powering off anyway"
    );
}

/// Load the other mode's bundle, and only then say the mode changed.
///
/// `Policy::load` validates and warms up each network, so this blocks the loop for a moment.
/// Both callers are places where that costs nothing: a robot holding the home pose, or one with
/// no torque at all.
fn load_mode(
    target_code: u8,
    policy_params: &mut params::PolicyParams,
    policy_cfg: &mut params::ResolvedPolicy,
    controller: &mut Option<Controller>,
    limp_fall: bool,
    state: &RobotState,
    slot_errors: &SlotErrors,
) {
    let target = mode_of(target_code);
    let mut candidate = policy_params.clone();
    candidate.mode = target;
    let cfg = roller::resolved(candidate.resolved(), target_code);
    // A rejected or non-loadable roller model must never discard the working Walk
    // controller. No new mode is published before all networks are ready.
    let built = match try_controller(&cfg, limp_fall) {
        Ok(Some(controller)) => controller,
        Ok(None) => {
            tracing::error!(mode = target.as_str(), "mode switch refused: no policy controller loaded");
            return;
        }
        Err(error) => {
            tracing::error!(mode = target.as_str(), error = %error,
                "mode switch failed: preserving previous controller and mode");
            state.policy_change_error.store(Some(Arc::new(error.to_string())));
            return;
        }
    };
    *controller = Some(built);
    *policy_params = candidate;
    state.policy_error.store(None);
    state.policy_change_error.store(None);
    // Published together with the mode, and only after the load: a client that reads
    // `robot.mode` and gets the new one must not then be told the old mode's networks.
    state.policies.store(Arc::new(PolicyNames::of(&cfg)));
    state.mode.store(target_code, Ordering::Relaxed);
    state
        .policy_slots
        .store(Arc::new(slot_report(policy_params, &cfg, slot_errors)));
    *policy_cfg = cfg;
    tracing::warn!(
        mode = target.as_str(),
        loaded = controller.is_some(),
        "mode switch complete"
    );
}

/// [`try_controller`], with a failure recorded as *the* policy error.
///
/// The startup and mode-switch path: a policy that was wanted and would not load makes the robot
/// unhealthy, which is what gets a bad release rolled back rather than leaving a duck that holds
/// a pose and never walks again.
fn build_controller(
    policy_cfg: &params::ResolvedPolicy,
    limp_fall: bool,
    state: &RobotState,
) -> Option<Controller> {
    match try_controller(policy_cfg, limp_fall) {
        Ok(controller) => controller,
        Err(e) => {
            tracing::error!(error = %e, "policy unavailable; holding the pose");
            state.policy_error.store(Some(Arc::new(e.to_string())));
            None
        }
    }
}
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
