AiBoBoMaker/MicroDuck-BoBoRedesign/03-DuckCode/microduck-hd1910/firmware/duck-ipc-proto/src/lib.rs

//! IPC contracts between the robot's services and their clients.
//!
//! Two namespaces over one wire format:
//!
//!  - `update.*` — `updaterd`'s API, spoken by `robotctl` and later `btd`.
//!  - `robot.*`  — `robotd`'s API. Small on purpose: it is what `updaterd` needs in order
//!    to decide whether an update is safe and whether it worked.
//!
//! **Wire format: JSON-RPC 2.0, one object per line (NDJSON), over a unix socket.**
//! Framing is a single newline. Progress is pushed as a JSON-RPC notification, a message
//! with no `id`, so a client that reconnects mid-update resubscribes and keeps receiving
//! them.
//!
//! ```text
//! → {"jsonrpc":"2.0","id":1,"method":"update.apply","params":{...}}
//! ← {"jsonrpc":"2.0","method":"update.progress","params":{...}}   (no id)
//! ← {"jsonrpc":"2.0","method":"update.progress","params":{...}}
//! ← {"jsonrpc":"2.0","id":1,"result":{...}}
//! ```
//!
//! A method and its parameters are always paired through [`Call`]: build a request with
//! [`Request::call`], read one back with [`Request::as_call`]. There is no way to send a
//! method with another method's parameters.
//!
//! Why JSON-RPC, why a unix socket, and what was measured against both:
//! `docs/design/architecture.md` §2.2.
//!
//! Dependencies stay at serde, serde_json and semver. Every service speaks these types,
//! including the ones on the recovery path, so nothing here may pull in http, tar, crypto
//! or an async runtime.

use serde::{Deserialize, Serialize};
use serde_json::Value;

pub const JSONRPC_VERSION: &str = "2.0";

/// Protocol version, exchanged via [`Call::Hello`].
///
/// Bumped on any incompatible change. A peer speaking a different version is refused
/// rather than misparsed — a stale `robotctl` in someone's shell is normal.
///
/// v2 added `HelloResult::revision`. v3 added the `net.*` and `system.*` namespaces. v4 added
/// `system.authenticate`, which a BLE client must now pass before anything else is served — a v3
/// client would otherwise have every call refused with no idea why. v5 added the `pad.*`
/// namespace, which is additive — a v4 client loses nothing by not knowing it — and bumps anyway,
/// because the version's job is to say "these two peers were not built together". v6 added
/// `robot.init` and `robot.relax`, so powering the joints stops being a subcommand that fights the
/// daemon for the motor bus. During prototyping the wire shape simply changes and this bumps; no
/// accommodation is made for peers that predate a field, because there are none in the field yet.
///
/// # The rule, since a bump has consequences and nothing else states them
///
/// **A bump promises nothing in either direction.** It is not "additive unless stated": v5 was
/// additive and v4 was not, and the constant does not distinguish them. Every binary on a board is
/// expected to come from one release, and the install path is what delivers that.
///
/// **No daemon refuses a call because this number differs.** `updaterd` used to refuse `hello` on
/// an exact `!=`. The premise was sound — a bump promises nothing — and the conclusion did not
/// follow from it: what actually breaks a mismatched peer is a *route it cannot reach* or a
/// *parameter shape that moved*, and each of those refuses itself, by name, on the one call that
/// cannot be served. A gate on the handshake fired on all of them instead, including the calls that
/// were perfectly serveable and including `update apply`, which is how a skew ends. The difference
/// is now *reported* — in `updaterd`'s journal, and in [`HelloResult::api_version`] for a client to
/// compare against its own — and refused nowhere. See `updater/src/ipc.rs`.
///
/// **What refuses instead, and it is narrower on purpose.** A method this release does not have is
/// [`code::METHOD_NOT_FOUND`] naming the method ([`Request::as_call`]). A member of `params` this
/// release does not know is [`code::INVALID_PARAMS`] naming the member, because every params type
/// denies unknown fields — which is the strictness the handshake was reaching for, moved to where it
/// can tell a changed call from an unchanged one. Both were wanted regardless of the gate: v7 added
/// `ApplyOptions::from_dir`, and an older `updaterd` that merely *ignored* it would have installed
/// from its configured source while the operator believed they were sideloading a directory. Silence
/// was the danger there, not disagreement. It reaches only forward — a daemon built before this
/// cannot refuse what it was already ignoring — which is one more reason the bump is still worth
/// making.
///
/// **What a bump therefore costs.** Two peers from different releases are still not interchangeable:
/// a method whose shape moved will fail. It fails on that method now rather than on the handshake,
/// and for the few seconds after an update it costs nothing at all — `robotctl` is a symlink into
/// `current`, so it follows the new release immediately, while `updaterd` is mid-restart of itself.
/// A client that is *persistently* older is a copy taken from somewhere other than
/// `/usr/local/bin/robotctl`.
/// # v7 — `ApplyOptions::from_dir`
///
/// First ships in 0.5.0, which is therefore the version a board has to be on before
/// `robotctl update apply --from` can put anything there.
///
/// **It bumps even though `from_dir` is an optional field an older daemon would happily parse.**
/// That is the reason to bump rather than a reason not to: serde ignores what it does not know, so a
/// v6 `updaterd` would accept `update.apply --from /some/dir` and quietly install from its
/// *configured* source instead — a mirror of the release the operator meant to sideload, or nothing
/// at all.
///
/// Refusing the call outright is what the handshake used to be for, and it is now the params
/// decoder's job: an unknown member of `params` is an [`code::INVALID_PARAMS`] naming the member. A
/// v6 daemon predates that and still ignores the field, which is exactly why the bump stays — it is
/// the honest label for two peers that do not share a release.
/// # v8 — `pad.input`
///
/// A namespace addition of the kind v5 was, and it bumps for the same stated reason: the constant
/// says "these two peers were not built together", not "nothing you knew has changed".
///
/// **What it costs here is smaller than usual, and worth being precise about.** The new method is
/// served by `padd` on a socket of its own, so no existing client loses anything by not knowing it,
/// and a `robotctl` that asks an older `padd` for it finds no socket at all rather than a refusal.
/// The bump lands on nothing that refuses: it records that two peers differ, and the rule that every
/// binary on a board comes from one release is kept by the install path rather than by a handshake.
///
/// # v9 — the skill intents
///
/// `robot.do` (ground pick, kicks, sit↔stand, roulade), `robot.pose` (standing body pose),
/// `robot.mouth`, `robot.shutdown` (sit, then power off) and `robot.mode` (walk vs roller),
/// ported from `microduck_runtime`; `robot.enable` gains `toggle`, the pad's Start
/// evaluated robot-side. Additive, and bumps anyway, per the rule above.
///
/// # v10 — `robot.sound`
///
/// The robot's voice: play a voice-bank tag (chirp, greet, coo, ...), with `wheee` as a
/// held ride the client keeps alive per tick. Additive, same rule.
///
/// # v11 — `tof.stream`
///
/// The head ToF sensor's 8×8 depth frames, served by `tofd` on its own socket. A new
/// namespace, like `pad.*` was: nothing existing changes shape, and a client built before
/// this simply never asks.
///
/// # v12 — `robot.look`
///
/// Gaze as a point instead of joint angles: `robot.head`'s doc always promised both forms,
/// and this is the second one — the daemon runs the IK and answers with the joints it chose.
///
/// # v14 — `robot.chorale`, `chorale.*`
///
/// Several ducks singing one piece in four parts, synchronised over BLE advertisements with no
/// shared clock. `robot.chorale` is the switch; the `chorale.*` namespace is how `btd` — which owns
/// the radio — and `robotd` — which owns the behaviour and the voice — divide the work. Additive:
/// a client that never asks is unaffected, and `chorale.*` is between daemons rather than for
/// clients at all.
///
/// # v13 — `robot.theremin`
///
/// The head ToF becomes an instrument: a hand's distance is the pitch, and the mouth opens
/// with it. Additive, same rule as every method before it — plus an optional `theremin`
/// block in `robot.state`, absent while the instrument is down, so a client from v12 sees
/// exactly the frame it saw before.
///
/// # v15 — `robot.setMode`
///
/// Walk and roller stop being a startup constant: the mode can be switched while the robot runs,
/// which is what the gamepad's held D-pad up does. Additive as a method — but `robot.mode`'s
/// answer, and the policy names in the `robot.subscribe` acknowledgement, can now *change* during
/// a session. A client that read either once and cached it forever was already making an
/// assumption this method breaks; nothing about a frame's shape changes.
///
/// # v16 — `update.show`
///
/// The per-run update transcript: what `updaterd` actually did, phase by phase, with the
/// manifest it verified, the hook output it collected and the units it restarted. Additive
/// as a method — a client that never asks is unaffected — and `update.log`'s entries gain a
/// `run` number pointing at one, which an older client ignores as an unknown member because
/// results are not `deny_unknown_fields`. An older `updaterd` answers `update.show` with
/// [`code::METHOD_NOT_FOUND`] naming it, which is the designed skew behaviour rather than a
/// handshake refusal.
///
/// # v23 — `account.*`
///
/// A robot can belong to a Hugging Face account, which is the thing that has to be true before it
/// can be reached from outside its own LAN: the robot's relay proves to a rendezvous service that
/// it belongs to an account, the service shows a client only its own robots, and those two
/// together are the authorisation a bridged session arrives with. Nothing about the *robot's* own
/// gate changes — there still is not one — see `docs/design/remote-access-design.md` §7.
///
/// Additive as methods, and `updaterd` serves them for the reasons `policy.*` is there: it is the
/// daemon with a network stack, and the credential it stores is also what would reach a private
/// Hub repo. An older `updaterd` answers [`code::METHOD_NOT_FOUND`] naming the method, which is
/// the designed skew behaviour rather than a handshake refusal.
///
/// **`account.login` answers with a code rather than with a token**, and that shape is not an
/// implementation detail: the flow is RFC 8628, so somebody has to read a short code and approve
/// it in a browser, and the client that showed them the code may well be gone by the time they
/// do — a phone that opens a browser backgrounds itself, and iOS then tears the GATT link down.
/// So `login` returns immediately, `updaterd` owns the waiting, and `status` is what a client
/// comes back to. A login that reported success by holding the connection open would work on a
/// laptop and fail on the device it is for.
///
/// # v22 — `robot.skills`, `robot.setSkill`, `robot.removeSkill`
///
/// The last thing in the policy path a terminal on the robot could reach and nothing else could.
/// `[[policy.skill]]` is a repeating table, so `robotctl policy add` wrote it directly — there
/// was no method to route, and a remote client could fetch a policy and fill a *slot* with it but
/// never make it answer to `robot.do` by name.
///
/// `robotd` writes the file and reloads itself, so one call is the whole operation. The
/// alternative was a client writing and then remembering `robot.reloadPolicies`, and one that
/// forgot would leave a robot whose config and behaviour disagree until the next restart.
///
/// [`SkillParams`] is the same shape read and written, and every optional field means "the
/// default for this" — so a client may list, change one field and send it back. An entry that
/// already exists supplies whatever the call leaves out.
///
/// [`SkillsResult`] also carries `built_in`: the names `robot.do` answers to that are not table
/// entries, because the daemon drives them itself. A client listing what a robot can do needs
/// both, and `policies.skills` alone omitted two of the five the pad ships bound to — the same
/// trap `do_names` exists to close on the robot side.
///
/// # v21 — `pad.bindings`, `pad.bind`
///
/// Which button runs which skill stops being a thing only somebody at a keyboard on the robot can
/// change. `robotctl pad bind` edited the config file directly, so unlike every other command it
/// had no wire surface at all and routing could not help.
///
/// **Two methods in `pad.*` that `configd` does not serve.** The rest of that namespace is about
/// the radio and is `configd`'s; a binding is about what a button does to the robot, and checking
/// a name needs the skill list, which only `robotd` has. Routing is per method throughout, so
/// this costs nothing — `policy.*` and `robot.loadPolicy` already split one concept across two
/// daemons the same way. An older `updaterd` or `configd` reached by mistake answers
/// [`code::METHOD_NOT_FOUND`] naming it.
///
/// Additive as methods. `pad.bind` is the first call on either radio transport that **writes the
/// config file**, and it has to be: `padd` re-reads `[pad]` every second, so a binding held in
/// memory would be reverted before the caller let go of the phone. That also means it needs no
/// reload and no restart.
///
/// # v20 — `robot.policies` carries the skills
///
/// One field, and it is what makes any of this usable from something that is not `robotctl`:
/// which one-shot skills a robot has is config now, so a client cannot assume a list and cannot
/// offer a "bow" button without being told there is a bow. The names were already published in
/// `robot.subscribe`'s acknowledgement, but that is a 50 Hz stream and the question is asked
/// once — the wrong shape for a phone, and BLE deliberately does not route it.
///
/// Additive: a client that ignores the field is unaffected, and an older `robotd` omits it,
/// which deserialises to empty rather than failing because results are not
/// `deny_unknown_fields`. A client reading an empty list should treat it as "this robot did not
/// say" rather than "this robot has no skills" — the same distinction `unavailable` draws for
/// the gait.
///
/// # v19 — `policy.*` and `robot.reloadPolicies`
///
/// The official policy set stops needing a daemon release to change. `policy.check` asks the Hub
/// what revisions exist against the one installed, `policy.install` fetches one, and
/// `robot.reloadPolicies` is how the thing that swapped the set tells `robotd` to re-read it —
/// necessary because installing a set swaps a symlink *underneath* unchanged paths, so
/// `robot.loadPolicy` would correctly conclude there was nothing to do.
///
/// Additive as methods. `policy.*` is the first namespace `updaterd` serves that is not
/// `update.*`, and it is there rather than in `robotd` because it needs a network stack, and not
/// in `robotctl` because that must not link one. See `docs/design/policy-channel-design.md` §8.
///
/// # v18 — `robot.policies`, `robot.loadPolicy`
///
/// Which `.onnx` fills a slot stops being a restart-only decision: a policy can be swapped into
/// one slot while the robot runs, and dropped again, without editing a file by hand. Additive as
/// methods, and the state they expose was previously unavailable at all rather than available in
/// another shape, so nothing an older client reads changes meaning — the policy names in the
/// `robot.subscribe` acknowledgement could already change mid-session as of v15.
///
/// **`robot.loadPolicy` persists.** A slot is `[policy] <slot>` in `robotd.toml` and nothing
/// else, so the daemon writes the key before it queues the swap and a gait chosen over the wire
/// is the gait the robot boots into. Worth stating on the wire rather than only in the daemon,
/// because it is the difference between a call a client offers as "try this" and one it offers
/// as "use this" — and the undo is the same method with no path, not a restart.
///
/// An older `robotd` answers either with [`code::METHOD_NOT_FOUND`] naming the method, which is
/// the designed skew behaviour and not a handshake refusal. See
/// `docs/design/policy-channel-design.md` §8.
///
/// # v17 — a unit state that can say "crash loop"
///
/// [`UnitState`] gains `Restarting` and `Failed`, which `system.services` can now answer with.
/// Not additive in the way a new method is: an older client deserialising a `Vec<ServiceUnit>`
/// rejects a member it has no variant for, and `robotctl` reads that reply with `.ok()` — so an
/// older `robotctl` against this `configd` prints no `units` block at all rather than a wrong one.
/// Both come out of the same release and an apply restarts both, so the skew lasts as long as the
/// update does; a board left mid-update sees a missing block, not a lie.
///
/// # v24 — a clock every stream shares, and what a map needs from the robot
///
/// Three additive fields and one read, for a mapper that pairs a camera frame with the joint
/// angles and depth cells of the same instant (`docs/design/robotd-design.md` §mapping):
///
/// - [`RobotState::t_ns`] and [`TofFrame::t_ns`] are the same `CLOCK_MONOTONIC`, nanoseconds,
///   so a sample from `robotd` and a frame from `tofd` can be put on one axis without guessing
///   the offset between two daemons' start times. `t` and `at_us` stay as they were.
/// - [`RobotState::imu`] is the trunk IMU as the loop sees it: gyro and orientation, not only
///   the projected gravity [`SafetyState`] already carried. [`RobotState::frames`] is the
///   camera and ToF sensor pose in the trunk frame, from the same head FK `robot.look` uses —
///   published so no client has to carry a copy of the kinematics.
/// - `robot.model` ([`ModelResult`]) answers the static geometry those poses are stated in.
///
/// `mediad`'s `media.video` answer gains `mono_ns` and `real_ns`, the two clocks read at the
/// same instant, so a peer can put RTP timestamps (whose RTCP sender reports are wall-clock)
/// onto the same monotonic axis. Additive everywhere: an older client ignores fields it does
/// not know, and an older daemon leaves them at their defaults (zero, or absent).
///
/// # v25 — the whole skeleton's pose, for a viewer
///
/// [`RobotState::skeleton`] carries every body's pose in the trunk frame this tick, and
/// [`ModelResult::skeleton`] the matching static tree (each link's name and parent). Together they
/// let a viewer draw the robot moving for real — the full kinematics, of which
/// [`RobotState::frames`] (camera, ToF, head IMU) is a few leaves — without carrying a copy of the
/// kinematics, the same reason `frames` and `tof_beams` come from the robot. Both from the same FK
/// `robot.look` uses. Additive: the `Vec`s are empty from a daemon predating it.
///
/// # v26 — `system.logs`
///
/// The tail of one daemon's journal, over the wire. Until now the answer to "what did it say
/// before it stopped" was `journalctl` over ssh, which needs a network the robot may not have and
/// an address a phone has no way to reach — so the one question support asks first was the one
/// question the wire could not answer.
///
/// Additive as a method, and narrow on purpose: a unit from a fixed list, a line count, and which
/// boot. Not a `journalctl` command line — see [`LogsParams`] for why that boundary is where it is.
///
/// An older `configd` answers [`code::METHOD_NOT_FOUND`] naming the method, which is the designed
/// skew and not a handshake refusal: a new `duckctl` against a robot on an older release reports
/// that the robot is too old rather than failing obscurely.
///
/// # v28 — `detector.*`
///
/// The duck detector leaves the release the way the policies did at v19: `mediad` reads it from
/// `/opt/robot/detector/current`, the release's postinstall hook seeds that from a pinned Hub
/// revision, and `detector.check` / `detector.install` are how a board asks what exists and
/// moves to it — `policy.check` / `policy.install` with a different root, answered by the same
/// daemon for the same reason (it has the network stack). An install restarts `mediad`, which is
/// where the model is loaded, and says whether that took.
///
/// Additive as methods; the parameters and answers are the policy set's own types.
///
/// # v27 — the pad's IMU, on the pad tap
///
/// Three more [`PadReport`] variants: a pad's inertial unit as a second evdev node beside the one
/// that drives, its samples, and its going away. The "Pro Controller" Switch clones ship a
/// six-axis IMU and the kernel's `hid-nintendo` exposes it as a separate accelerometer device
/// under the same HID parent; an Xbox pad has none and a subscriber never sees the variants.
///
/// A new variant on a tagged enum is what a robotctl built before it cannot decode, which is the
/// one reason this is a bump rather than a note: the tap is still `padd`'s own socket, and every
/// other client is untouched.
/// # v30 — `homed`, so a client can wait instead of guessing
///
/// One `Option<bool>` on [`PoliciesResult`]. `robot.do` refuses a skill while the robot is on its
/// way to its home pose, and that refusal is a second old and resolves by itself — but from the
/// wire it is `accepted: false` and a sentence, indistinguishable from "press Start on the pad",
/// which stays true until somebody acts. A client that installs a policy triggers a reload,
/// the reload sends the robot home, and the `robot.do` that follows is refused by the client's own
/// previous call. Without this the only ways out are matching on the reason string or retrying
/// blindly through refusals that will never clear.
///
/// `None` is "this robot does not say", which is what an older `robotd` sends and what a client
/// must fall back from rather than read as `false`.
/// # v31 — `sitting`, because "stand up" is two calls
///
/// One more `Option<bool>` on [`PoliciesResult`], beside `homed` and for the same reason: a client
/// choosing what to send needs the robot's answer rather than its own guess. A duck on its feet
/// stands with `robot.init`; a duck in its seat is held there by the `sit_toggle` latch, and
/// `init` argues with that rather than winning. Without it a client either guesses — sitting a
/// standing duck down every other press — or asks somebody to reach for the pad, which is what the
/// playground did.
/// # v32 — a status that can say "degraded"
///
/// Two fields on [`ComponentStatus`], beside `healthy`, which was a boolean answering a
/// three-way question. `updaterd` asks `robotd` for a verdict and gets one of five; the health
/// gate sorts them into *commit* (healthy, degraded) and *revert* (unhealthy, unreachable,
/// unreadable), which is the three-way question `updater-design.md` §8 states. Status collapsed
/// all four non-healthy verdicts into `healthy: false`, so a bench board with no servo power —
/// a release the gate had just committed, running correctly — was indistinguishable on the wire
/// from a robot whose control loop was dead.
///
/// That cost real time: it is how a rolled-back release was read as having been rolled back over
/// its policy set. §4.1 asks of this route that "the app must be able to see 'daemon unhealthy,
/// version X, last update failed'", and the app could not.
///
/// Both default, so an older `updaterd` reads exactly as it did before: `degraded` false is the
/// strict verdict, and `reason` absent is "it did not say".
/// # v33 — what the heat is costing, beside the temperature
///
/// One `Option<CpuThrottle>` on [`HealthResult`], beside `cpu_temp_c`. A board reported as
/// "96 °C" reads as a warm robot; the same board is in fact pinned to 408 MHz of 1800 by the
/// thermal governor, which is the sentence that explains a duck walking badly. Without it the
/// clock ceiling is only reachable by sshing to the robot and reading `sysfs` — which is not
/// something the one command a human already runs should send them away to do.
///
/// `None` is "this robot does not say": an older `robotd`, or a board with no `cpufreq` sysfs.
/// # v34 — what a policy is, on the line that lists it
///
/// `description` and `preview` on [`PolicySearchHit`]. A search answered with `org/name`, an
/// origin and a like count, which is enough to install something and not enough to choose it:
/// every hit is somebody's `microduck-<something>`, and the name was the whole of what a person
/// had to go on. The description was already in the manifest, already read on the fetch path and
/// already shown by the policy playground — a list of policies is where it is wanted, and a
/// search that makes someone install a policy to find out what it does is why it is here now.
///
/// Both are absent from an older `updaterd` and neither needs a fallback: a client with no
/// description shows the id, which is what it showed before.
///
/// # v35 — when the update source last answered
///
/// One `Option<i64>` on [`ComponentStatus`]. `update.status` says when each component's update
/// source last answered with a manifest that verified, so a robot that has stopped reaching its
/// source stops looking up to date: a failed check left the installed release and no error, which
/// is what a robot with nothing to install looks like.
///
/// Absent is "it has not answered since this robot started recording", which is what an older
/// `updaterd` sends and what a client must not read as a fresh check.
///
/// # v36 — measured joint velocity and load, on the state stream
///
/// [`RobotState::velocities`] and [`RobotState::currents_ma`]: the two blocks the control loop has
/// read beside position on every tick and never published. Neither is recoverable from outside
/// the daemon — differencing `joints` across a decimated subscription is not a velocity, and
/// present current is the only measure of external force this robot has. Additive, on the rule
/// `odom` set: absent from a daemon predating it, and absent stays distinguishable from zero.
///
/// Absent is also what a backend with nothing to measure sends — `--fake` has no servos — and
/// what a robot with `[control] publish_velocity_and_load` off sends. A client that reads absent
/// as "not told" rather than as zero handles all three without having to know which.
///
/// # v37 — how the last check of the update source went
///
/// [`ComponentStatus::last_check_attempt`]: when the last check ran, and the error if it got no
/// answer. v35 made "never answered" visible, and it was two states: checks that keep failing, and
/// an `updaterd` that has not run its first check yet — every board for the minute after it
/// starts, including the one right after the update that brought v35 in. Both warned. The attempt
/// tells them apart, and its error is what the warning was pointing at the journal for.
/// # v38 — R17 read-only loaded calibration in motion as well as commissioning
/// Requires the matching R17 control.5 robotd/padd bundle. Raw bus mutations remain
/// commissioning-only; model API and official input/action wire types are unchanged.
/// # v39 — R17 read-only binary raw telemetry on a dedicated robotd connection
/// `robot.rawSubscribe` acknowledges JSON-RPC once, then streams u32-LE framed records.
/// The matching R17 control.27/console bundle is required; robot.subscribe remains unchanged.
/// # v40 — R17 model-bound uniform joint policy output settings
/// Loaded model metadata includes its validated, fixed runtime execution settings;
/// existing readback reports the applied scale and filters. Install the
/// matching R17 control.29/console bundle; the raw record envelope is unchanged.
pub const API_VERSION: u32 = 40;

/// The observation width every policy this robot family runs is built against.
///
/// Here rather than only in `duck_control` because it is a **contract with whoever publishes a
/// policy**, not an implementation detail: it is what a repo's manifest declares, what
/// `updaterd` refuses a mismatched policy on before downloading it, and what `robotd` refuses it
/// on at load. `duck_control::obs` is still where the observation is built, and a test there
/// asserts the two agree.
pub const POLICY_OBS_LEN: usize = 61;

/// The action count, on the same footing as [`POLICY_OBS_LEN`]: fifteen servos, fourteen of them
/// driven by a policy.
pub const POLICY_ACTION_LEN: usize = 14;

/// The robot this daemon drives, as a policy manifest spells it. Refusing a policy published for
/// something else is cheaper than discovering it in the way the robot moves.
pub const ROBOT_MODEL: &str = "microduck";

/// The longest an update may legitimately go quiet, in seconds — the pre-install hook's ceiling.
///
/// **Here rather than in `updater`, because it is a contract with every client.** The phase
/// notification for a hook arrives *before* the hook runs, so a client watching an apply sees
/// nothing at all while the hook works — and that hook installs what a release needs and the board
/// may not have: ONNX Runtime, and around 100 MB of apt for `mediad`'s GStreamer stack on a board
/// that has never had it. A client whose idle budget is shorter than this reports a working update
/// as a robot that stopped answering, which is exactly what `duckctl` did the first time this
/// ceiling moved.
///
/// `updaterd` enforces it and every client sizes its own budget above it. Both read this constant,
/// so the two cannot disagree.
pub const UPDATE_MAX_SILENCE_SECONDS: u64 = 600;

pub const DEFAULT_SOCKET: &str = "/run/updaterd.sock";

/// Where each service listens by default.
///
/// These are defaults matching the shipped units, not a contract the daemons are bound by —
/// every one takes a `--socket` override, and `updaterd` reads `robot_socket` from its config.
/// They live here because more than one client needs them: `robotctl` and `btd` both connect
/// to all three, and a path duplicated per client is a path that drifts per client.
pub mod socket {
    /// `updaterd`. Same value as [`super::DEFAULT_SOCKET`], which predates this module.
    pub const UPDATER: &str = super::DEFAULT_SOCKET;
    pub const ROBOT: &str = "/run/robotd.sock";
    pub const CONFIG: &str = "/run/configd.sock";
    /// `padd`'s raw input tap — [`super::method::PAD_INPUT`], and nothing else.
    ///
    /// Under `/run/padd/` because that is `padd`'s `RuntimeDirectory=`, which is the only place a
    /// process running under `ProtectSystem=strict` may create a file. systemd removes the
    /// directory when the unit stops, so a socket left behind cannot outlive the daemon that
    /// would have answered on it.
    pub const PAD: &str = "/run/padd/pad.sock";

    /// `tofd`'s depth stream — [`super::method::TOF_STREAM`], and nothing else.
    /// Under `/run/tofd/` for the same reason as the pad's: it is that unit's
    /// `RuntimeDirectory=`, so systemd removes the socket when the daemon stops.
    pub const TOF: &str = "/run/tofd/tof.sock";

    /// `mediad`'s on-demand raw-frame endpoint. It is local-only: a raw camera frame is for a
    /// recorder or perception process on the robot, not a multi-megabyte WebRTC control reply.
    pub const MEDIA: &str = "/run/mediad/media.sock";
}

/// Where each daemon publishes what it is running: `/run/<service>/identity.json`.
///
/// One directory per service rather than one shared directory, because that is what
/// `RuntimeDirectory=<service>` in a unit file gives — and it has to be that, for two reasons no
/// tidier layout survives. `btd` and `padd` run under `ProtectSystem=strict`, so the filesystem is
/// read-only to them *except* what systemd grants, and `RuntimeDirectory` is the grant. And systemd
/// deletes the directory when the unit stops, so a stopped daemon cannot leave a stale identity
/// behind claiming to be running.
pub fn identity_path(service: &str) -> std::path::PathBuf {
    runtime_root().join(service).join("identity.json")
}

/// Where the per-service runtime directories live: `/run`, unless `DUCK_RUNTIME_DIR` says otherwise.
///
/// Not a configuration knob for a robot — nothing on the board sets it. It exists so this is testable
/// at all, since a test cannot write to `/run`, and it is the same reason a daemon run by hand on a
/// laptop can publish an identity: `/run` is root-owned there too, and on macOS it does not exist.
pub fn runtime_root() -> std::path::PathBuf {
    std::env::var_os("DUCK_RUNTIME_DIR")
        .map(std::path::PathBuf::from)
        .unwrap_or_else(|| std::path::PathBuf::from("/run"))
}

/// The robot's joint order, as every positional vector on the wire is indexed.
///
/// It lives here rather than in `duck_control::model` because it *is* protocol:
/// [`RobotState::joints`] and [`RobotState::targets`] are bare arrays of numbers, and a
/// client that cannot name index 3 cannot display them. `duck-control` re-exports this
/// table, so the wire order and the order the servos are driven in are one list, not two
/// that must be kept in step.
///
/// Left leg (5) · neck/head/mouth (5) · right leg (5).
pub const JOINT_NAMES: [&str; 15] = [
    "left_hip_yaw",
    "left_hip_roll",
    "left_hip_pitch",
    "left_knee",
    "left_ankle",
    "neck_pitch",
    "head_pitch",
    "head_yaw",
    "head_roll",
    "mouth",
    "right_hip_yaw",
    "right_hip_roll",
    "right_hip_pitch",
    "right_knee",
    "right_ankle",
];

/// Method names, as they go on the wire. Namespaced so a new namespace cannot collide
/// with `update.*`. [`Call`] is the typed form.
pub mod method {
    pub const HELLO: &str = "hello";

    /// One raw camera frame. `mediad` answers the JSON-RPC header, followed immediately by the
    /// bytes named in that header, on its local Unix socket.
    /// Deliberately not a `Call`: its binary tail must never enter Service/Lane routing
    /// or the WebRTC control datachannel. Local clients dial `socket::MEDIA` explicitly.
    pub const MEDIA_FRAME: &str = "media.frame";

    pub const CHECK: &str = "update.check";
    pub const APPLY: &str = "update.apply";
    pub const ROLLBACK: &str = "update.rollback";
    pub const RESET_TO_GOLDEN: &str = "update.resetToGolden";
    pub const SELECT: &str = "update.select";
    pub const PIN: &str = "update.pin";
    pub const STATUS: &str = "update.status";
    pub const LIST_INSTALLED: &str = "update.listInstalled";
    pub const LOG: &str = "update.log";
    pub const SHOW: &str = "update.show";
    pub const SUBSCRIBE: &str = "update.subscribe";

    /// Server → client notification. Never carries an `id`.
    pub const PROGRESS: &str = "update.progress";

    // ── robotd's side ────────────────────────────────────────────────────────
    //
    // `updaterd` calls these. Every one must be answerable while the robot is in a bad
    // state — that is the whole point of asking.

    /// May the control loop be restarted right now?
    pub const ROBOT_SAFE_TO_RESTART: &str = "robot.safeToRestart";
    /// Did the robot come up correctly? The post-update health gate.
    pub const ROBOT_HEALTH: &str = "robot.health";
    /// Which model API version does this build implement?
    pub const ROBOT_MODEL_API: &str = "robot.modelApi";
    /// Is a telepresence session live?
    pub const ROBOT_SESSION_ACTIVE: &str = "robot.remoteSessionActive";

    // ── intents ──────────────────────────────────────────────────────────────
    //
    // What a client asks the robot to *do*, as opposed to what `updaterd` asks it about.
    // Clients send intents, never joint commands: `robotd` stays authoritative on what is
    // executable (`architecture.md` §6).
    //
    // Two kinds, and JSON-RPC's two message families map onto them exactly:
    //
    //   * **Continuous** — `move`, `head`. Sent as *notifications* (no `id`, no reply),
    //     20–50 Hz, last-writer-wins, expiring. No response traffic at rate, and when they
    //     later travel over WebRTC they belong on the unreliable channel, because a
    //     retransmitted 80 ms-old stick position is worse than useless (`architecture.md`
    //     §5.2). The message family already says which channel it wants.
    //   * **Discrete** — `stop`, `enable`. Sent as *requests*, answered, because the caller
    //     needs to know whether it was accepted and why not.

    /// Velocity twist. Continuous; send as a notification.
    pub const ROBOT_MOVE: &str = "robot.move";
    /// Head joint targets. Continuous; send as a notification.
    pub const ROBOT_HEAD: &str = "robot.head";
    /// Point the camera at a trunk-frame point; the daemon runs the gaze IK.
    /// Discrete; send as a request — the answer says what the head will do.
    pub const ROBOT_LOOK: &str = "robot.look";
    /// Stop moving — zero the velocity. Not "go limp".
    pub const ROBOT_STOP: &str = "robot.stop";
    /// Turn policy execution on or off.
    pub const ROBOT_ENABLE: &str = "robot.enable";

    // ── power to the joints ──────────────────────────────────────────────────
    //
    // The pair, and they are a pair: nothing else in this API turns the motors on or off.
    // `robot.enable` is about the *policy* — it can bring a limp robot up as a side effect of
    // being asked to drive, but "stand up" and "let go" are their own decisions and deserve
    // their own names.
    //
    // Both belong to `robotd` rather than to a subcommand, which is the point of adding them:
    // `robotd init` opens the motor bus itself, so it needs the daemon stopped, and two writers
    // on one UART corrupt each other's replies. The daemon owns the bus; ask the daemon.

    /// Power the joints and ramp to the home pose.
    ///
    /// Unlike [`ROBOT_ENABLE`] this needs no policy: "stand up" is a reasonable thing to ask of a
    /// robot with no walking network at all, and it is what a bench robot needs before anything
    /// else can be tested.
    pub const ROBOT_INIT: &str = "robot.init";

    /// Cut power to the joints. **The robot will collapse** if nothing is holding it.
    ///
    /// Named `relax` rather than `limp` because `gain_limp` already means something else — the soft
    /// yield a fallen robot is commanded at, which keeps torque on. This is the register.
    pub const ROBOT_RELAX: &str = "robot.relax";

    /// Reboot servos: the REBOOT instruction, which clears a latched hardware error (overload,
    /// overheating, electrical shock) that otherwise holds torque off until the battery is pulled.
    /// Torque is cut on every joint first and the robot is back at limp afterwards, so `robot.init`
    /// or `robot.enable` brings it up from a known state. Discrete; send as a request.
    pub const ROBOT_REBOOT_MOTORS: &str = "robot.rebootMotors";

    // ── skills ───────────────────────────────────────────────────────────────
    //
    // One-shot scripted moves, ported from `microduck_runtime`. Each swaps a dedicated
    // policy in for a fixed window (or, for sit, until toggled back); the observation
    // layout is the same 61-D vector throughout, so a skill is a session choice plus a
    // command-block encoding, not a new contract.

    /// Run a one-shot skill, or toggle sit↔stand. Answered — a refusal names the
    /// scripted move already holding the robot.
    pub const ROBOT_DO: &str = "robot.do";
    /// Standing body pose: z / roll / pitch offsets. Continuous; send as a notification.
    ///
    /// `active: false` snaps the pose back to nominal — that is the prototype's B-button
    /// exit, which zeroes instantly rather than gliding.
    pub const ROBOT_POSE: &str = "robot.pose";
    /// Mouth opening, 0 (closed) to 1 (open). Continuous; send as a notification. The mouth
    /// is not part of any policy — this is the only thing that moves it.
    pub const ROBOT_MOUTH: &str = "robot.mouth";
    /// Play one of the robot's voice-bank sounds — chirp, greet, coo... `wheee` is the
    /// held ride: `hold: true` starts it and must keep arriving (a notification per tick,
    /// like the mouth) or the ride ends; `hold: false` releases it deliberately. The two
    /// endings differ: a deliberate release cuts the ride, a hold that stops arriving plays
    /// it out through its end segment.
    ///
    /// Refused, with a reason, by a robot that has no voice — audio disabled, or no bank
    /// rendered. Sounds are never refused for circumstance (a chirp out of a fallen robot
    /// is diagnostics, not danger), but "accepted" from a robot that cannot make a sound
    /// would make `robotctl quack` lie about which duck answered.
    pub const ROBOT_SOUND: &str = "robot.sound";
    /// Open, interrupt, or hang up the bobo voice call.
    ///
    /// One request, no parameters. Idle connects and listens; speaking aborts the current
    /// sentence; listening closes the socket. The pad's unused buttons send it. The answer
    /// is [`IntentResult`]: refused when the config has no server, accepted once the call
    /// has been asked to change — the socket itself finishes in the background.
    pub const ROBOT_VOICE: &str = "robot.voice";
    /// Pick the ToF theremin up, or put it down: the head's depth sensor becomes an
    /// instrument, and the distance of a hand in front of the beak is the pitch — and the
    /// mouth opening, which rises with it, so the note is visible as well as audible.
    ///
    /// Discrete; send as a request, and idempotent both ways. The answer says whether the
    /// robot took the instrument — it has a voice, and depth frames are arriving. From then
    /// on the nearest return inside the playable band is the hand: an explicit mode with
    /// nothing clever inside it, because the clever version could not be relied on to mean
    /// the same thing twice on real frames.
    ///
    /// [`ROBOT_STATE`]'s `theremin` block carries the live pitch, the mouth, and a line of
    /// what the sensor said about the frame — which is the field diagnostic for this whole
    /// feature.
    pub const ROBOT_THEREMIN: &str = "robot.theremin";
    /// Start or stop looking for other ducks to sing with. Discrete; the answer is
    /// [`super::ChoraleResult`].
    ///
    /// What it starts is *listening*, not singing: the robot begins broadcasting a beacon saying
    /// it is willing, and watching for others. Two willing ducks in radio range then start a piece
    /// between themselves with nobody in charge — the lower id conducts — and a third joins what it
    /// finds already under way.
    ///
    /// Refused outright by a robot whose config has not opted in (`[chorale] accept`), which is
    /// false by default: a chorale moves the mouth and the head, and a robot that began animating
    /// because another robot walked into the room would be doing unrequested motion.
    pub const ROBOT_CHORALE: &str = "robot.chorale";
    /// Sit down gracefully, then power the machine off. The prototype's Select long-press.
    pub const ROBOT_SHUTDOWN: &str = "robot.shutdown";
    /// Which drive mode this `robotd` is in: `walk` or `roller`.
    ///
    /// `[policy] mode` is where it starts; [`ROBOT_SET_MODE`] moves it while the robot runs, so
    /// this is a question with a changing answer rather than a startup constant. Exists so `padd`
    /// can shape its stick mapping to the mode without owning config it has no business reading.
    pub const ROBOT_MODE: &str = "robot.mode";

    /// Switch drive mode: `walk` or `roller`.
    ///
    /// Held on the gamepad's D-pad up, as the prototype held it — putting wheels on a duck is a
    /// thing you do in the room with it, not from a laptop. The robot returns to its home pose,
    /// loads the other mode's policies, and drives again; the config is untouched, so a reboot
    /// comes back in the configured mode.
    pub const ROBOT_SET_MODE: &str = "robot.setMode";
    /// Select or query the self-trained deployment action multiplier.

    /// What each policy slot is running, and where that file came from.
    ///
    /// Distinct from [`ROBOT_MODE`], which says which *set* of slots is in play. This says what
    /// is in them — and, when a load failed, what is in them instead of what was asked for.
    pub const ROBOT_POLICIES: &str = "robot.policies";

    /// The static geometry [`RobotState::frames`] and [`TofFrame`] are stated in — see
    /// [`ModelResult`]. A read; asked once per session.
    pub const ROBOT_MODEL: &str = "robot.model";

    /// Put a different `.onnx` in one slot, or drop an override and go back to the default.
    ///
    /// Answered like [`ROBOT_SET_MODE`] and for the same reason: the swap happens at the home
    /// pose, seconds later, so the reply says the request was accepted and
    /// [`ROBOT_POLICIES`] says what came of it.
    pub const ROBOT_LOAD_POLICY: &str = "robot.loadPolicy";

    /// Re-read every policy slot from disk, whatever the paths say.
    ///
    /// Distinct from [`ROBOT_LOAD_POLICY`] because the paths do not change: installing a newer
    /// official set swaps a symlink underneath them, so every slot still resolves to the same
    /// string and a load would correctly conclude there is nothing to do. This is how the thing
    /// that swapped the symlink says otherwise.
    pub const ROBOT_RELOAD_POLICIES: &str = "robot.reloadPolicies";

    // ── policy.* ─────────────────────────────────────────────────────────────
    //
    // Served by `updaterd`, not `robotd`, and the split is the same one everywhere else here:
    // `robotd` says what it is *running*, `updaterd` is the thing with a network stack and is
    // therefore what asks the Hub what exists. `robotctl` must not link an HTTP client — it is on
    // the recovery path and its dependency list is deliberately short — so the fetch cannot live
    // in the CLI either. `docs/design/policy-channel-design.md` §8.

    /// Is there a newer policy set than the one installed?
    pub const POLICY_CHECK: &str = "policy.check";
    /// Install a policy set from the Hub and make it live.
    pub const POLICY_INSTALL: &str = "policy.install";
    /// Fetch one policy from any Hub repo into this robot's library.
    pub const POLICY_FETCH: &str = "policy.fetch";
    /// Search the Hub for policies.
    pub const POLICY_SEARCH: &str = "policy.search";

    // ── detector.* ───────────────────────────────────────────────────────────
    //
    // The duck detector's set, served by `updaterd` for `policy.*`'s reason. The answers are
    // `policy.*`'s types: a set is a set, whatever is in it.

    /// Is there a newer duck detector than the one installed?
    pub const DETECTOR_CHECK: &str = "detector.check";
    /// Install a duck detector from the Hub, and restart `mediad` onto it.
    pub const DETECTOR_INSTALL: &str = "detector.install";

    // ── account.* ────────────────────────────────────────────────────────────
    //
    // Which Hugging Face account this robot belongs to. Served by `updaterd` for `policy.*`'s
    // reasons exactly — it is the daemon with a network stack, and `robotctl` must not link one —
    // and because the credential it stores is also what reaches a *private* Hub repo, which is
    // already this daemon's job.
    //
    // The account is what makes a robot reachable from outside the LAN: the relay proves the robot
    // belongs to an account, the rendezvous service shows a client only its own robots, and the
    // pair of those is the authorisation a bridged session arrives with.
    // `docs/design/remote-access-design.md` §2.

    /// Begin an OAuth device-code login. Answers immediately with a code to show somebody.
    pub const ACCOUNT_LOGIN: &str = "account.login";
    /// Which account this robot belongs to, and whether a login is in flight.
    pub const ACCOUNT_STATUS: &str = "account.status";
    /// Forget the account. The robot stops being reachable from outside the LAN.
    pub const ACCOUNT_LOGOUT: &str = "account.logout";

    /// Turn the connection into a stream of [`ROBOT_STATE`] notifications.
    pub const ROBOT_SUBSCRIBE: &str = "robot.subscribe";
    pub const ROBOT_RAW_SUBSCRIBE: &str = "robot.rawSubscribe";
    /// Server → client. Never carries an `id`.
    ///
    /// One stream for every consumer — `robotctl monitor`, a digital-twin viewer, later the
    /// app through `mediad`. It replaces the prototype's five bespoke channels: a 180-byte
    /// binary frame on 9870, JPEG on 9871, a UDP command socket on 9872, maploc on
    /// 9874/9875, and the web hub's `/state.json`. Adding a field there meant editing four
    /// places that could silently disagree; here it is one struct, and older clients ignore
    /// what they do not recognise.
    pub const ROBOT_STATE: &str = "robot.state";
    // ── configd's side ───────────────────────────────────────────────────────
    //
    // Wifi and the robot's identity. Served by `configd` rather than `robotd` because config
    // must be reachable when the robot is dead — provisioning wifi is exactly what a client
    // needs when things are broken (`architecture.md` §3.1).
    //
    // NetworkManager owns the credentials; these methods drive it. We never store a PSK.

    /// What is the wifi doing — SSID, signal, addresses.
    pub const NET_STATUS: &str = "net.status";
    /// Which networks can this robot see?
    pub const NET_SCAN: &str = "net.scan";
    /// Join a network, storing it for next time.
    pub const NET_CONNECT: &str = "net.connect";
    /// Forget a stored network.
    pub const NET_FORGET: &str = "net.forget";

    /// Name, serial, uptime.
    pub const SYSTEM_INFO: &str = "system.info";
    /// What systemd says about each daemon, and which release each is running from.
    pub const SYSTEM_SERVICES: &str = "system.services";
    /// The tail of one unit's journal, for a client with no shell on the robot.
    pub const SYSTEM_LOGS: &str = "system.logs";
    /// Rename the robot. This is the name a phone sees.
    pub const SYSTEM_SET_NAME: &str = "system.setName";
    /// Reboot, cleanly, through systemd.
    pub const SYSTEM_REBOOT: &str = "system.reboot";
    /// The Bluetooth pairing PIN. Never reachable over Bluetooth itself.
    pub const SYSTEM_PAIRING_PIN: &str = "system.pairingPin";
    /// Set the Bluetooth pairing PIN.
    pub const SYSTEM_SET_PAIRING_PIN: &str = "system.setPairingPin";
    /// Prove knowledge of the pairing PIN. Answered by the transport, not by a service.
    pub const SYSTEM_AUTHENTICATE: &str = "system.authenticate";

    // ── pad.* ────────────────────────────────────────────────────────────────
    //
    // A gamepad, as a *thing paired to the robot* rather than as a control transport. `padd`
    // reads the pad and sends intents; this namespace only decides which pad the board knows
    // about, which is a Bluetooth question and therefore `configd`'s (it is the service that
    // already owns the radio's configuration side, and the one running as root).
    //
    // Pairing is deliberately not `padd`'s own job: `padd` is an *unprivileged intent client*,
    // and the whole point of it having no privileged access is that it exercises the same API the
    // phone app will. Letting it configure BlueZ would have undone that.

    /// Which pads this robot knows, and whether `padd` is driving from one.
    pub const PAD_STATUS: &str = "pad.status";
    /// Pair the gamepad that is in pairing mode now.
    pub const PAD_PAIR: &str = "pad.pair";
    /// Forget a pad, so it stops reconnecting.
    pub const PAD_FORGET: &str = "pad.forget";
    pub const PAD_BINDINGS: &str = "pad.bindings";
    pub const PAD_BIND: &str = "pad.bind";
    pub const ROBOT_SKILLS: &str = "robot.skills";
    pub const ROBOT_SET_SKILL: &str = "robot.setSkill";
    pub const ROBOT_REMOVE_SKILL: &str = "robot.removeSkill";

    /// Subscribe to the raw input stream of the pad `padd` is driving from.
    ///
    /// **The one method in this namespace `padd` answers itself**, on [`super::socket::PAD`]
    /// rather than `configd`'s socket. That is not a lapse in the split above: the three calls
    /// before it are Bluetooth *configuration*, and this is the input device — which only the
    /// process already reading it can name, since it is the node gilrs picked.
    ///
    /// It exists for one question the rest of the system cannot answer. `padd` polls the last
    /// known stick value and keeps sending it at 50 Hz, so a radio that stops delivering reports
    /// still produces fresh intents: `robotd` sees a live driver, the deadman never fires, and the
    /// robot walks on a stale command. Nothing in `robot.state` can show that. The raw event
    /// stream can, because a report that never arrived leaves a measurable hole in the cadence.
    pub const PAD_INPUT: &str = "pad.input";

    /// One report from the pad, pushed after [`PAD_INPUT`].
    pub const PAD_REPORT: &str = "pad.report";

    // ── tof.* ────────────────────────────────────────────────────────────────
    /// Subscribe to the head ToF sensor's depth frames, on [`super::socket::TOF`].
    ///
    /// **The one method in this namespace, and `tofd` answers it itself.** Like
    /// the pad tap, this is a sensor stream on the socket of the daemon that owns
    /// the sensor — `robotd` is not in the path, because nothing in the control
    /// loop reads depth and putting perception in front of it would be the
    /// coupling `architecture.md` §1 splits `mediad` off to avoid.
    ///
    /// The answer describes the sensor (or says why there is none); frames then
    /// arrive as [`TOF_FRAME`] notifications until the connection closes.
    pub const TOF_STREAM: &str = "tof.stream";

    /// `btd` → `robotd`: subscribe to what to put on the air. Answered, then `robotd` streams
    /// [`CHORALE_BEACON`] notifications for as long as the connection lasts.
    ///
    /// The radio is `btd`'s and the behaviour is `robotd`'s, so neither can do this alone. This is
    /// the direction that needs a subscription rather than a call: `robotd` decides *when* the
    /// beacon changes, and it changes on the beat.
    pub const CHORALE_SUBSCRIBE: &str = "chorale.subscribe";
    /// `robotd` → `btd`: advertise this, or stop. A notification on a [`CHORALE_SUBSCRIBE`]
    /// stream; the params are [`super::ChoraleAdvertise`].
    pub const CHORALE_BEACON: &str = "chorale.beacon";
    /// `btd` → `robotd`: another duck's beacon was heard. A notification — the params are
    /// [`super::ChoraleHeard`].
    pub const CHORALE_HEARD: &str = "chorale.heard";

    /// One 8×8 depth frame, pushed after [`TOF_STREAM`].
    pub const TOF_FRAME: &str = "tof.frame";

    /// Subscribe to the head IMU (BMI088 on the HAT, same I²C bus as the ToF). The answer
    /// describes the sensor, then [`HEAD_IMU_FRAME`] notifications arrive until the connection closes.
    pub const HEAD_IMU_STREAM: &str = "head_imu.stream";

    /// One head-IMU sample, pushed after [`HEAD_IMU_STREAM`].
    pub const HEAD_IMU_FRAME: &str = "head_imu.frame";
}

/// JSON-RPC error codes.
///
/// -32768..-32000 is spec-reserved; application errors use a private range. The
/// distinctions let a client act: retry on [`BUSY`], report "correctly refused" rather
/// than "something broke".
pub mod code {
    // Spec-reserved.
    pub const PARSE_ERROR: i32 = -32700;
    pub const INVALID_REQUEST: i32 = -32600;
    pub const METHOD_NOT_FOUND: i32 = -32601;
    pub const INVALID_PARAMS: i32 = -32602;
    pub const INTERNAL_ERROR: i32 = -32603;

    // Application-specific.
    pub const BUSY: i32 = 1;
    pub const UNKNOWN_COMPONENT: i32 = 2;
    /// Retired: nothing emits this any more. A version *difference* is logged and served, and
    /// what refuses is the route that is genuinely missing — see [`super::API_VERSION`].
    ///
    /// The constant stays, and the number is not reused, because a board running an `updaterd`
    /// from 0.5.1 or earlier still answers `hello` with it and `robotctl` still maps it to an
    /// exit status. Deleting it would make that board's refusal read as a generic failure.
    pub const PROTOCOL_MISMATCH: i32 = 3;
    pub const PREFLIGHT_FAILED: i32 = 4;
    pub const NETWORK: i32 = 5;
    pub const VERIFICATION_FAILED: i32 = 6;
    pub const INCOMPATIBLE: i32 = 7;
    pub const HOOK_FAILED: i32 = 8;
    pub const HEALTH_CHECK_FAILED: i32 = 9;
    /// Update failed *and* rollback failed. Distinct so support sees the most serious
    /// outcome immediately.
    pub const ROLLBACK_FAILED: i32 = 10;
    /// The component exists but that version is not installed — as opposed to
    /// [`UNKNOWN_COMPONENT`], "no such robot part".
    pub const NOT_INSTALLED: i32 = 11;
    /// A newer version is installed and the request would move backwards.
    pub const WOULD_DOWNGRADE: i32 = 12;
    /// Verified, but larger than the configured archive limits allow.
    pub const ARCHIVE_TOO_LARGE: i32 = 13;
    /// The caller may connect but may not perform this operation — "ask an
    /// administrator", not "something broke".
    pub const PERMISSION_DENIED: i32 = 14;
}

/// Request identifier. `None` on a [`Request`] makes it a notification.
#[derive(Debug, Clone, PartialEq, Eq, Serialize, Deserialize)]
#[serde(untagged)]
pub enum Id {
    Number(u64),
    Text(String),
}

// ── calls ────────────────────────────────────────────────────────────────────

/// A method together with its parameters.
///
/// Every request is built from one of these and read back as one, so a method can never be
/// paired with another method's parameters — the drift this crate exists to prevent.
#[derive(Debug, Clone, PartialEq)]
pub enum Call {
    /// Version handshake. The first call on a connection.
    Hello(HelloParams),

    // ── update.* ─────────────────────────────────────────────────────────────
    Check(ComponentParams),
    Apply(ApplyParams),
    Rollback(ComponentParams),
    ResetToGolden(ComponentParams),
    Select(SelectParams),
    Pin(PinParams),
    Status,
    ListInstalled(ComponentParams),
    Log(LogParams),
    /// One run's full transcript. `update.log` says which runs exist; this says what one did.
    Show(ShowParams),
    /// Turns the connection into a stream of [`method::PROGRESS`] notifications.
    Subscribe,

    // ── robot.* ──────────────────────────────────────────────────────────────
    RobotSafeToRestart,
    RobotHealth,
    RobotModelApi,
    RobotRemoteSessionActive,

    // ── intents ──────────────────────────────────────────────────────────────
    /// Continuous. Send as a notification.
    RobotMove(MoveParams),
    /// Continuous. Send as a notification.
    RobotHead(HeadParams),
    /// Discrete. Send as a request; the answer is [`LookResult`].
    RobotLook(LookParams),
    RobotStop,
    RobotEnable(EnableParams),
    /// Power the joints and ramp to the home pose. No policy needed.
    RobotInit,
    /// Cut power to the joints. The robot collapses if nothing holds it.
    RobotRelax,
    /// Reboot servos (all of them, or the ids named), then limp. See [`method::ROBOT_REBOOT_MOTORS`].
    RobotRebootMotors(RebootMotorsParams),
    /// Run a one-shot skill, or toggle sit↔stand.
    RobotDo(DoParams),
    /// Standing body pose. Continuous. Send as a notification.
    RobotPose(PoseParams),
    /// Mouth opening. Continuous. Send as a notification.
    RobotMouth(MouthParams),
    /// Play a voice-bank sound.
    RobotSound(SoundParams),
    /// Toggle the bobo voice call. See [`method::ROBOT_VOICE`].
    RobotVoice,
    /// Pick the ToF theremin up or put it down. Discrete; the answer is [`ThereminResult`].
    RobotTheremin(ThereminParams),
    /// Start or stop looking for other ducks to sing with. Discrete; the answer is
    /// [`ChoraleResult`].
    RobotChorale(ChoraleParams),
    /// `btd` subscribing to what it should advertise. Answered, then a stream of
    /// [`method::CHORALE_BEACON`] notifications.
    ChoraleSubscribe,
    /// `robotd` telling `btd` what to advertise. A notification.
    ChoraleBeaconSet(ChoraleAdvertise),
    /// `btd` telling `robotd` what it heard. A notification.
    ChoraleHeard(ChoraleHeard),
    /// Sit down, then power the machine off.
    RobotShutdown,
    /// Which drive mode this robotd runs: walk or roller.
    RobotMode,
    /// Switch drive mode; see [`method::ROBOT_SET_MODE`].
    RobotSetMode(SetModeParams),
    /// What each policy slot runs; see [`method::ROBOT_POLICIES`].
    RobotPolicies,
    /// Static robot geometry for a mapper; see [`method::ROBOT_MODEL`].
    RobotModel,
    /// Load one slot, or reset it; see [`method::ROBOT_LOAD_POLICY`].
    RobotLoadPolicy(LoadPolicyParams),
    /// Re-read every slot from disk; see [`method::ROBOT_RELOAD_POLICIES`].
    RobotReloadPolicies,

    // ── policy.* ─────────────────────────────────────────────────────────────
    /// What is installed and what the Hub offers; see [`method::POLICY_CHECK`].
    PolicyCheck,
    /// Install a set and make it live; see [`method::POLICY_INSTALL`].
    PolicyInstall(PolicyInstallParams),
    /// Fetch one policy into the library; see [`method::POLICY_FETCH`].
    PolicyFetch(PolicyFetchParams),
    /// Search the Hub; see [`method::POLICY_SEARCH`].
    PolicySearch(PolicySearchParams),

    // ── detector.* ───────────────────────────────────────────────────────────
    /// What detector is installed and what the Hub offers; see [`method::DETECTOR_CHECK`].
    DetectorCheck,
    /// Install a detector and restart `mediad` onto it; see [`method::DETECTOR_INSTALL`].
    DetectorInstall(PolicyInstallParams),

    // ── account.* ────────────────────────────────────────────────────────────
    /// Start a device-code login; see [`method::ACCOUNT_LOGIN`].
    AccountLogin(AccountLoginParams),
    /// Who this robot belongs to; see [`method::ACCOUNT_STATUS`].
    AccountStatus,
    /// Forget the account; see [`method::ACCOUNT_LOGOUT`].
    AccountLogout,
    RobotSubscribe(SubscribeParams),
    // ── net.* ────────────────────────────────────────────────────────────────
    NetStatus,
    NetScan,
    NetConnect(NetConnectParams),
    NetForget(NetForgetParams),

    // ── system.* ─────────────────────────────────────────────────────────────
    SystemInfo,
    SystemServices,
    /// The tail of one unit's journal; see [`method::SYSTEM_LOGS`].
    SystemLogs(LogsParams),
    SystemSetName(SetNameParams),
    SystemReboot,
    /// Read the pairing PIN.
    ///
    /// Exists so `btd` can answer a BLE passkey request without owning config. It must never be
    /// routed to BLE — a PIN an unpaired peer can read authorises nothing — and `btd`'s routing
    /// table has a test saying so.
    SystemPairingPin,
    SystemSetPairingPin(SetPairingPinParams),
    /// Prove knowledge of the robot's pairing PIN.
    ///
    /// Answered by the **transport** rather than by any service, which makes it unlike every
    /// other call here. BLE cannot express a fixed, printed-on-the-robot passkey — the spec has
    /// the *displaying* side generate a random one, and a headless robot can display nothing — so
    /// the PIN check moved from the link layer to this one, where we define the rules. See
    /// `docs/design/app-path-design.md` §5.
    SystemAuthenticate(AuthenticateParams),

    // ── pad.* ────────────────────────────────────────────────────────────────
    PadStatus,
    PadPair(PadPairParams),
    PadForget(PadForgetParams),
    PadBindings,
    PadBind(PadBindParams),
    RobotSkills,
    RobotSetSkill(SkillParams),
    RobotRemoveSkill(SkillNameParams),
    /// Subscribe to the raw pad input stream. Answered by `padd`, not `configd`.
    PadInput,
    /// Subscribe to the ToF depth stream. Answered by `tofd`.
    TofStream,
    /// Subscribe to the head IMU (BMI088 on the HAT); see [`method::HEAD_IMU_STREAM`].
    HeadImuStream,
}

/// The service that owns the answer to a call.
///
/// One socket per service, connected directly — there is no broker (`architecture.md` §2.2). A
/// transport adapter holds connections to the services whose calls it carries, and to no others:
/// `btd` holds three, and `padd` being absent from them is deliberate rather than incidental —
/// `padd` is the unprivileged client whose whole value is having no special access.
#[derive(Debug, Clone, Copy, PartialEq, Eq, Hash)]
pub enum Service {
    /// `updaterd`, at [`DEFAULT_SOCKET`].
    Updater,
    /// `robotd` — the control loop.
    Robot,
    /// `configd` — wifi, identity, the pairing PIN, gamepad bonding.
    Config,
    /// `padd` — the raw gamepad input stream.
    Pad,
    /// `tofd` — the depth stream.
    Tof,
}

/// How long answering a call holds a connection, and therefore which connection carries it.
///
/// **Every service here serves one connection one request at a time.** So a single connection per
/// service would put every call on one queue behind the slowest thing on it, and two orderings a
/// client reaches for first are broken by that:
///
/// - `update.apply` then `update.status` — the status line waits in a socket `updaterd` will not
///   read for minutes, so the client times out having heard nothing while the robot is fine.
/// - `update.subscribe` then `update.apply` — worse. The subscription owns its connection until
///   the peer goes away and never reads another request, so the apply is written into a socket
///   nobody reads: it never runs, never replies and never errors. An update the owner asked for
///   that the robot silently did not perform.
///
/// Grouping by *how long a call holds a connection* and giving each group its own is what fixes
/// both. It is at most four sockets per service per session, which costs nothing and is bounded
/// without bookkeeping — the alternative, a connection per call, needs the adapter to know when a
/// call ended, which needs it to parse replies. It deliberately never does.
#[derive(Debug, Clone, Copy, PartialEq, Eq, Hash)]
pub enum Lane {
    /// Answers as fast as the daemon can look something up.
    Prompt,
    /// Seconds: a read that goes to the network or sweeps a radio.
    Slow,
    /// As long as it takes, and it changes the robot: an update, joining a network, bonding a pad.
    Operation,
    /// Never answers. The service writes notifications until the peer goes away.
    Stream,
}

impl Call {
    /// The wire method name.
    pub fn method(&self) -> &'static str {
        match self {
            Call::Hello(_) => method::HELLO,
            Call::Check(_) => method::CHECK,
            Call::Apply(_) => method::APPLY,
            Call::Rollback(_) => method::ROLLBACK,
            Call::ResetToGolden(_) => method::RESET_TO_GOLDEN,
            Call::Select(_) => method::SELECT,
            Call::Pin(_) => method::PIN,
            Call::Status => method::STATUS,
            Call::ListInstalled(_) => method::LIST_INSTALLED,
            Call::Log(_) => method::LOG,
            Call::Show(_) => method::SHOW,
            Call::Subscribe => method::SUBSCRIBE,
            Call::RobotSafeToRestart => method::ROBOT_SAFE_TO_RESTART,
            Call::RobotHealth => method::ROBOT_HEALTH,
            Call::RobotModelApi => method::ROBOT_MODEL_API,
            Call::RobotRemoteSessionActive => method::ROBOT_SESSION_ACTIVE,
            Call::RobotMove(_) => method::ROBOT_MOVE,
            Call::RobotHead(_) => method::ROBOT_HEAD,
            Call::RobotLook(_) => method::ROBOT_LOOK,
            Call::RobotStop => method::ROBOT_STOP,
            Call::RobotEnable(_) => method::ROBOT_ENABLE,
            Call::RobotInit => method::ROBOT_INIT,
            Call::RobotRelax => method::ROBOT_RELAX,
            Call::RobotRebootMotors(_) => method::ROBOT_REBOOT_MOTORS,
            Call::RobotDo(_) => method::ROBOT_DO,
            Call::RobotPose(_) => method::ROBOT_POSE,
            Call::RobotMouth(_) => method::ROBOT_MOUTH,
            Call::RobotSound(_) => method::ROBOT_SOUND,
            Call::RobotVoice => method::ROBOT_VOICE,
            Call::RobotTheremin(_) => method::ROBOT_THEREMIN,
            Call::RobotChorale(_) => method::ROBOT_CHORALE,
            Call::ChoraleSubscribe => method::CHORALE_SUBSCRIBE,
            Call::ChoraleBeaconSet(_) => method::CHORALE_BEACON,
            Call::ChoraleHeard(_) => method::CHORALE_HEARD,
            Call::RobotShutdown => method::ROBOT_SHUTDOWN,
            Call::RobotMode => method::ROBOT_MODE,
            Call::RobotSetMode(_) => method::ROBOT_SET_MODE,
            Call::RobotPolicies => method::ROBOT_POLICIES,
            Call::RobotModel => method::ROBOT_MODEL,
            Call::RobotLoadPolicy(_) => method::ROBOT_LOAD_POLICY,
            Call::RobotReloadPolicies => method::ROBOT_RELOAD_POLICIES,
            Call::PolicyCheck => method::POLICY_CHECK,
            Call::PolicyInstall(_) => method::POLICY_INSTALL,
            Call::PolicyFetch(_) => method::POLICY_FETCH,
            Call::PolicySearch(_) => method::POLICY_SEARCH,
            Call::DetectorCheck => method::DETECTOR_CHECK,
            Call::DetectorInstall(_) => method::DETECTOR_INSTALL,
            Call::AccountLogin(_) => method::ACCOUNT_LOGIN,
            Call::AccountStatus => method::ACCOUNT_STATUS,
            Call::AccountLogout => method::ACCOUNT_LOGOUT,
            Call::RobotSubscribe(_) => method::ROBOT_SUBSCRIBE,
            Call::NetStatus => method::NET_STATUS,
            Call::NetScan => method::NET_SCAN,
            Call::NetConnect(_) => method::NET_CONNECT,
            Call::NetForget(_) => method::NET_FORGET,
            Call::SystemInfo => method::SYSTEM_INFO,
            Call::SystemServices => method::SYSTEM_SERVICES,
            Call::SystemLogs(_) => method::SYSTEM_LOGS,
            Call::SystemSetName(_) => method::SYSTEM_SET_NAME,
            Call::SystemReboot => method::SYSTEM_REBOOT,
            Call::SystemPairingPin => method::SYSTEM_PAIRING_PIN,
            Call::SystemSetPairingPin(_) => method::SYSTEM_SET_PAIRING_PIN,
            Call::SystemAuthenticate(_) => method::SYSTEM_AUTHENTICATE,
            Call::PadStatus => method::PAD_STATUS,
            Call::PadPair(_) => method::PAD_PAIR,
            Call::PadForget(_) => method::PAD_FORGET,
            Call::PadBindings => method::PAD_BINDINGS,
            Call::PadBind(_) => method::PAD_BIND,
            Call::RobotSkills => method::ROBOT_SKILLS,
            Call::RobotSetSkill(_) => method::ROBOT_SET_SKILL,
            Call::RobotRemoveSkill(_) => method::ROBOT_REMOVE_SKILL,
            Call::PadInput => method::PAD_INPUT,
            Call::TofStream => method::TOF_STREAM,
            Call::HeadImuStream => method::HEAD_IMU_STREAM,
        }
    }

    /// Does this change the robot's software?
    ///
    /// `updaterd` authorises exactly these against the caller's uid/gid; read-only calls
    /// are ungated, so support can inspect a robot it is not allowed to change.
    pub fn is_mutating(&self) -> bool {
        matches!(
            self,
            Call::Apply(_)
                | Call::Rollback(_)
                | Call::ResetToGolden(_)
                | Call::Select(_)
                | Call::Pin(_)
                // Changing the robot's *configuration* is mutating too. Joining a network is
                // not a read, and a reboot is the most disruptive thing a client can ask for.
                | Call::NetConnect(_)
                | Call::NetForget(_)
                | Call::SystemSetName(_)
                | Call::SystemReboot
                | Call::SystemSetPairingPin(_)
                // Powering the machine off is at least as disruptive as rebooting it.
                | Call::RobotShutdown
                // Bonding a pad to this robot changes what may drive it, which is the most
                // consequential thing in this namespace — a paired pad can enable the policy.
                // `pad.status` is a read and stays ungated.
                | Call::PadPair(_)
                | Call::PadForget(_)
                // Replacing the policy set changes what drives fifteen servos, which is at least
                // as consequential as bonding a pad. `policy.check` is a read and stays ungated,
                // like `pad.status` and every other question about what a robot is.
                | Call::PolicyInstall(_)
                // Putting a stranger's network on the board is at least as consequential as
                // replacing the official set. `policy.search` and `policy.fetch`'s read-only
                // cousins stay ungated — asking what exists changes nothing.
                | Call::PolicyFetch(_)
                // Replacing the detector writes to the eMMC and restarts `mediad`, which drops
                // every video session. `detector.check` is a read and stays ungated.
                | Call::DetectorInstall(_)
                // Signing the robot in binds it to a Hugging Face account, and signing it out
                // takes it away again. That is the most consequential pair here by one measure
                // nothing else in this list shares: it decides who can reach the robot *from
                // outside the building*, and it outlives every session and every reboot.
                // `account.status` is a read and stays ungated — a support engineer should be
                // able to ask which account a robot thinks it belongs to.
                | Call::AccountLogin(_)
                | Call::AccountLogout
        )
    }

    /// The service that owns the answer to this call, and how long answering it holds a
    /// connection. `None` for a call no service answers.
    ///
    /// **This is a property of the call, not of a transport.** Who owns `net.connect` does not
    /// change depending on whether a phone asked over Bluetooth or a browser asked over a
    /// datachannel, and neither does the fact that `configd` will sit on the connection for the
    /// better part of a minute while it waits for NetworkManager. Whether a given transport may
    /// *make* the call is the separate question, and it stays with the transport — see
    /// `btd::route` for the one that exists, and `docs/design/remote-webrtc.md` §5 for why the two
    /// were split.
    ///
    /// It lives here, beside [`Call::mutates`], because it is the same kind of fact: something
    /// every adapter needs and none should decide for itself.
    pub fn destination(&self) -> Option<(Service, Lane)> {
        use Lane::*;
        use Service::*;
        Some(match self {
            // The version handshake. `updaterd` answers it because it is the service on the
            // recovery path — the one that must reply when the rest of the robot does not.
            Call::Hello(_) => (Updater, Prompt),

            // ── updaterd ────────────────────────────────────────────────────
            //
            // `Apply`, `Rollback` and `ResetToGolden` all move `current`, and `updaterd`
            // single-flights mutations behind a file lock and answers `BUSY` for a second one —
            // so sharing one lane is the behaviour to have rather than a compromise.
            Call::Apply(_) | Call::Rollback(_) | Call::Select(_) | Call::ResetToGolden(_) => {
                (Updater, Operation)
            }
            // Reaches the network to ask a mirror what exists, so seconds. Deliberately off
            // `Operation`: "is there an update?" asked during one has an immediate answer
            // (`BUSY`), and queueing it behind the update would turn that into a spinner that
            // resolves minutes later.
            Call::Check(_) => (Updater, Slow),
            // `update.status` falls back to a cached snapshot rather than waiting for the engine,
            // so it answers during an apply — which is wasted if the request is queued behind one.
            Call::Status => (Updater, Prompt),
            Call::Pin(_) | Call::Log(_) | Call::ListInstalled(_) => (Updater, Prompt),
            // Reads a file, like `log`. Bounded by the per-run caps `updater::transcript`
            // enforces at write time, so the answer cannot grow without limit however long
            // a hook talked for.
            Call::Show(_) => (Updater, Prompt),
            // `check` is one HTTP round trip. `install` downloads a policy set and then asks
            // `robotd` to reload, which is the same order of magnitude as a small update — long,
            // but bounded and not a stream.
            Call::PolicyCheck | Call::PolicyInstall(_) => (Updater, Prompt),
            // The same two, for the detector: one round trip, or a fourteen-megabyte download
            // and a `mediad` restart.
            Call::DetectorCheck | Call::DetectorInstall(_) => (Updater, Prompt),
            // `fetch` downloads one file and `search` is a single query; both are bounded and
            // neither streams.
            Call::PolicyFetch(_) | Call::PolicySearch(_) => (Updater, Prompt),
            // `login` is one HTTP round trip to Hugging Face and answers with the code to
            // show somebody; the *waiting* happens in a task `updaterd` owns, not on this
            // connection, so it is `Slow` for the round trip rather than `Stream` for the login.
            // That is the whole reason `login` returns a code instead of a token: a client that
            // backgrounds itself while its user reads the code — which is what a phone does when
            // it opens a browser — must be able to come back and ask `status`.
            Call::AccountLogin(_) => (Updater, Slow),
            // Both read or write local state only. `status` is asked on a poll while a login is
            // in flight, so it must not queue behind anything.
            Call::AccountStatus | Call::AccountLogout => (Updater, Prompt),
            // Owns its connection until the peer goes away and never reads another request.
            Call::Subscribe => (Updater, Stream),

            // ── robotd ──────────────────────────────────────────────────────
            Call::RobotSafeToRestart
            | Call::RobotHealth
            | Call::RobotModelApi
            | Call::RobotRemoteSessionActive
            | Call::RobotPolicies
            | Call::RobotModel
            | Call::RobotMode => (Robot, Prompt),
            // Intents and one-shot skills. All fast: they store a value the control loop reads on
            // its next tick, and none of them waits for the robot to finish anything.
            Call::RobotMove(_)
            | Call::RobotHead(_)
            | Call::RobotLook(_)
            | Call::RobotStop
            | Call::RobotEnable(_)
            | Call::RobotInit
            | Call::RobotRelax
            | Call::RobotRebootMotors(_)
            | Call::RobotDo(_)
            | Call::RobotPose(_)
            | Call::RobotMouth(_)
            | Call::RobotSound(_)
            | Call::RobotVoice
            | Call::RobotTheremin(_)
            | Call::RobotChorale(_)
            | Call::RobotSetMode(_)
            | Call::RobotLoadPolicy(_)
            | Call::RobotReloadPolicies
            | Call::RobotShutdown => (Robot, Prompt),
            Call::RobotSubscribe(_) => (Robot, Stream),
            // `btd` asking what to put on the air. The answering connection carries the beacon
            // stream down and `chorale.heard` notifications up.
            Call::ChoraleSubscribe => (Robot, Stream),

            // ── configd ─────────────────────────────────────────────────────
            Call::NetStatus
            | Call::NetForget(_)
            | Call::SystemInfo
            | Call::SystemServices
            | Call::SystemLogs(_)
            | Call::SystemSetName(_)
            | Call::SystemReboot
            | Call::SystemPairingPin
            | Call::SystemSetPairingPin(_)
            | Call::PadStatus
            | Call::PadForget(_) => (Config, Prompt),

            // **The one place `pad.*` splits across two daemons.** Pairing is about the radio,
            // which `configd` owns. A binding is about what a button does to the robot, and
            // answering it needs two things only `robotd` has: the list of skills this robot
            // actually has, so a name can be refused rather than becoming a dead button, and the
            // config path it is already parsing. Its true sibling is `robot.loadPolicy`, not
            // `pad.pair`.
            //
            // Routing is per method throughout this table — `policy.*` goes to `updaterd` while
            // `robot.loadPolicy` goes to `robotd`, for the same concept — so this costs nothing
            // mechanically. It is only worth a comment because the name suggests otherwise.
            Call::PadBindings | Call::PadBind(_) => (Robot, Prompt),

            // The skill table. `robotd` writes it and reloads itself afterwards, so one call is
            // enough — and it is the daemon that has to accept the result either way.
            Call::RobotSkills | Call::RobotSetSkill(_) | Call::RobotRemoveSkill(_) => (Robot, Slow),
            // Re-sweeps the radio rather than returning the last scan.
            Call::NetScan => (Config, Slow),
            // `configd` polls NetworkManager for up to 45 seconds before calling a join failed,
            // and `pad.pair` waits on a gamepad for its whole timeout. Both hold the connection
            // for that long, which is what `Operation` is for — and why `net.status` must not be
            // queued behind them.
            Call::NetConnect(_) | Call::PadPair(_) => (Config, Operation),

            // ── padd and tofd ───────────────────────────────────────────────
            //
            // Both are streams, and both are named here even though the only transport that
            // exists today reaches neither: what a call *is* does not depend on who may ask it.
            Call::PadInput => (Pad, Stream),
            Call::TofStream => (Tof, Stream),
            Call::HeadImuStream => (Tof, Stream),

            // ── answered by no service ──────────────────────────────────────
            //
            // The PIN check belongs to the transport, which is the whole point of it: BLE cannot
            // express a fixed passkey printed on a robot, so the check moved up a layer to where
            // we define the rules (`docs/design/app-path-design.md` §5). A transport that does not
            // gate anything simply never sees this call.
            Call::SystemAuthenticate(_) => return None,
            // These two never dial a service: they travel inside the connection that
            // `chorale.subscribe` opened — the beacon stream down, what the radio heard up.
            Call::ChoraleBeaconSet(_) | Call::ChoraleHeard(_) => return None,
        })
    }

    /// The component this call is about, where it names one.
    pub fn component(&self) -> Option<&ComponentId> {
        match self {
            Call::Check(p)
            | Call::Rollback(p)
            | Call::ResetToGolden(p)
            | Call::ListInstalled(p) => Some(&p.component),
            Call::Apply(p) => Some(&p.component),
            Call::Select(p) => Some(&p.component),
            Call::Pin(p) => Some(&p.component),
            _ => None,
        }
    }

    /// Parameters as they go on the wire. Methods that take none send `{}`, so every
    /// request has the same shape.
    fn params(&self) -> Value {
        fn encode(params: &impl Serialize) -> Value {
            // Plain structs of strings, bools, ints and versions: this cannot fail.
            serde_json::to_value(params).unwrap_or(Value::Null)
        }
        match self {
            Call::Hello(p) => encode(p),
            Call::Check(p)
            | Call::Rollback(p)
            | Call::ResetToGolden(p)
            | Call::ListInstalled(p) => encode(p),
            Call::Apply(p) => encode(p),
            Call::Select(p) => encode(p),
            Call::Pin(p) => encode(p),
            Call::Log(p) => encode(p),
            Call::Show(p) => encode(p),
            Call::RobotMove(p) => encode(p),
            Call::RobotHead(p) => encode(p),
            Call::RobotLook(p) => encode(p),
            Call::RobotEnable(p) => encode(p),
            Call::RobotDo(p) => encode(p),
            Call::RobotRebootMotors(p) => encode(p),
            Call::RobotPose(p) => encode(p),
            Call::RobotMouth(p) => encode(p),
            Call::RobotSetMode(p) => encode(p),
            Call::RobotLoadPolicy(p) => encode(p),
            Call::PolicyInstall(p) => encode(p),
            Call::DetectorInstall(p) => encode(p),
            Call::PolicyFetch(p) => encode(p),
            Call::PolicySearch(p) => encode(p),
            Call::AccountLogin(p) => encode(p),
            Call::RobotSound(p) => encode(p),
            Call::RobotTheremin(p) => encode(p),
            Call::RobotChorale(p) => encode(p),
            Call::ChoraleBeaconSet(p) => encode(p),
            Call::ChoraleHeard(p) => encode(p),
            Call::RobotSubscribe(p) => encode(p),
            Call::NetConnect(p) => encode(p),
            Call::NetForget(p) => encode(p),
            Call::SystemLogs(p) => encode(p),
            Call::SystemSetName(p) => encode(p),
            Call::SystemSetPairingPin(p) => encode(p),
            Call::SystemAuthenticate(p) => encode(p),
            Call::PadPair(p) => encode(p),
            Call::PadForget(p) => encode(p),
            Call::PadBind(p) => encode(p),
            Call::RobotSetSkill(p) => encode(p),
            Call::RobotRemoveSkill(p) => encode(p),
            Call::Status
            | Call::Subscribe
            | Call::RobotSafeToRestart
            | Call::RobotHealth
            | Call::RobotModelApi
            | Call::RobotRemoteSessionActive
            | Call::RobotStop
            | Call::RobotInit
            | Call::RobotRelax
            | Call::RobotVoice
            | Call::RobotShutdown
            | Call::RobotPolicies
            | Call::RobotModel
            | Call::RobotReloadPolicies
            | Call::PolicyCheck
            | Call::DetectorCheck
            | Call::AccountStatus
            | Call::AccountLogout
            | Call::RobotMode => Value::Object(serde_json::Map::new()),
            Call::NetStatus
            | Call::NetScan
            | Call::SystemInfo
            | Call::SystemServices
            | Call::SystemReboot
            | Call::SystemPairingPin
            | Call::PadStatus
            | Call::PadBindings
            | Call::RobotSkills
            | Call::PadInput
            | Call::TofStream
            | Call::HeadImuStream
            | Call::ChoraleSubscribe => Value::Object(serde_json::Map::new()),
        }
    }

    /// Decode a method name and parameters as they arrived.
    ///
    /// The two failures stay apart because a caller acts on them differently: an unknown
    /// method is [`code::METHOD_NOT_FOUND`], parameters that do not fit are
    /// [`code::INVALID_PARAMS`]. Methods taking no parameters ignore whatever arrived.
    fn parse(method_name: &str, params: Option<&Value>) -> Result<Self, Error> {
        fn decode<T: for<'de> Deserialize<'de>>(params: Option<&Value>) -> Result<T, Error> {
            serde_json::from_value(params.cloned().unwrap_or(Value::Null))
                .map_err(|e| Error::new(code::INVALID_PARAMS, e.to_string()))
        }

        Ok(match method_name {
            method::HELLO => Call::Hello(decode(params)?),
            method::CHECK => Call::Check(decode(params)?),
            method::APPLY => Call::Apply(decode(params)?),
            method::ROLLBACK => Call::Rollback(decode(params)?),
            method::RESET_TO_GOLDEN => Call::ResetToGolden(decode(params)?),
            method::SELECT => Call::Select(decode(params)?),
            method::PIN => Call::Pin(decode(params)?),
            method::STATUS => Call::Status,
            method::LIST_INSTALLED => Call::ListInstalled(decode(params)?),
            method::LOG => Call::Log(decode(params)?),
            method::SHOW => Call::Show(decode(params)?),
            method::SUBSCRIBE => Call::Subscribe,
            method::ROBOT_SAFE_TO_RESTART => Call::RobotSafeToRestart,
            method::ROBOT_HEALTH => Call::RobotHealth,
            method::ROBOT_MODEL_API => Call::RobotModelApi,
            method::ROBOT_SESSION_ACTIVE => Call::RobotRemoteSessionActive,
            method::ROBOT_MOVE => Call::RobotMove(decode(params)?),
            method::ROBOT_HEAD => Call::RobotHead(decode(params)?),
            method::ROBOT_LOOK => Call::RobotLook(decode(params)?),
            method::ROBOT_STOP => Call::RobotStop,
            method::ROBOT_ENABLE => Call::RobotEnable(decode(params)?),
            method::ROBOT_INIT => Call::RobotInit,
            method::ROBOT_RELAX => Call::RobotRelax,
            method::ROBOT_REBOOT_MOTORS => Call::RobotRebootMotors(decode(params)?),
            method::ROBOT_DO => Call::RobotDo(decode(params)?),
            method::ROBOT_POSE => Call::RobotPose(decode(params)?),
            method::ROBOT_MOUTH => Call::RobotMouth(decode(params)?),
            method::ROBOT_SOUND => Call::RobotSound(decode(params)?),
            method::ROBOT_VOICE => Call::RobotVoice,
            method::ROBOT_THEREMIN => Call::RobotTheremin(decode(params)?),
            method::ROBOT_CHORALE => Call::RobotChorale(decode(params)?),
            method::CHORALE_SUBSCRIBE => Call::ChoraleSubscribe,
            method::CHORALE_BEACON => Call::ChoraleBeaconSet(decode(params)?),
            method::CHORALE_HEARD => Call::ChoraleHeard(decode(params)?),
            method::ROBOT_SHUTDOWN => Call::RobotShutdown,
            method::ROBOT_MODE => Call::RobotMode,
            method::ROBOT_SET_MODE => Call::RobotSetMode(decode(params)?),
            method::ROBOT_POLICIES => Call::RobotPolicies,
            method::ROBOT_MODEL => Call::RobotModel,
            method::ROBOT_LOAD_POLICY => Call::RobotLoadPolicy(decode(params)?),
            method::ROBOT_RELOAD_POLICIES => Call::RobotReloadPolicies,
            method::POLICY_CHECK => Call::PolicyCheck,
            method::POLICY_INSTALL => Call::PolicyInstall(decode(params)?),
            method::POLICY_FETCH => Call::PolicyFetch(decode(params)?),
            method::POLICY_SEARCH => Call::PolicySearch(decode(params)?),
            method::DETECTOR_CHECK => Call::DetectorCheck,
            method::DETECTOR_INSTALL => Call::DetectorInstall(decode(params)?),
            method::ACCOUNT_LOGIN => Call::AccountLogin(decode(params)?),
            method::ACCOUNT_STATUS => Call::AccountStatus,
            method::ACCOUNT_LOGOUT => Call::AccountLogout,
            method::ROBOT_SUBSCRIBE => Call::RobotSubscribe(decode(params)?),
            method::NET_STATUS => Call::NetStatus,
            method::NET_SCAN => Call::NetScan,
            method::NET_CONNECT => Call::NetConnect(decode(params)?),
            method::NET_FORGET => Call::NetForget(decode(params)?),
            method::SYSTEM_INFO => Call::SystemInfo,
            method::SYSTEM_SERVICES => Call::SystemServices,
            method::SYSTEM_LOGS => Call::SystemLogs(decode(params)?),
            method::SYSTEM_SET_NAME => Call::SystemSetName(decode(params)?),
            method::SYSTEM_REBOOT => Call::SystemReboot,
            method::SYSTEM_PAIRING_PIN => Call::SystemPairingPin,
            method::SYSTEM_SET_PAIRING_PIN => Call::SystemSetPairingPin(decode(params)?),
            method::SYSTEM_AUTHENTICATE => Call::SystemAuthenticate(decode(params)?),
            method::PAD_STATUS => Call::PadStatus,
            // The only method here whose parameters are *all* optional, so an absent `params`
            // member has to mean "defaults" rather than a parse error: `{"method":"pad.pair"}` is
            // the everyday call, and a hand-written client will send exactly that. Every other
            // method either needs its parameters or takes none at all, which is why this is one
            // line here rather than a change to `decode`.
            method::PAD_PAIR => {
                let empty = Value::Object(serde_json::Map::new());
                Call::PadPair(decode(params.or(Some(&empty)))?)
            }
            method::PAD_FORGET => Call::PadForget(decode(params)?),
            method::PAD_BINDINGS => Call::PadBindings,
            method::PAD_BIND => Call::PadBind(decode(params)?),
            method::ROBOT_SKILLS => Call::RobotSkills,
            method::ROBOT_SET_SKILL => Call::RobotSetSkill(decode(params)?),
            method::ROBOT_REMOVE_SKILL => Call::RobotRemoveSkill(decode(params)?),
            method::PAD_INPUT => Call::PadInput,
            method::TOF_STREAM => Call::TofStream,
            method::HEAD_IMU_STREAM => Call::HeadImuStream,
            other => {
                return Err(Error::new(
                    code::METHOD_NOT_FOUND,
                    format!("unknown method {other:?}"),
                ));
            }
        })
    }
}

/// Fixtures for tests, in this crate and in its consumers.
///
/// Behind a feature so nothing here reaches a robot, and it adds no dependencies — this crate is
/// on the recovery path and its dependency list is deliberately three crates long.
///
/// It exists because two copies of [`every_call`] had already appeared, one here and one in
/// `btd::route`, and they had already drifted — 115 lines against 82. A third was about to be
/// written for `mediad`.
// `any(test, ...)` so this crate's own tests reach it without the feature being enabled, which is
// the difference between `cargo test -p duck-ipc-proto` working and not.
#[cfg(any(test, feature = "test-support"))]
pub mod test_support {
    use super::*;

    /// One of every [`Call`] variant, so a test cannot silently skip one.
    ///
    /// The exhaustive matches over [`Call`] — `method`, `destination`, and each transport's
    /// permission table — are what force this list to stay complete: a new variant breaks those
    /// builds, and whoever fixes them arrives here next.
    pub fn every_call() -> Vec<Call> {
        let component = ComponentId::new("daemon");
        let version = semver::Version::new(1, 4, 2);
        vec![
            Call::Hello(HelloParams {
                api_version: API_VERSION,
            }),
            Call::Check(ComponentParams {
                component: component.clone(),
            }),
            Call::Apply(ApplyParams {
                component: component.clone(),
                target: Target::Exact(version.clone()),
                options: ApplyOptions {
                    dry_run: true,
                    interrupt_sessions: false,
                    from_dir: None,
                },
            }),
            Call::Rollback(ComponentParams {
                component: component.clone(),
            }),
            Call::ResetToGolden(ComponentParams {
                component: component.clone(),
            }),
            Call::Select(SelectParams {
                component: component.clone(),
                version: version.clone(),
            }),
            Call::Pin(PinParams {
                component: component.clone(),
                version: Some(version),
            }),
            Call::Status,
            Call::ListInstalled(ComponentParams { component }),
            Call::Log(LogParams { limit: 20 }),
            Call::Show(ShowParams { run: Some(42) }),
            Call::Subscribe,
            Call::RobotSafeToRestart,
            Call::RobotHealth,
            Call::RobotModelApi,
            Call::RobotRemoteSessionActive,
            Call::RobotMove(MoveParams {
                vx: 0.2,
                vy: -0.1,
                vyaw: 0.4,
            }),
            Call::RobotHead(HeadParams {
                neck_pitch: 0.35,
                head_pitch: -0.1,
                head_yaw: 0.2,
                head_roll: 0.0,
            }),
            Call::RobotLook(LookParams {
                x: 1.0,
                y: 0.25,
                z: -0.1,
                neck_pitch: 0.2,
            }),
            Call::RobotStop,
            Call::RobotEnable(EnableParams {
                on: true,
                toggle: false,
            }),
            Call::RobotInit,
            Call::RobotRelax,
            Call::RobotRebootMotors(RebootMotorsParams { ids: vec![3, 11] }),
            Call::RobotDo(DoParams {
                skill: "ground_pick".into(),
            }),
            Call::RobotPose(PoseParams {
                z: -0.01,
                roll: 0.05,
                pitch: -0.1,
                active: true,
            }),
            Call::RobotMouth(MouthParams { open: 0.5 }),
            Call::RobotSound(SoundParams {
                tag: SoundTag::Chirp,
                hold: None,
            }),
            Call::RobotVoice,
            Call::RobotShutdown,
            Call::RobotMode,
            Call::RobotPolicies,
            Call::RobotModel,
            Call::RobotReloadPolicies,
            Call::PolicyCheck,
            Call::PolicyInstall(PolicyInstallParams {
                version: Some("v2".into()),
            }),
            Call::PolicyFetch(PolicyFetchParams {
                repo: "RemiFabre/microduck-flamingo-cycle".into(),
                revision: None,
                file: None,
            }),
            Call::PolicySearch(PolicySearchParams {
                query: "microduck".into(),
            }),
            Call::DetectorCheck,
            Call::DetectorInstall(PolicyInstallParams {
                version: Some("v2".into()),
            }),
            Call::AccountLogin(AccountLoginParams { force: false }),
            Call::AccountStatus,
            Call::AccountLogout,
            Call::RobotLoadPolicy(LoadPolicyParams {
                slot: Some("walk".into()),
                path: Some("/var/lib/robot/policies/bouncy.onnx".into()),
            }),
            Call::RobotSubscribe(SubscribeParams { hz: Some(10) }),
            Call::NetStatus,
            Call::NetScan,
            Call::NetConnect(NetConnectParams {
                ssid: "Pollen Guest".into(),
                psk: Some("hunter2 with spaces".into()),
            }),
            Call::NetForget(NetForgetParams {
                ssid: "Old Network".into(),
            }),
            Call::SystemInfo,
            Call::SystemServices,
            Call::SystemLogs(LogsParams {
                unit: "robotd".into(),
                lines: 40,
                boot: -1,
            }),
            Call::SystemSetName(SetNameParams {
                name: "duck-01".into(),
            }),
            Call::SystemReboot,
            Call::SystemPairingPin,
            Call::SystemSetPairingPin(SetPairingPinParams {
                pin: "042042".into(),
            }),
            Call::SystemAuthenticate(AuthenticateParams {
                pin: "000000".into(),
            }),
            Call::PadStatus,
            Call::PadPair(PadPairParams {
                mac: Some("78:86:2E:BB:13:28".into()),
                timeout_seconds: Some(20),
            }),
            Call::PadForget(PadForgetParams {
                mac: "78:86:2E:BB:13:28".into(),
            }),
            Call::RobotSkills,
            Call::RobotSetSkill(SkillParams::default()),
            Call::RobotRemoveSkill(SkillNameParams {
                name: "polite-bow".into(),
            }),
            Call::PadBindings,
            Call::PadBind(PadBindParams {
                button: "x".into(),
                skill: Some("polite-bow".into()),
            }),
            Call::PadInput,
            Call::TofStream,
            Call::HeadImuStream,
        ]
    }
}

// ── envelopes ────────────────────────────────────────────────────────────────

/// A request or a notification, as it appears on the wire.
///
/// `method` and `params` stay raw here so a server can tell an unknown method from
/// parameters it could not parse. Build one with [`Self::call`] or
/// [`Self::notify_progress`] and read it back with [`Self::as_call`] or
/// [`Self::as_progress`]: those are the typed paths.
#[derive(Debug, Clone, PartialEq, Eq, Serialize, Deserialize)]
pub struct Request {
    pub jsonrpc: String,
    /// Absent on a notification.
    #[serde(default, skip_serializing_if = "Option::is_none")]
    pub id: Option<Id>,
    pub method: String,
    #[serde(default, skip_serializing_if = "Option::is_none")]
    pub params: Option<Value>,
}
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
