AiBoBoMaker/MicroDuck-BoBoRedesign/03-DuckCode/microduck-hd1910/training-console/training/recipe.py

"""Inspect and apply simulation recipes without changing upstream source files."""
import dataclasses
import hashlib
import json
import math
import re
import tempfile
from pathlib import Path

# Servo housings in the frozen Microduck robot_walk.xml, not joint counts.
# The mouth's housing is retained even though it has no walking-policy action.
SERVO_MASS_PROFILE = {
    'key': 'hd1910_23g', 'reference_g': 18.0, 'replacement_g': 23.0,
    'body_counts': {'trunk_base': 2, 'yaw2roll': 1, 'upper_leg_left': 2,
                    'leg': 1, 'neck': 2, 'yaw_roll_motion': 1, 'jaw_soft': 2,
                    'bearing_roll': 1, 'upper_leg_right': 2, 'leg_2': 1},
    'source': '用户2026-10-01确认HD1910单颗23g、XL330单颗18g；15颗含嘴巴。',
    'inertia_method': '增重部件按质量比例缩放原主惯量，重心沿用原值；这是分布近似，非重新辨识。',
}


# Separate identity preserves historical run physics and calibration snapshots.
# 820 g stays replayable. New training uses the 150 g battery on the same bare machine.
MASS_CLOSURE_PROFILES = {
    'hd1910_820g_v1': {
        'key': 'hd1910_820g_v1', 'target_g': 820.0, 'battery_g': 86.0, 'bare_machine_g': 734.0,
        'title': '官方骨架 + HD1910 · 含电池820g',
        'body_additions_g': {'jaw_soft': 3.0, 'trunk_base': 4.75682},
        'source': '用户2026-10-01指定：飞特增重后头部加3g，余量加躯干，整机820g。',
    },
    'hd1910_battery150_v1': {
        'key': 'hd1910_battery150_v1', 'target_g': 884.0, 'battery_g': 150.0, 'bare_machine_g': 734.0,
        'title': '官方骨架 + HD1910 · 电池150g',
        'body_additions_g': {'jaw_soft': 3.0, 'trunk_base': 68.75682},
        # Extra 64 g sits at the official NP-F970 mesh origin in trunk_base.
        # The 820 g residual stays at the original trunk COM.
        'rear_mass_body': 'trunk_base', 'rear_mass_g': 64.0,
        'rear_mass_point_m': [-0.0359693, 0.0, -0.00385049],
        'source': '用户2026-11-03：电池由86g改为150g。裸机734g不变，多出的64g放在官方NP-F970电池安装点，躯干重心因此后移；820g配方的躯干余量仍在原重心。头部原有3g保留。整机884g。',
    },
}
MASS_CLOSURE_PROFILE = MASS_CLOSURE_PROFILES['hd1910_battery150_v1']
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
