AiBoBoMaker/MicroDuck-BoBoRedesign/(commit log)

2026-09-19 Initial commit: MicroDuck BoBoRedesign project structure
    [下巴x1.stl, 前脸x1.stl, 右脚x1.stl, 右脚底板x1.stl, 右腿内测x1.stl, 右躯干.stl, 大腿固定件x2.stl, 大腿根x2.stl]
2026-09-22 Add IMU module PCB design and project documentation
2026-09-24 Add BOM purchasing list, XL330 3D models, and IMU module documentation
    [下巴x1.stl, 前脸x1.stl, 右大腿_白色.stl, 右脚x1.stl, 右脚底板x1.stl, 右腿内测x1.stl, 右躯干.stl, 大腿固定件x2.stl]
2026-10-12 Update BOM documentation and add tools directory
2026-10-23 Add IMU firmware files and BoBoMaker disclaimer to READMEs
2026-10-23 Add HD-1910 new STL models, IMU firmware and PCB, HAT PCB design
2026-10-23 Rename PCB files to reflect kissqy project origin
2026-11-11 Reorganize duck code into 03-DuckCode and update BOM list
    - Replace BOM docx with Markdown purchase list and drop outdated BOM README
    - Move 03-Code to 03-DuckCode with updated firmware, debug console and training console
    - Ignore local .backup directory and update README paths
2026-11-11 Add remaining 3D print models and assets
    - Add black-part dxf/dwg/stl files for HD-1910-C001
    - Add 0位支架.stp reference model
    - Add assets/wechat.jpg
2026-11-11 Make Chinese the default README and move training console to 04-TrainCode
    - Merge README_CN.md into README.md, add directory descriptions and remove placeholder section; add README_EN.md
    - Document R17 V167 / R1.5.27 versions
    - Move training-console to 04-TrainCode and update path references
    - Add BoBoMaker contact/WeChat QR section to READMEs and BOM list
